spaceconcordia/Consat1Electrical/EPS/eps-v1-1-1-notes.txt

to test

if power is applied to the BCRs, with no battery attached, will they provide current to the regulators?
better BCRs
