spaceconcordia/Consat1Electrical/Wiring Harness/Consat1 Wiring Harness BOM.ods

ID | Part | Validate? | Manufacturer | Manufacturer Part # | Device | Package | Quantity | Description | Location | Value | Alt Value 1 | Alt Value 2 | Design Reference | Validation Note | URL
1 |  |  | Samtec | SMA-J-P-H-ST-PN2 | 50Ohm RF Con |  | 1 |  | ECU Mounted RF connector; ACS Area wiring harness
2 |  |  | Samtec | 415-0026-006 | 50Ohm RF Cable |  | 1 |  | RF cable; ACS Area wiring harness |  |  |  |  |  | http://www.digikey.ca/product-detail/en/415-0026-006/J3406-ND/457081
3
4 |  |  |  |  | DB25, male
5 |  |  |  |  | DB25, 2 sided?
6
7
8
9
10
11
12 |  |  | Harwin | M80-8120605 | DIL MALE SMALL BORE CRIMP CONN |  | 4 | 6 pin crimp connection | Solar Panel Mounted; GlenAir connector for power and thermistors; Payload Area |  |  |  |  |  | http://www.digikey.ca/product-search/en?keywords=M80-8120605
13 |  |  | Harwin | M80-8880605 | CONN RECEPT 2MM 6POS 24-28AWG |  | 4 | 6 pin crimp connection | Wiring harness, connect to solar panel connectors |  |  |  |  |  | http://www.digikey.ca/product-detail/en/M80-8880605/952-1197-ND/2264186
14 |  |  | Glenair | GLENAIR-171-006-6-S-6-7-18 |  |  | ? | 6 pin crimp | ???? possibly used to mount on solar panel
15
16
17
18
19
20
21
22
23
24
25
