spaceconcordia/Consat1Electrical/EPS/eps-v1-1-bom.ods

Sheet: EPS BOM
Part | Validate? | Manufacturer Part # | Device | Package | Description | Sub_Cct | Location | Value | Alt Value 1 | Alt Value 2 | Design Reference | Validation Note
C1 | No | ECH-U1H182GX5 | 1.8nF | C-USC0805 | IC4 (5v reg) compensation network cap | 5V_LTC3872 | EPS PCB
C2 | No | C0805C470J5GACTU | 47pF | C-USC0805 | IC4 (5v reg) compensation network cap | 5V_LTC3872 | EPS PCB
C3 | No | ECH-U1H101JX5 | 100pF | C-USC0805 | IC4 (5v reg) soft start timer cap | 5V_LTC3872 | EPS PCB
C4 | No | T530X157M016ATE015 | 150uF | CPOL-USD/7343-31R | IC4 (5v reg) output cap | 5V_LTC3872 | EPS PCB
C5 | No | C0805C222K5RACTU | 2.2nF | C-USC0805 | IC3 (9v reg) compensation network cap | 9V_LTC3872 | EPS PCB
C6 | No | ECH-U1H101JX5 | 100pF | C-USC0805 | IC3 (9v reg) compensation network cap | 9V_LTC3872 | EPS PCB
C7 | No | ECH-U1H101JX5 | 100pF | C-USC0805 | IC3 (9v reg) soft start timer cap | 9V_LTC3872 | EPS PCB
C8 | No | T530X157M016ATE015 | 150uF | CPOL-USD/7343-31R | IC3 (9v reg) output cap | 9V_LTC3872 | EPS PCB
C9 | No | C0805C104M3RACTU | 0.1uF | C-USC0805 | IC3 (9v reg) Vin decoupling capacitor | 9V_LTC3872 | EPS PCB
C10 | No | C0805C104M3RACTU | 0.1uF | C-USC0805 | IC4 (5v reg) Vin decoupling capacitor | 5V_LTC3872 | EPS PCB
C11 | Maybe | T530X157M016ATE015 | 150uF | CPOL-USD/7343-31R | IC4 (5v reg) input cap | 5V_LTC3872 | EPS PCB
C12 | No | T530X157M016ATE015 | 150uF | CPOL-USD/7343-31R | IC3 (9v reg) input cap | 9V_LTC3872 | EPS PCB
C13 | No | C0805C104M3RACTU | 0.1uF | C-USC0805 | IC5 (Bat. Telemtry) input filter cap | INA291_BATTLM | EPS PCB
C14 | No | C0805C104M3RACTU | 0.1uF | C-USC0805 | IC5 (Bat. Telemtry) decoupling cap | INA291_BATTLM | EPS PCB
C15 | No | C0805C104M3RACTU | 0.1uF | C-USC0805 | IC6 (Bat. Temp Ctrl) decoupling cap | HTRCTL_1 | EPS PCB
C16 | No | C0805C104M3RACTU | 0.1uF | C-USC0805 | IC7 (Bat. Temp Ctrl) decoupling cap | HTRCTL_2 | EPS PCB
C19 | No | C0805C105K8NACTU | 1uF | C-USC0805 | IC9 (General Telemtry) decoupling cap | AD7998_VTLM | EPS PCB
C20 | No | C0805C104M3RACTU | 0.1uF | C-USC0805 | IC9 (General Telemtry) decoupling cap | AD7998_VTLM | EPS PCB
D1 | No | PMEG3050EP,115 | PMEG3050EP | SOD128 | IC4 (5v reg) boost diode | 5V_LTC3872 | EPS PCB
D2 | No | PMEG3050EP,115 | PMEG3050EP | SOD128 | IC3 (9v reg) boost diode | 9V_LTC3872 | EPS PCB
D3 | No | PMEG3050EP,115 | PMEG3050EP | SOD128 | IC3 (9v reg) blocking diode | 9V_LTC3872 | EPS PCB
D4 | No | PMEG3050EP,115 | PMEG3050EP | SOD128 | IC4 (5v reg) blocking diode | 5V_LTC3872 | EPS PCB
H1 | No | ESQ-125-XX-X-D | ESQ-125-XX-X-D | 52 pin header | EPS to ECU interface | INTERFACE | EPS PCB
H2 | No | ESQ-125-XX-X-D | ESQ-125-XX-X-D | 52 pin header | EPS to ECU interface | INTERFACE | EPS PCB
IC1 | No | MIC79110-4.2YML TR | MIC79110 | MLF10-EP | MICREL 79110 Linear battery charger | MIC79110_BCR1 | EPS PCB
IC2 | No | MIC79110-4.2YML TR | MIC79110 | MLF10-EP | MICREL 79110 Linear battery charger | MIC79110_BCR2 | EPS PCB
IC3 | No | LTC3872ETS8#TRMPBF | LT3872 | TSOT23-8 | LTC3872 boost regulator, 5v | 5V_LTC3872 | EPS PCB
IC4 | No | LTC3872ETS8#TRMPBF | LT3872 | TSOT23-8 | LTC3872 boost regulator, 9v | 9V_LTC3872 | EPS PCB
IC5 | No | INA219AID | INA219-D | SO08 | Battery V-I-P telemetry, I2C bus | INA291_BATTLM | EPS PCB
IC6 | Maybe | NCS2200SN1T1G | NCS2200 | SOT23-5 | Battery Thermal Control Comparator | HTRCTL_1 | EPS PCB |  |  |  |  | Max Vin is 6v, need to verify that 5V line DOES NOT exceed this
IC7 | Maybe | NCS2200SN1T1G | NCS2200 | SOT23-5 | Battery Thermal Control Comparator | HTRCTL_2 | EPS PCB |  |  |  |  | Max Vin is 6v, need to verify that 5V line DOES NOT exceed this
IC8 | No | TLV70233DBVR | TLV70233DBVR | SOT23-5 | 3.3V linear regulator | 3_3V_REG | EPS PCB
IC9 | No | AD7998 | AD7998 | TSSOP-20 | Voltage A2D, General Telemetry, I2C bus | AD7998_VTLM | EPS PCB
IC10 | No | MAX4374-10UMAX | MAX4374-10UMAX | 10UMAX | Overcurrent Warning and Reset | OVI_RESET | EPS PCB
IC11 | No | TLV70228DBV | TLV70228DBV | SOT23-5 | 2.8V linear regulator | OVI_RESET | EPS PCB
L1 | No | DR125-2R2 | DR125-2R2 | 12.5x12.5 mm SMD | Inductor, Ferrite Core, IC4/5V boost regulator | 5V_LTC3872 | EPS PCB
L2 | No | DR125-8R2 | DR125-8R2 | 12.5x12.5 mm SMD | Inductor, Ferrite Core, IC4/9V boost regulator | 9V_LTC3872 | EPS PCB
Q1 | No | SI7448DP-T1-E3 | SI7448DP | PPAK-SO08-EP | nMOS, IC4 (5v boost reg) switching element | 5V_LTC3872 | EPS PCB
Q2 | No | SI7448DP-T1-E3 | SI7448DP | PPAK-SO08-EP | nMOS, IC3 (9v boost reg) switching element | 9V_LTC3872 | EPS PCB
Q3 | No | SI7448DP-T1-E3 | SI7448DP | PPAK-SO08-EP | nMOS, IC7, battery heater enable | HTRCTL_2 | EPS PCB
Q4 | No | SI7485DP-T1-GE3 | SI7485DP | PPAK-SO08-EP | pMOS, IC4/5V reg enable/reset switch, controlled by IC10 | OVI_RESET | EPS PCB
Q6 | No | SI7485DP-T1-GE3 | SI7485DP | PPAK-SO08-EP | pMOS, AHRM enable | AHRC | EPS PCB
Q8 | No | SI7485DP-T1-GE3 | SI7485DP | PPAK-SO08-EP | pMOS, IC3/9V reg enable | 9V_LTC3872 | EPS PCB
Q9 | No | SI7448DP-T1-E3 | SI7448DP | PPAK-SO08-EP | nMOS, IC6, battery heater enable | HTRCTL_1 | EPS PCB
R1 | No | ERJ-8ENF6342V | 63.4kOhm | R-US_M1206 | IC4 (5v reg) feedback voltage divider, top | 5V_LTC3872 | EPS PCB
R2 | No | ERJ-8ENF5493V | 549kOhm | R-US_M1206 | IC7 (Bat. Temp Ctrl) thermistor voltage divider, top | HTRCTL_2 | EPS PCB
R3 | No | ERJ-8ENF2003V | 200kOhm | R-US_M1206 | IC7 (Bat. Temp Ctrl) reference voltage divider, top | HTRCTL_2 | EPS PCB
R4 | No | ERJ-8ENF1742V | 17.4kOhm | R-US_M1206 | IC4 (5v reg) compensation network resistor | 5V_LTC3872 | EPS PCB
R5 | No | ERJ-8GEYJ203V | 20kOhm | R-US_M1206 | IC4 (5v reg) feedback voltage divider, bottom | 5V_LTC3872 | EPS PCB
R6 | No | ERJ-8GEYJ203V | 20kOhm | R-US_M1206 | Q8 Pullup resistor; 9V regulator control | 9V_LTC3872 | EPS PCB
R7 | No | ERJ-8ENF2322V | 23.2kOhm | R-US_M1206 | IC3 (9v reg) compensation network resistor | 9V_LTC3872 | EPS PCB
R8 | No | ERJ-8ENF1002V | 10kOhm | R-US_M1206 | IC3 (9v reg) feedback voltage divider, bottom | 9V_LTC3872 | EPS PCB
R9 | No | ERA-8AEB6492V | 64.9kOhm | R-US_M1206 | IC3 (9v reg) feedback voltage divider, top | 9V_LTC3872 | EPS PCB
R10 | No | ERJ-8ENF2213V | 221kOhm | R-US_M1206 | IC7 (Bat. Temp Ctrl) reference voltage divider, bottom | HTRCTL_2 | EPS PCB
R11 | No |  |  |  | IC7 (Bat. Temp Ctrl) output pullup resistor NOT NEEDED | HTRCTL_2 | EPS PCB
R12 | No | ERA-8AEB104V | 100kOhm | R-US_M1206 | IC9 (General Telemtry) pulldown resistor | AD7998_VTLM | EPS PCB
R13 | Maybe | ERJ-8BWJR010V | 0.01Ohm | R-US_M1206 | IC5 (Bat. Telemtry) sense resistor | INA291_BATTLM | EPS PCB
R14 | No | ERJ-8ENF10R0V | 10Ohm | R-US_M1206 | IC5 (Bat. Telemtry) input filter resistor | INA291_BATTLM | EPS PCB
R15 | No | ERJ-8ENF10R0V | 10Ohm | R-US_M1206 | IC5 (Bat. Telemtry) input filter resistor | INA291_BATTLM | EPS PCB
R16 | No | ERA-8AEB202V | 2kOhm | R-US_M1206 | IC2 (BCR) End-of-Charge set resistor | MIC79110_BCR2 | EPS PCB
R17 | No | ERJ-8ENF3400V | 340Ohm | R-US_M1206 | IC2 (BCR) Current-Charge set resistor | MIC79110_BCR2 | EPS PCB
R18 | No | RMCF1206FT3M40 | 3.4MOhm | R-US_M1206 | IC2 (BCR) voltage-divider, top, charge cycle reset comparison | MIC79110_BCR2 | EPS PCB
R19 | No | ERJ-8ENF1004V | 1MOhm | R-US_M1206 | IC2 (BCR) voltage-divider, bottom, charge cycle reset comparison | MIC79110_BCR2 | EPS PCB
R20 | No | ERA-8AEB202V | 2kOhm | R-US_M1206 | IC1 (BCR) End-of-Charge set resistor | MIC79110_BCR1 | EPS PCB
R21 | No | ERJ-8ENF3400V | 340Ohm | R-US_M1206 | IC1 (BCR) Current-Charge set resistor | MIC79110_BCR1 | EPS PCB
R22 | No | RMCF1206FT3M40 | 3.4MOhm | R-US_M1206 | IC1 (BCR) voltage-divider, top, charge cycle reset comparison | MIC79110_BCR1 | EPS PCB
R23 | No | ERJ-8ENF1004V | 1MOhm | R-US_M1206 | IC1 (BCR) voltage-divider, bottom, charge cycle reset comparison | MIC79110_BCR1 | EPS PCB
R24 | No | ERJ-8GEYJ203V | 20kOhm | R-US_M1206 | Q6 Pullup resistor; AHRM control | AHRC | EPS PCB
R25 | No | ERJ-8ENF5493V | 549kOhm | R-US_M1206 | IC6 (Bat. Temp Ctrl) thermistor voltage divider, top | HTRCTL_1 | EPS PCB
R26 | No | ERJ-8ENF2003V | 200kOhm | R-US_M1206 | IC6 (Bat. Temp Ctrl) reference voltage divider, top | HTRCTL_1 | EPS PCB
R27 | No | ERJ-8ENF2213V | 221kOhm | R-US_M1206 | IC6 (Bat. Temp Ctrl) reference voltage divider, bottom | HTRCTL_1 | EPS PCB
R28 | No |  |  |  | IC6 (Bat. Temp Ctrl) output pullup resistor NOT NEEDED | HTRCTL_1 | EPS PCB
R29 | No | ERJ-8ENF1473V | 147kOhm | R-US_M1206 | IC10 (Current OP) voltage-divider, top, current reset comparison | OVI_RESET | EPS PCB
R30 | No | ERJ-8ENF1333V | 133kOhm | R-US_M1206 | IC10 (Current OP) voltage-divider, top, current warning comparison | OVI_RESET | EPS PCB
R31 | No | ERJ-8ENF6342V | 63.4kOhm | R-US_M1206 | IC10 (Current OP) voltage-divider, bottom, current warning comparison | OVI_RESET | EPS PCB
R32 | No | ERJ-8ENF5362V | 53.6kOhm | R-US_M1206 | IC10 (Current OP) voltage-divider, bottom, current reset comparison | OVI_RESET | EPS PCB
R33 | No | ERJ-8ENF1004V | 1MOhm | R-US_M1206 | IC9 (General Telemtry) voltage-divider, bottom, SP1_3 measurement | AD7998_VTLM | EPS PCB
R34 | No | ERJ-8ENF2004V | 2MOhm | R-US_M1206 | IC9 (General Telemtry) voltage-divider, top, SP1_3 measurement | AD7998_VTLM | EPS PCB
R35 | No | ERJ-8ENF1004V | 1MOhm | R-US_M1206 | IC9 (General Telemtry) voltage-divider, bottom, SP2_4 measurement | AD7998_VTLM | EPS PCB
R36 | No | ERJ-8ENF2004V | 2MOhm | R-US_M1206 | IC9 (General Telemtry) voltage-divider, top, SP2_4 measurement | AD7998_VTLM | EPS PCB
R37 | No | WSL1206R0300FEA | 0.03Ohm | R-US_M1206 | IC10 (Current OP) sense resistor | OVI_RESET | EPS PCB
R38 | No | ERJ-8GEYJ203V | 20kOhm | R-US_M1206 | IC10 (Current OP) pullup resistor, current warning signal | OVI_RESET | EPS PCB
R39 | No | ERJ-8GEYJ203V | 20kOhm | R-US_M1206 | Q4 Pullup resistor; 5V regulator enable/reset | 5V_LTC3872 | EPS PCB
EXT1 | No | RL2007-1723-103-SA | 3kOhm | through-hole | thermistor, NTC | SLRPNL_1 | Solar Panel1
EXT2 | No | RL2007-1723-103-SA | 3kOhm | through-hole | thermistor, NTC | SLRPNL_1 | Solar Panel1
EXT3 | No | 3G30SCA | Photovoltaic Cell |  | AzurSpace 3G30A Solar cell, Coverglass and CIC Interconnects | SLRPNL_1 | Solar Panel1
EXT4 | No | 3G30SCA | Photovoltaic Cell |  | AzurSpace 3G30A Solar cell, Coverglass and CIC Interconnects | SLRPNL_1 | Solar Panel1
EXT5 | No | 3G30SCA | Photovoltaic Cell |  | AzurSpace 3G30A Solar cell, Coverglass and CIC Interconnects | SLRPNL_1 | Solar Panel1
EXT6 | No | 3G30SCA | Photovoltaic Cell |  | AzurSpace 3G30A Solar cell, Coverglass and CIC Interconnects | SLRPNL_1 | Solar Panel1
EXT7 | No | 3G30SCA | Photovoltaic Cell |  | AzurSpace 3G30A Solar cell, Coverglass and CIC Interconnects | SLRPNL_1 | Solar Panel1
EXT8 | No | 3G30SCA | Photovoltaic Cell |  | AzurSpace 3G30A Solar cell, Coverglass and CIC Interconnects | SLRPNL_1 | Solar Panel1
EXT9 | No | RL2007-1723-103-SA | 3kOhm | through-hole | thermistor, NTC | SLRPNL_2 | Solar Panel2
EXT10 | No | RL2007-1723-103-SA | 3kOhm | through-hole | thermistor, NTC | SLRPNL_2 | Solar Panel2
EXT11 | No | 3G30SCA | Photovoltaic Cell |  | AzurSpace 3G30A Solar cell, Coverglass and CIC Interconnects | SLRPNL_2 | Solar Panel2
EXT12 | No | 3G30SCA | Photovoltaic Cell |  | AzurSpace 3G30A Solar cell, Coverglass and CIC Interconnects | SLRPNL_2 | Solar Panel2
EXT13 | No | 3G30SCA | Photovoltaic Cell |  | AzurSpace 3G30A Solar cell, Coverglass and CIC Interconnects | SLRPNL_2 | Solar Panel2
EXT14 | No | 3G30SCA | Photovoltaic Cell |  | AzurSpace 3G30A Solar cell, Coverglass and CIC Interconnects | SLRPNL_2 | Solar Panel2
EXT15 | No | 3G30SCA | Photovoltaic Cell |  | AzurSpace 3G30A Solar cell, Coverglass and CIC Interconnects | SLRPNL_2 | Solar Panel2
EXT16 | No | 3G30SCA | Photovoltaic Cell |  | AzurSpace 3G30A Solar cell, Coverglass and CIC Interconnects | SLRPNL_2 | Solar Panel2
EXT17 | No | RL2007-1723-103-SA | 3kOhm | through-hole | thermistor, NTC | SLRPNL_3 | Solar Panel3
EXT18 | No | RL2007-1723-103-SA | 3kOhm | through-hole | thermistor, NTC | SLRPNL_3 | Solar Panel3
EXT19 | No | 3G30SCA | Photovoltaic Cell |  | AzurSpace 3G30A Solar cell, Coverglass and CIC Interconnects | SLRPNL_3 | Solar Panel3
EXT20 | No | 3G30SCA | Photovoltaic Cell |  | AzurSpace 3G30A Solar cell, Coverglass and CIC Interconnects | SLRPNL_3 | Solar Panel3
EXT21 | No | 3G30SCA | Photovoltaic Cell |  | AzurSpace 3G30A Solar cell, Coverglass and CIC Interconnects | SLRPNL_3 | Solar Panel3
EXT22 | No | 3G30SCA | Photovoltaic Cell |  | AzurSpace 3G30A Solar cell, Coverglass and CIC Interconnects | SLRPNL_3 | Solar Panel3
EXT23 | No | 3G30SCA | Photovoltaic Cell |  | AzurSpace 3G30A Solar cell, Coverglass and CIC Interconnects | SLRPNL_3 | Solar Panel3
EXT24 | No | 3G30SCA | Photovoltaic Cell |  | AzurSpace 3G30A Solar cell, Coverglass and CIC Interconnects | SLRPNL_3 | Solar Panel3
EXT25 | No | RL2007-1723-103-SA | 3kOhm | through-hole | thermistor, NTC | SLRPNL_4 | Solar Panel4
EXT26 | No | RL2007-1723-103-SA | 3kOhm | through-hole | thermistor, NTC | SLRPNL_4 | Solar Panel4
EXT27 | No | 3G30SCA | Photovoltaic Cell |  | AzurSpace 3G30A Solar cell, Coverglass and CIC Interconnects | SLRPNL_4 | Solar Panel4
EXT28 | No | 3G30SCA | Photovoltaic Cell |  | AzurSpace 3G30A Solar cell, Coverglass and CIC Interconnects | SLRPNL_4 | Solar Panel4
EXT29 | No | 3G30SCA | Photovoltaic Cell |  | AzurSpace 3G30A Solar cell, Coverglass and CIC Interconnects | SLRPNL_4 | Solar Panel4
EXT30 | No | 3G30SCA | Photovoltaic Cell |  | AzurSpace 3G30A Solar cell, Coverglass and CIC Interconnects | SLRPNL_4 | Solar Panel4
EXT31 | No | 3G30SCA | Photovoltaic Cell |  | AzurSpace 3G30A Solar cell, Coverglass and CIC Interconnects | SLRPNL_4 | Solar Panel4
EXT32 | No | 3G30SCA | Photovoltaic Cell |  | AzurSpace 3G30A Solar cell, Coverglass and CIC Interconnects | SLRPNL_4 | Solar Panel4
EXT33 | No | 1N5817-E3/54 |  |  | diode, schottky, 1A, blocking diode | SLRPNL_HRNS | Wiring Harness
EXT34 | No | 1N5817-E3/54 |  |  | diode, schottky, 1A, blocking diode | SLRPNL_HRNS | Wiring Harness
EXT35 | No | 1N5817-E3/54 |  |  | diode, schottky, 1A, blocking diode | SLRPNL_HRNS | Wiring Harness
EXT36 | No | 1N5817-E3/54 |  |  | diode, schottky, 1A, blocking diode | SLRPNL_HRNS | Wiring Harness
EXT37 | No | P0115-RA100 |  |  | Allflex 115ohm Polymide Heater | HTRCTL_1,HTRCTL_2 | Battery Pack
EXT38 | No | P0115-RA100 |  |  | Allflex 115ohm Polymide Heater | HTRCTL_1,HTRCTL_2 | Battery Pack
EXT39 | No | P0115-RA100 |  |  | Allflex 115ohm Polymide Heater | HTRCTL_1,HTRCTL_2 | Battery Pack
EXT40 | No | P0115-RA100 |  |  | Allflex 115ohm Polymide Heater | HTRCTL_1,HTRCTL_2 | Battery Pack
EXT41 | No | P0115-RA100 |  |  | Allflex 115ohm Polymide Heater | HTRCTL_1,HTRCTL_2 | Battery Pack
EXT42 | No | P0115-RA100 |  |  | Allflex 115ohm Polymide Heater | HTRCTL_1,HTRCTL_2 | Battery Pack
EXT43 | No | P0115-RA100 |  |  | Allflex 115ohm Polymide Heater | HTRCTL_1,HTRCTL_2 | Battery Pack
EXT44 | No | P0115-RA100 |  |  | Allflex 115ohm Polymide Heater | HTRCTL_1,HTRCTL_2 | Battery Pack
EXT45 | No | P0115-RA100 |  |  | Allflex 115ohm Polymide Heater | HTRCTL_1,HTRCTL_2 | Battery Pack
EXT46 | No | P0115-RA100 |  |  | Allflex 115ohm Polymide Heater | HTRCTL_1,HTRCTL_2 | Battery Pack
EXT47 | No | P0115-RA100 |  |  | Allflex 115ohm Polymide Heater | HTRCTL_1,HTRCTL_2 | Battery Pack
EXT48 | No | P0115-RA100 |  |  | Allflex 115ohm Polymide Heater | HTRCTL_1,HTRCTL_2 | Battery Pack
EXT49 | No | MF52A1224J4150 | 220kOhm | through-hole | THERMISTOR NTC 220K OHM 5% | HTRCTL_1 | Battery Pack
EXT50 | No | MF52A1224J4150 | 220kOhm | through-hole | THERMISTOR NTC 220K OHM 5% | HTRCTL_2 | Battery Pack
EXT51 | No | # 30006 | 2.6Ah, 3.7V | 18650-CRG | Battery, Lithium-Ion, Tenergy 18650CRG | BATT_PACK | Battery Pack
EXT52 | No | # 30006 | 2.6Ah, 3.7V | 18650-CRG | Battery, Lithium-Ion, Tenergy 18650CRG | BATT_PACK | Battery Pack
EXT53 | No | # 30006 | 2.6Ah, 3.7V | 18650-CRG | Battery, Lithium-Ion, Tenergy 18650CRG | BATT_PACK | Battery Pack
EXT54 | No | # 30006 | 2.6Ah, 3.7V | 18650-CRG | Battery, Lithium-Ion, Tenergy 18650CRG | BATT_PACK | Battery Pack
EXT55 | No | 952-2111-ND |  |  | DIL, male, crimp interconnect | SLRPNL_1 | Solar Panel1
EXT56 | No | 952-2111-ND |  |  | DIL, male, crimp interconnect | SLRPNL_2 | Solar Panel2
EXT57 | No | 952-2111-ND |  |  | DIL, male, crimp interconnect | SLRPNL_3 | Solar Panel3
EXT58 | No | 952-2111-ND |  |  | DIL, male, crimp interconnect | SLRPNL_4 | Solar Panel4

Sheet: EPS BOM_by_SubCct
Part | Manufacturer Part # | Description | Sub_Cct | Location | Value | Alt Value 1 | Alt Value 2 | Design Reference | Validation Note
IC8 | TLV70233DBVR | 3.3V linear regulator | 3_3V_REG | EPS PCB
C1 | ECH-U1H182GX5 | IC4 (5v reg) compensation network cap | 5V_LTC3872 | EPS PCB
C2 | C0805C470J5GACTU | IC4 (5v reg) compensation network cap | 5V_LTC3872 | EPS PCB
C3 | ECH-U1H101JX5 | IC4 (5v reg) soft start timer cap | 5V_LTC3872 | EPS PCB
C4 | T530X157M016ATE015 | IC4 (5v reg) output cap | 5V_LTC3872 | EPS PCB
C10 | C0805C104M3RACTU | IC4 (5v reg) Vin decoupling capacitor | 5V_LTC3872 | EPS PCB
C11 | T530X157M016ATE015 | IC4 (5v reg) input cap | 5V_LTC3872 | EPS PCB
D1 | PMEG3050EP,115 | IC4 (5v reg) boost diode | 5V_LTC3872 | EPS PCB
D4 | PMEG3050EP,115 | IC4 (5v reg) blocking diode | 5V_LTC3872 | EPS PCB
IC3 | LTC3872ETS8#TRMPBF | LTC3872 boost regulator, 5v | 5V_LTC3872 | EPS PCB
L1 | DR125-2R2 | Inductor, Ferrite Core, IC4/5V boost regulator | 5V_LTC3872 | EPS PCB
Q1 | SI7448DP-T1-E3 | nMOS, IC4 (5v boost reg) switching element | 5V_LTC3872 | EPS PCB
R1 | ERJ-8ENF6342V | IC4 (5v reg) feedback voltage divider, top | 5V_LTC3872 | EPS PCB
R4 | ERJ-8ENF1742V | IC4 (5v reg) compensation network resistor | 5V_LTC3872 | EPS PCB
R5 | ERJ-8GEYJ203V | IC4 (5v reg) feedback voltage divider, bottom | 5V_LTC3872 | EPS PCB
R39 | ERJ-8GEYJ203V | Q4 Pullup resistor; 5V regulator enable/reset | 5V_LTC3872 | EPS PCB
C5 | C0805C222K5RACTU | IC3 (9v reg) compensation network cap | 9V_LTC3872 | EPS PCB
C6 | ECH-U1H101JX5 | IC3 (9v reg) compensation network cap | 9V_LTC3872 | EPS PCB
C7 | ECH-U1H101JX5 | IC3 (9v reg) soft start timer cap | 9V_LTC3872 | EPS PCB
C8 | T530X157M016ATE015 | IC3 (9v reg) output cap | 9V_LTC3872 | EPS PCB
C9 | C0805C104M3RACTU | IC3 (9v reg) Vin decoupling capacitor | 9V_LTC3872 | EPS PCB
C12 | T530X157M016ATE015 | IC3 (9v reg) input cap | 9V_LTC3872 | EPS PCB
D2 | PMEG3050EP,115 | IC3 (9v reg) boost diode | 9V_LTC3872 | EPS PCB
D3 | PMEG3050EP,115 | IC3 (9v reg) blocking diode | 9V_LTC3872 | EPS PCB
IC4 | LTC3872ETS8#TRMPBF | LTC3872 boost regulator, 9v | 9V_LTC3872 | EPS PCB
L2 | DR125-8R2 | Inductor, Ferrite Core, IC4/9V boost regulator | 9V_LTC3872 | EPS PCB
Q2 | SI7448DP-T1-E3 | nMOS, IC3 (9v boost reg) switching element | 9V_LTC3872 | EPS PCB
Q8 | SI7485DP-T1-GE3 | pMOS, IC3/9V reg enable | 9V_LTC3872 | EPS PCB
R6 | ERJ-8GEYJ203V | Q8 Pullup resistor; 9V regulator control | 9V_LTC3872 | EPS PCB
R7 | ERJ-8ENF2322V | IC3 (9v reg) compensation network resistor | 9V_LTC3872 | EPS PCB
R8 | ERJ-8ENF1002V | IC3 (9v reg) feedback voltage divider, bottom | 9V_LTC3872 | EPS PCB
R9 | ERA-8AEB6492V | IC3 (9v reg) feedback voltage divider, top | 9V_LTC3872 | EPS PCB
C19 | C0805C105K8NACTU | IC9 (General Telemtry) decoupling cap | AD7998_VTLM | EPS PCB
C20 | C0805C104M3RACTU | IC9 (General Telemtry) decoupling cap | AD7998_VTLM | EPS PCB
IC9 | AD7998 | Voltage A2D, General Telemetry, I2C bus | AD7998_VTLM | EPS PCB
R12 | ERA-8AEB104V | IC9 (General Telemtry) pulldown resistor | AD7998_VTLM | EPS PCB
R33 | ERJ-8ENF1004V | IC9 (General Telemtry) voltage-divider, bottom, SP1_3 measurement | AD7998_VTLM | EPS PCB
R34 | ERJ-8ENF2004V | IC9 (General Telemtry) voltage-divider, top, SP1_3 measurement | AD7998_VTLM | EPS PCB
R35 | ERJ-8ENF1004V | IC9 (General Telemtry) voltage-divider, bottom, SP2_4 measurement | AD7998_VTLM | EPS PCB
R36 | ERJ-8ENF2004V | IC9 (General Telemtry) voltage-divider, top, SP2_4 measurement | AD7998_VTLM | EPS PCB
Q6 | SI7485DP-T1-GE3 | pMOS, AHRM enable | AHRC | EPS PCB
R24 | ERJ-8GEYJ203V | Q6 Pullup resistor; AHRM control | AHRC | EPS PCB
EXT51 | # 30006 | Battery, Lithium-Ion, Tenergy 18650CRG | BATT_PACK | Battery Pack
EXT52 | # 30006 | Battery, Lithium-Ion, Tenergy 18650CRG | BATT_PACK | Battery Pack
EXT53 | # 30006 | Battery, Lithium-Ion, Tenergy 18650CRG | BATT_PACK | Battery Pack
EXT54 | # 30006 | Battery, Lithium-Ion, Tenergy 18650CRG | BATT_PACK | Battery Pack
C15 | C0805C104M3RACTU | IC6 (Bat. Temp Ctrl) decoupling cap | HTRCTL_1 | EPS PCB
IC6 | NCS2200SN1T1G | Battery Thermal Control Comparator | HTRCTL_1 | EPS PCB |  |  |  |  | Max Vin is 6v, need to verify that 5V line DOES NOT exceed this
Q9 | SI7448DP-T1-E3 | nMOS, IC6, battery heater enable | HTRCTL_1 | EPS PCB
R25 | ERJ-8ENF5493V | IC6 (Bat. Temp Ctrl) thermistor voltage divider, top | HTRCTL_1 | EPS PCB
R26 | ERJ-8ENF2003V | IC6 (Bat. Temp Ctrl) reference voltage divider, top | HTRCTL_1 | EPS PCB
R27 | ERJ-8ENF2213V | IC6 (Bat. Temp Ctrl) reference voltage divider, bottom | HTRCTL_1 | EPS PCB
R28 |  | IC6 (Bat. Temp Ctrl) output pullup resistor NOT NEEDED | HTRCTL_1 | EPS PCB
EXT49 | MF52A1224J4150 | THERMISTOR NTC 220K OHM 5% | HTRCTL_1 | Battery Pack
EXT37 | P0115-RA100 | Allflex 115ohm Polymide Heater | HTRCTL_1,HTRCTL_2 | Battery Pack
EXT38 | P0115-RA100 | Allflex 115ohm Polymide Heater | HTRCTL_1,HTRCTL_2 | Battery Pack
EXT39 | P0115-RA100 | Allflex 115ohm Polymide Heater | HTRCTL_1,HTRCTL_2 | Battery Pack
EXT40 | P0115-RA100 | Allflex 115ohm Polymide Heater | HTRCTL_1,HTRCTL_2 | Battery Pack
EXT41 | P0115-RA100 | Allflex 115ohm Polymide Heater | HTRCTL_1,HTRCTL_2 | Battery Pack
EXT42 | P0115-RA100 | Allflex 115ohm Polymide Heater | HTRCTL_1,HTRCTL_2 | Battery Pack
EXT43 | P0115-RA100 | Allflex 115ohm Polymide Heater | HTRCTL_1,HTRCTL_2 | Battery Pack
EXT44 | P0115-RA100 | Allflex 115ohm Polymide Heater | HTRCTL_1,HTRCTL_2 | Battery Pack
EXT45 | P0115-RA100 | Allflex 115ohm Polymide Heater | HTRCTL_1,HTRCTL_2 | Battery Pack
EXT46 | P0115-RA100 | Allflex 115ohm Polymide Heater | HTRCTL_1,HTRCTL_2 | Battery Pack
EXT47 | P0115-RA100 | Allflex 115ohm Polymide Heater | HTRCTL_1,HTRCTL_2 | Battery Pack
EXT48 | P0115-RA100 | Allflex 115ohm Polymide Heater | HTRCTL_1,HTRCTL_2 | Battery Pack
C16 | C0805C104M3RACTU | IC7 (Bat. Temp Ctrl) decoupling cap | HTRCTL_2 | EPS PCB
IC7 | NCS2200SN1T1G | Battery Thermal Control Comparator | HTRCTL_2 | EPS PCB |  |  |  |  | Max Vin is 6v, need to verify that 5V line DOES NOT exceed this
Q3 | SI7448DP-T1-E3 | nMOS, IC7, battery heater enable | HTRCTL_2 | EPS PCB
R2 | ERJ-8ENF5493V | IC7 (Bat. Temp Ctrl) thermistor voltage divider, top | HTRCTL_2 | EPS PCB
R3 | ERJ-8ENF2003V | IC7 (Bat. Temp Ctrl) reference voltage divider, top | HTRCTL_2 | EPS PCB
R10 | ERJ-8ENF2213V | IC7 (Bat. Temp Ctrl) reference voltage divider, bottom | HTRCTL_2 | EPS PCB
R11 |  | IC7 (Bat. Temp Ctrl) output pullup resistor NOT NEEDED | HTRCTL_2 | EPS PCB
EXT50 | MF52A1224J4150 | THERMISTOR NTC 220K OHM 5% | HTRCTL_2 | Battery Pack
C13 | C0805C104M3RACTU | IC5 (Bat. Telemtry) input filter cap | INA291_BATTLM | EPS PCB
C14 | C0805C104M3RACTU | IC5 (Bat. Telemtry) decoupling cap | INA291_BATTLM | EPS PCB
IC5 | INA219AID | Battery V-I-P telemetry, I2C bus | INA291_BATTLM | EPS PCB
R13 | ERJ-8BWJR010V | IC5 (Bat. Telemtry) sense resistor | INA291_BATTLM | EPS PCB
R14 | ERJ-8ENF10R0V | IC5 (Bat. Telemtry) input filter resistor | INA291_BATTLM | EPS PCB
R15 | ERJ-8ENF10R0V | IC5 (Bat. Telemtry) input filter resistor | INA291_BATTLM | EPS PCB
H1 | ESQ-125-XX-X-D | EPS to ECU interface | INTERFACE | EPS PCB
H2 | ESQ-125-XX-X-D | EPS to ECU interface | INTERFACE | EPS PCB
IC1 | MIC79110-4.2YML TR | MICREL 79110 Linear battery charger | MIC79110_BCR1 | EPS PCB
R20 | ERA-8AEB202V | IC1 (BCR) End-of-Charge set resistor | MIC79110_BCR1 | EPS PCB
R21 | ERJ-8ENF3400V | IC1 (BCR) Current-Charge set resistor | MIC79110_BCR1 | EPS PCB
R22 | RMCF1206FT3M40 | IC1 (BCR) voltage-divider, top, charge cycle reset comparison | MIC79110_BCR1 | EPS PCB
R23 | ERJ-8ENF1004V | IC1 (BCR) voltage-divider, bottom, charge cycle reset comparison | MIC79110_BCR1 | EPS PCB
IC2 | MIC79110-4.2YML TR | MICREL 79110 Linear battery charger | MIC79110_BCR2 | EPS PCB
R16 | ERA-8AEB202V | IC2 (BCR) End-of-Charge set resistor | MIC79110_BCR2 | EPS PCB
R17 | ERJ-8ENF3400V | IC2 (BCR) Current-Charge set resistor | MIC79110_BCR2 | EPS PCB
R18 | RMCF1206FT3M40 | IC2 (BCR) voltage-divider, top, charge cycle reset comparison | MIC79110_BCR2 | EPS PCB
R19 | ERJ-8ENF1004V | IC2 (BCR) voltage-divider, bottom, charge cycle reset comparison | MIC79110_BCR2 | EPS PCB
IC10 | MAX4374-10UMAX | Overcurrent Warning and Reset | OVI_RESET | EPS PCB
IC11 | TLV70228DBV | 2.8V linear regulator | OVI_RESET | EPS PCB
Q4 | SI7485DP-T1-GE3 | pMOS, IC4/5V reg enable/reset switch, controlled by IC10 | OVI_RESET | EPS PCB
R29 | ERJ-8ENF1473V | IC10 (Current OP) voltage-divider, top, current reset comparison | OVI_RESET | EPS PCB
R30 | ERJ-8ENF1333V | IC10 (Current OP) voltage-divider, top, current warning comparison | OVI_RESET | EPS PCB
R31 | ERJ-8ENF6342V | IC10 (Current OP) voltage-divider, bottom, current warning comparison | OVI_RESET | EPS PCB
R32 | ERJ-8ENF5362V | IC10 (Current OP) voltage-divider, bottom, current reset comparison | OVI_RESET | EPS PCB
R37 | WSL1206R0300FEA | IC10 (Current OP) sense resistor | OVI_RESET | EPS PCB
R38 | ERJ-8GEYJ203V | IC10 (Current OP) pullup resistor, current warning signal | OVI_RESET | EPS PCB
EXT1 | RL2007-1723-103-SA | thermistor, NTC | SLRPNL_1 | Solar Panel1
EXT2 | RL2007-1723-103-SA | thermistor, NTC | SLRPNL_1 | Solar Panel1
EXT3 | 3G30SCA | AzurSpace 3G30A Solar cell, Coverglass and CIC Interconnects | SLRPNL_1 | Solar Panel1
EXT4 | 3G30SCA | AzurSpace 3G30A Solar cell, Coverglass and CIC Interconnects | SLRPNL_1 | Solar Panel1
EXT5 | 3G30SCA | AzurSpace 3G30A Solar cell, Coverglass and CIC Interconnects | SLRPNL_1 | Solar Panel1
EXT6 | 3G30SCA | AzurSpace 3G30A Solar cell, Coverglass and CIC Interconnects | SLRPNL_1 | Solar Panel1
EXT7 | 3G30SCA | AzurSpace 3G30A Solar cell, Coverglass and CIC Interconnects | SLRPNL_1 | Solar Panel1
EXT8 | 3G30SCA | AzurSpace 3G30A Solar cell, Coverglass and CIC Interconnects | SLRPNL_1 | Solar Panel1
EXT55 | 952-2111-ND | DIL, male, crimp interconnect | SLRPNL_1 | Solar Panel1
EXT9 | RL2007-1723-103-SA | thermistor, NTC | SLRPNL_2 | Solar Panel2
EXT10 | RL2007-1723-103-SA | thermistor, NTC | SLRPNL_2 | Solar Panel2
EXT11 | 3G30SCA | AzurSpace 3G30A Solar cell, Coverglass and CIC Interconnects | SLRPNL_2 | Solar Panel2
EXT12 | 3G30SCA | AzurSpace 3G30A Solar cell, Coverglass and CIC Interconnects | SLRPNL_2 | Solar Panel2
EXT13 | 3G30SCA | AzurSpace 3G30A Solar cell, Coverglass and CIC Interconnects | SLRPNL_2 | Solar Panel2
EXT14 | 3G30SCA | AzurSpace 3G30A Solar cell, Coverglass and CIC Interconnects | SLRPNL_2 | Solar Panel2
EXT15 | 3G30SCA | AzurSpace 3G30A Solar cell, Coverglass and CIC Interconnects | SLRPNL_2 | Solar Panel2
EXT16 | 3G30SCA | AzurSpace 3G30A Solar cell, Coverglass and CIC Interconnects | SLRPNL_2 | Solar Panel2
EXT56 | 952-2111-ND | DIL, male, crimp interconnect | SLRPNL_2 | Solar Panel2
EXT17 | RL2007-1723-103-SA | thermistor, NTC | SLRPNL_3 | Solar Panel3
EXT18 | RL2007-1723-103-SA | thermistor, NTC | SLRPNL_3 | Solar Panel3
EXT19 | 3G30SCA | AzurSpace 3G30A Solar cell, Coverglass and CIC Interconnects | SLRPNL_3 | Solar Panel3
EXT20 | 3G30SCA | AzurSpace 3G30A Solar cell, Coverglass and CIC Interconnects | SLRPNL_3 | Solar Panel3
EXT21 | 3G30SCA | AzurSpace 3G30A Solar cell, Coverglass and CIC Interconnects | SLRPNL_3 | Solar Panel3
EXT22 | 3G30SCA | AzurSpace 3G30A Solar cell, Coverglass and CIC Interconnects | SLRPNL_3 | Solar Panel3
EXT23 | 3G30SCA | AzurSpace 3G30A Solar cell, Coverglass and CIC Interconnects | SLRPNL_3 | Solar Panel3
EXT24 | 3G30SCA | AzurSpace 3G30A Solar cell, Coverglass and CIC Interconnects | SLRPNL_3 | Solar Panel3
EXT57 | 952-2111-ND | DIL, male, crimp interconnect | SLRPNL_3 | Solar Panel3
EXT25 | RL2007-1723-103-SA | thermistor, NTC | SLRPNL_4 | Solar Panel4
EXT26 | RL2007-1723-103-SA | thermistor, NTC | SLRPNL_4 | Solar Panel4
EXT27 | 3G30SCA | AzurSpace 3G30A Solar cell, Coverglass and CIC Interconnects | SLRPNL_4 | Solar Panel4
EXT28 | 3G30SCA | AzurSpace 3G30A Solar cell, Coverglass and CIC Interconnects | SLRPNL_4 | Solar Panel4
EXT29 | 3G30SCA | AzurSpace 3G30A Solar cell, Coverglass and CIC Interconnects | SLRPNL_4 | Solar Panel4
EXT30 | 3G30SCA | AzurSpace 3G30A Solar cell, Coverglass and CIC Interconnects | SLRPNL_4 | Solar Panel4
EXT31 | 3G30SCA | AzurSpace 3G30A Solar cell, Coverglass and CIC Interconnects | SLRPNL_4 | Solar Panel4
EXT32 | 3G30SCA | AzurSpace 3G30A Solar cell, Coverglass and CIC Interconnects | SLRPNL_4 | Solar Panel4
EXT58 | 952-2111-ND | DIL, male, crimp interconnect | SLRPNL_4 | Solar Panel4
EXT33 | 1N5817-E3/54 | diode, schottky, 1A, blocking diode | SLRPNL_HRNS | Wiring Harness
EXT34 | 1N5817-E3/54 | diode, schottky, 1A, blocking diode | SLRPNL_HRNS | Wiring Harness
EXT35 | 1N5817-E3/54 | diode, schottky, 1A, blocking diode | SLRPNL_HRNS | Wiring Harness
EXT36 | 1N5817-E3/54 | diode, schottky, 1A, blocking diode | SLRPNL_HRNS | Wiring Harness

Sheet: BOM by Quantity
Index # | Manufacturer Part # | Quantity/PCB | In stock | To order | Final Qty | Ok?
1 | 1N5817-E3/54 | 4 | 6 | 10 | 16 | Need More!
2 | #30006 | 4 | 5 |  | 5 | Need More!
3 | 3G30SCA | 24 | 30 |  | 30 | ok
4 | 952-2111-ND | 4 | 12 |  | 12 | Need More!
5 | AD7998 | 1 | 5 |  | 5 | ok
6 | C0805C104M3RACTU | 7 | 6 | 40 | 46 | ok
7 | C0805C105K8NACTU | 1 |  | 10 | 10 | ok
8 | C0805C222K5RACTU | 1 | 9 |  | 9 | ok
9 | C0805C470J5GACTU | 1 | 9 |  | 9 | ok
10 | DR125-2R2 | 1 |  | 6 | 6 | ok
11 | DR125-8R2 | 1 |  | 6 | 6 | ok
12 | ECH-U1H101JX5 | 3 | 17 |  | 17 | ok
13 | ECH-U1H182GX5 | 1 | 9 |  | 9 | ok
14 | ERA-8AEB104V | 1 |  | 10 | 10 | ok
15 | ERA-8AEB202V | 2 |  | 10 | 10 | ok
16 | ERA-8AEB6492V | 1 |  | 10 | 10 | ok
17 | ERJ-8BWJR010V | 1 | 10 |  | 10 | ok
18 | ERJ-8ENF1002V | 1 |  | 10 | 10 | ok
19 | ERJ-8ENF1004V | 4 | 8 | 20 | 28 | ok
20 | ERJ-8ENF10R0V | 2 | 18 |  | 18 | ok
21 | ERJ-8ENF1333V | 1 |  | 10 | 10 | ok
22 | ERJ-8ENF1473V | 1 |  | 10 | 10 | ok
23 | ERJ-8ENF1742V | 1 | 9 |  | 9 | ok
24 | ERJ-8ENF2003V | 2 |  | 20 | 20 | ok
25 | ERJ-8ENF2004V | 2 |  | 20 | 20 | ok
26 | ERJ-8ENF2213V | 2 |  | 20 | 20 | ok
27 | ERJ-8ENF2322V | 1 | 9 |  | 9 | ok
28 | ERJ-8ENF3400V | 2 |  | 20 | 20 | ok
29 | ERJ-8ENF5362V | 1 |  | 10 | 10 | ok
30 | ERJ-8ENF5493V | 2 |  | 20 | 20 | ok
31 | ERJ-8ENF6342V | 2 | 9 | 5 | 14 | ok
32 | ERJ-8GEYJ203V | 5 | 13 | 20 | 33 | ok
33 | ESQ-125-XX-X-D | 2 |  |  | 0 | Need More!
34 | INA219AID | 1 | 2 | 6 | 8 | ok
35 | LTC3872ETS8#TRMPBF | 2 | 3 | 8 | 11 | ok
36 | MAX4374-10UMAX | 1 | 6 |  | 6 | ok
37 | MF52A1224J4150 | 2 |  | 20 | 20 | ok
38 | MIC79110-4.2YMLTR | 2 | 1 | 12 | 13 | ok
39 | NCS2200SN1T1G | 2 | 5 | 5 | 10 | ok
40 | P0115-RA100 | 12 | 60 |  | 60 | ok
41 | PMEG3050EP,115 | 4 | 29 |  | 29 | ok
42 | RL2007-1723-103-SA | 8 | 20 |  | 20 | Need More!
43 | RMCF1206FT3M40 | 2 |  | 20 | 20 | ok
44 | SI7448DP-T1-E3 | 4 | 10 | 15 | 25 | ok
45 | SI7485DP-T1-GE3 | 3 | 24 |  | 24 | ok
46 | T530X157M016ATE015 | 4 |  | 20 | 20 | ok
47 | TLV70228DBV | 1 |  | 10 | 10 | ok
48 | TLV70233DBVR | 1 | 4 | 4 | 8 | ok
49 | WSL1206R0300FEA | 1 |  | 10 | 10 | ok
50
