spaceconcordia/Consat1Electrical/Wiring Harness/List of Connectors for CSDC-1 wiring harness.ods

w | Connection type | Number of pins | Wire gauge | Dimensional constraints | Additional constraints | Comments | Link to connector spec sheet | Price for one connector ($) | List of connectors (ivan) | Part Number | price (ivan) | Approved (ivan) | Newark Link | Approved (Greg) | Approved (Ty) | Approved (Shawn)
Payload | Wire to wire | 2 |  |  | RBFP & Dswitches | The male crimp outgasses at 1.01%. Not sure if approved. | http://www.harwin.com/M80-808/M80-8080205-product.html#M80-8080205, http://ca.mouser.com/ProductDetail/Harwin/M80-8980205/ |  |  | M80-8080205 |  | PARTIALLY APPROVED seems to meet all material specs, but missing male part |  |  |  | notes-http://portal.fciconnect.com/portal/page/portal/fciconnect/homepage
 | PCB to wire, vertical | 2 |  |  | goes on upper payload board, power for payload | Mouser lets us buy by the unit, Male PCB: http://ca.mouser.com/ProductDetail/Harwin/M80-8770222/ Female Crimp: http://ca.mouser.com/ProductDetail/Harwin/M80-8980205/ | http://www.harwin.com/M80-877-datamate-2mm-pitch-high-reliability-l-tek-sil-male-vertical-pc-tail-connector-family.html | Male: $3.12 Female: $2.05 | female: http://www.digikey.ca/product-detail/en/M80-8980205/952-1182-ND/2264171 male: http://www.digikey.ca/product-detail/en/M80-8820242/952-1069-5-ND/2264058 | Fmale - M80-8980205 Male - M80-8760222 |  | PARTIALLY APPROVED need to check if the glass filled polyamide they use outgasses or if it can be baked? if it cannot happen, the male part found by Eric on mouser uses a different platic |  | Rejected the connector's wire gauge is too small I recommend these connectors instead MO-889 series instead Fmale - M80-8980205
 | PCB to wire, vertical | 6 |  |  | goes on lower payload board, adc signals, shielded wires |  |  |  | female: http://www.digikey.ca/product-detail/en/M80-8880605/952-1197-ND/2264186 male: http://www.digikey.ca/product-detail/en/M80-8530642/952-1095-5-ND/2264084 male: http://www.digikey.ca/product-detail/en/M80-8280642/952-1161-5-ND/2264150 | Female - M80-8880605 Male Surfacemount - M80-8280642 Male ThroughHole - M80-8530642 |  | PARTIALLY APPROVED need to check if glass filled polyamide outgasses and if it does, look for alternative male connectors |  | Rejected the connector's wire gauge is too small I recommend these connectors instead MO-889 series instead http://www.digikey.ca/product-detail/en/M80-8890605/952-1208-ND/2264197 http://www.digikey.ca/product-detail/en/M80-8540645/952-1882-ND/3727849
 | PCB to wire, 90deg | 4 |  |  | connects between upper and lower payload board | Mouser lets us buy by the unit. Male PCB: http://ca.mouser.com/ProductDetail/Harwin/M80-8760422/ Female Crimp: http://ca.mouser.com/ProductDetail/Harwin/M80-8980405/?qs=sGAEpiMZZMtfXl%252bsADUrUPVIDPSx5SFt | http://www.digikey.ca/product-detail/en/M80-8760422/M80-8760422-ND/2272018 | male: $4.02 Female: $3.35 | female: http://www.digikey.ca/product-detail/en/M80-8890405/952-1207-ND/2264196 male: http://www.digikey.ca/product-detail/en/M80-6672042/952-2102-ND/3728066 male: http://www.digikey.ca/product-detail/en/M80-6660442/952-2095-ND/3728059 male: http://www.digikey.ca/product-detail/en/M80-8510442/952-1127-5-ND/2264116 alternative one row: female: http://www.digikey.ca/product-detail/en/M80-8990405/952-1191-ND/2264180 male: http://www.digikey.ca/product-detail/en/M80-8420442/952-1078-5-ND/2264067 | Female - M80-8890405 Male Surface Mount - M80-6672042 Male Surface Mount - M80-6660442 Male Through Hole - M80-8510442 Female Crimp - M80-8990405 Male - M80-8420442 |  | PARTIALLY APPROVED check of glass filled polyamide outgasses, use alternative connectors on mouser
Unbilical Cord | Wire to wire | 6 | 22–24 for rj45 |  |  |  | http://www.samtec.com/documents/webfiles/pdf/ipl1.pdf |  |  |  |  | PARTIALLY APPROVED couldn't find anything wrong with them, but it doesn't hurt to call Samtec
 | DB15 |  |  |  | Does not have to be DB15, it may have as little as 6 pins, but it must fit the dimensions of a DB15 connector |  |  |  | male: http://www.digikey.ca/product-detail/en/M24308%2F4-11/A34440-ND/1145377 female: http://www.digikey.ca/product-detail/en/M24308%2F2-11/A34439-ND/1145376 |  |  | PARTIALLY APPROVED connectors seem to have some zinc and chromate, ubt I don't know how much of a contamination risk they pose and if we can't just bake the connector. unfortunately, the connector doesn't meet outgassing test in the mil standard for space applications but it meets all other ones - that's not such a good sign
 | DB25 |  |  |  |  |  | http://www.digikey.ca/scripts/dksearch/dksus.dll?vendor=0&keywords=206801-2 |  | male: http://www.digikey.ca/product-detail/en/M24308%2F4-3/A34459-ND/1145391 female: http://www.digikey.ca/product-detail/en/M24308%2F2-283/A34121-ND/1123897 |  |  | PARTIALLY APPROVED connectors seem to have some zinc and chromate, ubt I don't know how much of a contamination risk they pose and if we can't just bake the connector. unfortunately, the connector doesn't meet outgassing test in the mil standard for space applications but it meets all other ones - that's not such a good sign
Elec bay | PCB to wire, vertical or 90deg | 8 | 16 - 20( Ty) |  | CD&H to Battery heaters | Mouser lets us buy by the unit. Male PCB: http://ca.mouser.com/ProductDetail/Harwin/M80-8670822/ Female Crimp 22G: http://www.digikey.ca/scripts/dksearch/dksus.dll?vendor=0&keywords=M80-8890805 | http://www.digikey.ca/scripts/dksearch/dksus.dll?vendor=0&keywords=M80-8670822-ND | Male: $4.43 Female: $6.30 | female: http://www.digikey.ca/product-detail/en/M80-8890805/952-1209-ND/2264198 male: http://www.digikey.ca/product-detail/en/M80-8670805/952-2116-ND/3728080 |  |  | APPROVED
 | PCB to ribbon cable | 50 | 30 |  | CD&H to Q6 | http://www.samtec.com/documents/webfiles/pdf/fftp.pdf |  |  | two row: female: http://www.digikey.ca/product-detail/en/M80-4615005/952-1039-ND/2264028 male: http://www.digikey.ca/product-detail/en/M80-5105042/952-1015-5-ND/2264004 three row: female: http://www.digikey.ca/product-detail/en/M83-LFC1F1N60-0000-000/952-1050-ND/2264039 male: http://www.digikey.ca/product-detail/en/M83-LML3M1N60-0000-000/952-1051-ND/2264040 |  |  | APPROVED
 | PCB to wire, vertical or 90deg | 12 | 20-24 |  | DB 25 to CD&H | Mouser lets us buy by the unit. Male PCB: http://ca.mouser.com/ProductDetail/Harwin/M80-8671222/ Female Crimp: http://www.digikey.ca/scripts/dksearch/dksus.dll?vendor=0&keywords=M80-8891205 | http://www.digikey.ca/scripts/dksearch/dksus.dll?vendor=0&keywords=M80-8671222-ND , http://www.digikey.ca/scripts/dksearch/dksus.dll?vendor=0&keywords=M80-8891205 | Male: $5.30 Female: $8.14 | female: http://www.digikey.ca/product-detail/en/M80-8881205/952-1200-ND/2264189 male: http://www.digikey.ca/product-detail/en/M80-8281242/952-1164-5-ND/2264153 male: http://www.digikey.ca/product-detail/en/M80-8531242/952-1098-5-ND/2264087 right angle: male: http://www.digikey.ca/product-detail/en/M80-8511242/952-1131-5-ND/2264120 |  |  | PARTIALlY APPROVED polyamide!
 | PCB to wire, vertical or 90deg | 2 | 16 - 20 (Ty) |  | batteries to CD&H |  |  |  | female: http://www.digikey.ca/product-detail/en/M80-8980205/952-1182-ND/2264171 male: http://www.digikey.ca/product-detail/en/M80-8820242/952-1069-5-ND/2264058 |  |  | PARTIALLY APPROVED need to check if the glass filled polyamide they use outgasses or if it can be baked? if it cannot happen, the male part found by Eric on mouser uses a different platic
 | PCB to wire, 90deg | 30 | 16 - 20 for cells ( Ty - best guest ), 20-24 for others |  | DB44 to payload board | FInd current and voltage |  |  | two row, 34pin: female: http://www.digikey.ca/product-detail/en/M80-4613405/952-1037-ND/2264026 male: http://www.digikey.ca/product-detail/en/M80-5403442/952-1029-5-ND/2264018 two row, 50pin female: http://www.digikey.ca/product-detail/en/M80-4605005/952-1047-ND/2264036 male: http://www.digikey.ca/product-detail/en/M80-5405042/952-1031-5-ND/2264020 |  |  | APPROVED
 | DB44 | 44 |  |  | Needs to match the dimensions of a DB25, so it will have three rows of pins | http://www.digikey.ca/product-search/en?FV=fff40016,fff8051c,ffec87ba |  |  | male: http://www.digikey.ca/product-detail/en/M24308%2F4-13/A34444-ND/1122047 female: http://www.digikey.ca/product-detail/en/M24308%2F2-13/A34443-ND/1145379 male: http://www.alliedelec.com/search/productdetail.aspx?SKU=70070153 female: http://www.alliedelec.com/images/products/datasheets/bm/HARTING_ELECTRONIK_INC/70070158.pdf crimps (24-26 AWG): http://www.alliedelec.com/search/productdetail.aspx?SKU=70070162 |  |  | PARTIALLY APPROVED connectors seem to have some zinc and chromate, ubt I don't know how much of a contamination risk they pose and if we can't just bake the connector. unfortunately, the connector doesn't meet outgassing test in the mil standard for space applications but it meets all other ones - that's not such a good sign
Below Elec Bay | 4 X PCB to wire, 90deg | 6 | 16 - 20 ( Ty ) |  | Solar Panels to DB44 | Mouser lets us buy by the unit. Male PCB http://ca.mouser.com/ProductDetail/Harwin/M80-8760622/ Female Crimp 22G : http://ca.mouser.com/ProductDetail/Harwin/M80-8990605/?qs=sGAEpiMZZMtsLRyDR9nM10M7wAK5dulT5n53sbpKDF8%3d | http://www.digikey.ca/scripts/dksearch/dksus.dll?vendor=0&keywords=M80-8770622 | Male: $4.25 Female: $4.87 | female: http://www.digikey.ca/product-detail/en/M80-8990605/952-1193-ND/2264182 male: http://www.digikey.ca/product-detail/en/M80-8420642/952-1080-5-ND/2264069 |  |  | PARTIALLY APPROVED connectors on mouser: everything is fine, but the connector needs to be at 90deg with the PCB - edited to accomodate 90deg connector. connectors on digikey: polyamide!
 | PCB to wire, vertical | 3 |  |  | goes to DB44, need to be shielded | Mouser lets us buy by the unit. Male PCB http://ca.mouser.com/ProductDetail/Harwin/M80-8770322/?qs=sGAEpiMZZMtsLRyDR9nM12b9fuej8UjTmexQPLryR4o%3d Female Crimp: http://ca.mouser.com/ProductDetail/Harwin/M80-8980305/?qs=sGAEpiMZZMveaWjGIsDKYtiKQzzClW6L | http://www.digikey.com/product-detail/en/M80-8770322/M80-8770322-ND/2272010 | Male: $3.25 Female: $3.07 | female: http://www.digikey.ca/product-detail/en/M80-8990305/952-1190-ND/2264179 male: http://www.digikey.ca/product-detail/en/M80-8040322/952-1950-ND/3727917 male: http://www.digikey.ca/product-detail/en/M80-8460342/952-1949-ND/3727916 note the male ones are 90deg but it may be fine |  |  | APPROVED
 | 3 X PCB to wire, vertical | 4 |  |  | two of the connections are to interconnect the ACS boards (short wires) | if we buy it from here, Male PCB http://ca.mouser.com/ProductDetail/Harwin/M80-8770422/ they have 4 left, and we can buy by the unit. Female Crimp: http://ca.mouser.com/ProductDetail/Harwin/M80-8980405/?qs=sGAEpiMZZMtfXl%252bsADUrUPVIDPSx5SFt | http://www.digikey.ca/scripts/dksearch/dksus.dll?vendor=0&keywords=M80-8770422-ND | Male: $3.37 Female: $3.35 | female: http://www.digikey.ca/product-detail/en/M80-8990405/952-1191-ND/2264180 male: http://www.digikey.ca/product-detail/en/M80-8820442/952-1071-5-ND/2264060 |  |  | PARTIALLY APPROVED mouser - fine digikey - polyamide!
 | PCB to wire, vertical | 2 |  |  |  | Male PCB: http://ca.mouser.com/ProductDetail/Harwin/M80-8770222/ Female Crimp: http://ca.mouser.com/ProductDetail/Harwin/M80-8980205/ |  | Male: $3.12 Female: $2.05 | female: http://www.digikey.ca/product-detail/en/M80-8980205/952-1182-ND/2264171 male: http://www.digikey.ca/product-detail/en/M80-8820242/952-1069-5-ND/2264058 |  |  | PARTIALLY APPROVED mouser - fine digikey: need to check if the glass filled polyamide they use outgasses or if it can be baked? if it cannot happen, the male part found by Eric on mouser uses a different platic
 |  |  |  |  |  | Additional information:
 |  |  |  |  |  | HARWIN OUTGASSING DATA SHEET: http://www.harwin.com/include/downloads/pdfs/OUTGASSING_DATA_FOR_HARWIN_PRODUCTS_2013-01-22.PDF , mainly looking for connectors made of PBT Valox 420SEO Black, with .33% TML. All the Harwin connectors included in this list fall under this material, except for 2 pin wire-to-wire M80-8080205, which has a 1.01% TML. We might need a tool to remove the latches, and the harwin branded one is ridiculously expensive. http://www.digikey.com.au/scripts/DkSearch/dksus.dll?WT.z_header=search_go&lang=en&x=0&y=0 Perhaps you guys have one, or we could fabricate a similar tool.
 |  |  |  |  |  | Harwin crimp pins: http://www.digikey.ca/product-search/en/connectors-interconnects/rectangular-connectors-contacts/1442670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
 |  |  |  |  |  | polyamide doesn't meet the outgassing requirements, infact it's a common contaminant: http://books.google.ca/books?id=FDr3iFDh7M8C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 but we may be able to bake the connectors to get rid of the contaminants: http://esmat.esa.int/Services/outgassing_data/outgassing_data.html
 |  |  |  |  |  | some of these may be space qualified: http://www.digikey.ca/product-search/en/connectors-interconnects/rectangular-connectors-headers-male-pins/1442547
 |  |  |  | Final list of connectors
 |  |  |  | Module | Connector description | male | female | Required number for one sat | Required number for purchasing
 |  |  |  |  | DB15 (umb. cord) | http://www.digikey.ca/product-detail/en/5-747908-2/A32503-ND/993060 | http://www.digikey.ca/product-detail/en/5-747909-2/A32504-ND/993061 | 1 | 2
 |  |  |  |  | DB25s | http://www.digikey.ca/scripts/dksearch/dksus.dll?vendor=0&keywords=5-747912-2 | http://www.digikey.ca/product-detail/en/5-747913-2/A32508-ND/1014900 | 3 | 6
 |  |  |  | Elec Bay | CDH - 4 pin power | http://www.digikey.ca/product-detail/en/M80-5000000M1-04-331-00-000/952-1255-ND/2264242 | http://www.digikey.ca/product-detail/en/M80-5000000M2-04-331-00-000/952-1652-ND/2616371 | 1 | 2
 |  |  |  |  | CDH - 10 pin power | http://www.digikey.ca/scripts/dksearch/dksus.dll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 | http://www.digikey.ca/product-detail/en/M80-4000000F1-10-325-00-000/952-1651-ND/2616370 | 1 | 2
 |  |  |  |  | CDH - Q6 50 pin |  |  | 1 | 2
 |  |  |  |  | CDH - 8 pin signal | http://www.digikey.ca/product-detail/en/M80-8670805/952-2116-ND/3728080 | http://www.digikey.ca/product-detail/en/M80-8890805/952-1209-ND/2264198 | 1 | 2
 |  |  |  |  | Bottom of Elec Bay to DB25s | http://www.digikey.ca/product-detail/en/M80-8661622/952-2390-5-ND/2272073 | http://www.digikey.ca/product-detail/en/M80-8891605/952-1213-ND/2264202 | 2 | 4
 |  |  |  | Payload boards | Power for Payload | http://www.digikey.ca/product-detail/en/M80-5000000M1-02-331-00-000/952-1243-ND/2264230 | http://www.digikey.ca/product-detail/en/M80-4000000F1-02-325-00-000/952-1242-ND/2264229 | 1 | 2
 |  |  |  |  | Payload signal | http://www.digikey.ca/product-detail/en/M80-8670622/952-2410-5-ND/2272035 | http://www.digikey.ca/scripts/DkSearch/dksus.dll?FullDetail&name=952-1208-ND#matingproducts | 1 | 2
 |  |  |  |  |  |  |  |  | 0
 |  |  |  | Under Elec Bay | Solar Cell connectors | http://www.digikey.ca/product-detail/en/M80-8660622/952-2416-5-ND/2272068 | http://www.digikey.ca/scripts/DkSearch/dksus.dll?FullDetail&name=952-1208-ND#matingproducts | 4 | 8
 |  |  |  |  | Deployment mechanism | http://www.digikey.ca/product-detail/en/M80-5000000M1-02-331-00-000/952-1243-ND/2264230 | http://www.digikey.ca/product-detail/en/M80-4000000F1-02-325-00-000/952-1242-ND/2264229 | 1 | 2
 |  |  |  |  | ACS boards | http://www.digikey.ca/product-detail/en/M80-8790422/952-1956-ND/3727923 | http://www.digikey.ca/product-detail/en/M80-8990405/952-1191-ND/2264180 | 3 | 6
