spaceconcordia/Consat1Electrical/Wiring Harness/Wire Data.ods

 |  |  | Connection details |  |  |  |  |  |  |  | Wiring details
Color Legend |  | Connection ID | Connection name | Location | LRU ID | Connector ID | Pin# | Wire_net | Role (consumer/provider) | Signal type | Gauge | segregation code (opt) | Harness group | Etc. etc. if applicable | Details | Comments
CDH |  | 0001 | DIPLEX_TO_ANT_SIG | TOP 1U | Ant | X17 |  |  |  | Signal
POW |  | 0002 | DIPLEX_TO_ANT_GND | TOP 1U | Ant | X17 |  |  |  | Signal
PAYLOAD |  | 0003 | DIPLEX_TO_ANT_SIG | TOP 1U | DISC | X9 |  |  |  | Signal
COMMS |  | 0004 | DIPLEX_TO_ANT_GND | TOP 1U | DISC | X9 |  |  |  | Signal
 |  | 0005 | Mech_Deploy_Switch_0 | ELEC BAY | DISC | X1 | 1 |  |  | Discrete
 |  | 0006 | Mech_Deploy_Switch_1 | ELEC BAY | DISC | X1 | 2 |  |  | Discrete
 |  | 0007 | FREE | ELEC BAY | DISC | X1 | 3
 |  | 0008 | External_Power_0 | ELEC BAY | DISC | X1 | 4 |  |  | POW
 |  | 0009 | External_Power_1 | ELEC BAY | DISC | X1 | 5 |  |  | POW
 |  | 0010 | FREE | ELEC BAY | DISC | X1 | 6
 |  | 0011 | FREE | ELEC BAY | DISC | X1 | 7
 |  | 0012 | Q6_PC_RS232 | ELEC BAY | DISC | X1 | 8 |  |  | Signal
 |  | 0013 | PC_Q6_RS232 | ELEC BAY | DISC | X1 | 9 |  |  | Signal
 |  | 0014 | FREE | ELEC BAY | DISC | X1 | 10
 |  | 0015 | FREE | ELEC BAY | DISC | X1 | 11
 |  | 0016 | FREE | ELEC BAY | DISC | X1 | 12
 |  | 0017 | FREE | ELEC BAY | DISC | X1 | 13
 |  | 0018 | PA3_JTAG_TDI | ELEC BAY | DISC | X1 | 14 |  |  | Signal
 |  | 0019 | PA3_JTAG_TMS | ELEC BAY | DISC | X1 | 15 |  |  | Signal
 |  | 0020 | PA3_JTAG_TCK | ELEC BAY | DISC | X1 | 16 |  |  | Signal
 |  | 0021 | PA3_JTAG_TDO | ELEC BAY | DISC | X1 | 17 |  |  | Signal
 |  | 0022 | PA3_JTAG_TRST_N | ELEC BAY | DISC | X1 | 18 |  |  | Signal
 |  | 0023 | FREE | ELEC BAY | DISC | X1 | 19
 |  | 0024 | S6_JTAG_TDI | ELEC BAY | DISC | X1 | 20 |  |  | Signal
 |  | 0025 | S6_JTAG_TMS | ELEC BAY | DISC | X1 | 21 |  |  | Signal
 |  | 0026 | S6_JTAG_TCK | ELEC BAY | DISC | X1 | 22 |  |  | Signal
 |  | 0027 | S6_JTAG_TDO | ELEC BAY | DISC | X1 | 23 |  |  | Signal
 |  | 0028 | JTAG_3V3 | ELEC BAY | DISC | X1 | 24 |  |  | POW
 |  | 0029 | JTAG_GND | ELEC BAY | DISC | X1 | 25 |  |  | POW
 |  | 0030 | DIPLEX_TO_ANT_SIG | ELEC BAY | DISC | X8 |  |  |  | Signal
 |  | 0031 | DIPLEX_TO_ANT_GND | ELEC BAY | DISC | X8 |  |  |  | Signal
 |  | 0032 | Mech_Deploy_Switch_0 | TOP 1U | DISC | X4 | 1 |  |  | Discrete
 |  | 0033 | Mech_Deploy_Switch_1 | TOP 1U | DISC | X4 | 2 |  |  | Discrete
 |  | 0034 | FREE | TOP 1U | DISC | X4 | 3
 |  | 0035 | External_Power_0 | TOP 1U | DISC | X4 | 4 |  |  | POW
 |  | 0036 | External_Power_1 | TOP 1U | DISC | X4 | 5 |  |  | POW
 |  | 0037 | FREE | TOP 1U | DISC | X4 | 6
 |  | 0038 | FREE | TOP 1U | DISC | X4 | 7
 |  | 0039 | Q6_PC_RS232 | TOP 1U | DISC | X4 | 8 |  |  | Signal
 |  | 0040 | PC_Q6_RS232 | TOP 1U | DISC | X4 | 9 |  |  | Signal
 |  | 0041 | FREE | TOP 1U | DISC | X4 | 10
 |  | 0042 | FREE | TOP 1U | DISC | X4 | 11
 |  | 0043 | FREE | TOP 1U | DISC | X4 | 12
 |  | 0044 | FREE | TOP 1U | DISC | X4 | 13
 |  | 0045 | PA3_JTAG_TDI | TOP 1U | DISC | X4 | 14 |  |  | Signal
 |  | 0046 | PA3_JTAG_TMS | TOP 1U | DISC | X4 | 15 |  |  | Signal
 |  | 0047 | PA3_JTAG_TCK | TOP 1U | DISC | X4 | 16 |  |  | Signal
 |  | 0048 | PA3_JTAG_TDO | TOP 1U | DISC | X4 | 17 |  |  | Signal
 |  | 0049 | PA3_JTAG_TRST_N | TOP 1U | DISC | X4 | 18 |  |  | Signal
 |  | 0050 | FREE | TOP 1U | DISC | X4 | 19
 |  | 0051 | S6_JTAG_TDI | TOP 1U | DISC | X4 | 20 |  |  | Signal
 |  | 0052 | S6_JTAG_TMS | TOP 1U | DISC | X4 | 21 |  |  | Signal
 |  | 0053 | S6_JTAG_TCK | TOP 1U | DISC | X4 | 22 |  |  | Signal
 |  | 0054 | S6_JTAG_TDO | TOP 1U | DISC | X4 | 23 |  |  | Signal
 |  | 0055 | JTAG_3V3 | TOP 1U | DISC | X4 | 24 |  |  | POW
 |  | 0056 | JTAG_GND | TOP 1U | DISC | X4 | 25 |  |  | POW
 |  | 0057 | DIPLEX_TO_ANT_SIG | ELEC BAY | DIPLX | X11 |  |  |  | Signal
 |  | 0058 | DIPLEX_TO_ANT_GND | ELEC BAY | DIPLX | X11 |  |  |  | Signal
 |  | 0059 | HE100_TX_TO_DIPLEX_SIG | ELEC BAY | HE100 | X12 |  |  |  | Signal
 |  | 0060 | HE100_TX_TO_DIPLEX_GND | ELEC BAY | HE100 | X12 |  |  |  | Signal
 |  | 0061 | HE100_TX_TO_DIPLEX_SIG | ELEC BAY | DIPLX | X14
 |  | 0062 | HE100_TX_TO_DIPLEX_GND | ELEC BAY | DIPLX | X14
 |  | 0063 | HE100_RX_TO_DIPLEX_SIG | ELEC BAY | HE100 | X13
 |  | 0064 | HE100_RX_TO_DIPLEX_GND | ELEC BAY | HE100 | X13
 |  | 0065 | HE100_RX_TO_DIPLEX_SIG | ELEC BAY | DIPLX | X15
 |  | 0066 | HE100_RX_TO_DIPLEX_GND | ELEC BAY | DIPLX | X15
 |  | 0067 | ANTENNA_DEPLOYMENT_+V | ELEC BAY | EPS | H1 | 1 |  |  | POW |  |  |  |  | ANTTENA DEPLOYMENT +V
 |  | 0068 | ANTENNA_DEPLOYMENT_GND | ELEC BAY | EPS | H1 | 3 |  |  | POW |  |  |  |  | ANTTENA DEPLOYMENT -V
 |  | 0069 | THERMALGND1 | ELEC BAY | EPS | H1 | 5 |  |  | Signal GND (Check for floating) |  |  |  |  | CDH PCB THERMISTORS GND
 |  | 0070 | Q6_GPIO_6 | ELEC BAY | EPS | H1 | 7 |  |  | Signal/Discrete? (check if free/unused) |  |  |  |  | Q6_GPIO_6 (unused?)
 |  | 0071 | Q6_GPIO_7 | ELEC BAY | EPS | H1 | 9 |  |  | Signal/Discrete? (check if free/unused) |  |  |  |  | Q6_GPIO_7
 |  | 0072 | Q6_GPIO_8 | ELEC BAY | EPS | H1 | 11 |  |  | Signal/Discrete? (check if free/unused) |  |  |  |  | Q6_GPIO_8
 |  | 0073 | Q6_GPIO_0 | ELEC BAY | EPS | H1 | 13 |  |  | Signal/Discrete? (check if free/unused) |  |  |  |  | Watch Dog Input
 |  | 0074 | GND | ELEC BAY | EPS | H1 | 15 |  |  | POW GND (Check for floating) |  |  |  |  | COMMON GND
 |  | 0075 | RADIO_UART_TX | ELEC BAY | EPS | H1 | 17 |  |  | Signal |  |  |  |  | TRANSCEIVER UART TRANSMIT
 |  | 0076 | GND | ELEC BAY | EPS | H1 | 19 |  |  | POW GND (Check for floating) |  |  |  |  | COMMON GND
 |  | 0077 | PC_Q6_RX_RS232 | ELEC BAY | EPS | H1 | 21 |  |  | Signal
 |  | 0078 | GND | ELEC BAY | EPS | H1 | 23 |  |  | POW GND (Check for floating) |  |  |  |  | COMMON GND
 |  | 0079 | Q6_PC_TX_RS232 | ELEC BAY | EPS | H1 | 25 |  |  | Signal
 |  | 0080 | GND | ELEC BAY | EPS | H1 | 27 |  |  | POW GND (Check for floating) |  |  |  |  | COMMON GND
 |  | 0081 | SOLAR_PANEL_1_3 | ELEC BAY | EPS | H1 | 29 |  |  | POW |  |  |  |  | SOLAR PANEL 1 AND 3
 |  | 0082 | SOLAR_PANEL_GND | ELEC BAY | EPS | H1 | 31 |  |  | POW |  |  |  |  | SOLAR PANEL GROUND
 |  | 0083 | POW_BATT_GND | ELEC BAY | EPS | H1 | 33 |  |  | POW |  |  |  |  | BATTERY -V
 |  | 0084 | POW_BATT_V_TO_LOAD | ELEC BAY | EPS | H1 | 35 |  |  | POW |  |  |  |  | BATTERY +V
 |  | 0085 | GND | ELEC BAY | EPS | H1 | 37 |  |  | POW GND (Check for floating) |  |  |  |  | COMMON GROUND
 |  | 0086 | Q6_AIN_0 | ELEC BAY | EPS | H1 | 39 |  |  | Signal |  |  |  |  | Q6 ADC 0
 |  | 0087 | GND | ELEC BAY | EPS | H1 | 41 |  |  | POW GND (Check for floating) |  |  |  |  | COMMON GND
 |  | 0088 | Q6_AIN_1 | ELEC BAY | EPS | H1 | 43 |  |  | Signal |  |  |  |  | Q6 ADC 1
 |  | 0089 | GND | ELEC BAY | EPS | H1 | 45 |  |  | POW GND (Check for floating) |  |  |  |  | COMMON GND
 |  | 0090 | Q6_AOUT_0 | ELEC BAY | EPS | H1 | 47 |  |  | Signal/Discrete? (check if free/unused) |  |  |  |  | Q6 DAC 0
 |  | 0091 | GND | ELEC BAY | EPS | H1 | 49 |  |  | POW GND (Check for floating) |  |  |  |  | COMMON GND
 |  | 0092 | Q6_AOUT_1 | ELEC BAY | EPS | H1 | 51 |  |  | Signal/Discrete? (check if free/unused) |  |  |  |  | Q6 DAC 1
 |  | 0093 | SOLAR_PANEL_2_4 | ELEC BAY | EPS | H1 | 2 |  |  | POW |  |  |  |  | SOLAR PANEL 2 AND 4
 |  | 0094 | BATTERY_HEATER_+V | ELEC BAY | EPS | H1 | 4 |  |  | POW |  |  |  |  | Battery Heater Power
 |  | 0095 | BATTERY_HEATER_-V | ELEC BAY | EPS | H1 | 6 |  |  | POW |  |  |  |  | Battery Heater Power
 |  | 0096 | BATTERY_THRMSTOR1_+V | ELEC BAY | EPS | H1 | 8 |  |  | Sensor |  |  |  |  | Battery Temp Sense 1
 |  | 0097 | BATTERY_THRMSTOR_-V | ELEC BAY | EPS | H1 | 10 |  |  | Sensor |  |  |  |  | Battery Temp Sense Ground
 |  | 0098 | BATTERY_THRMSTOR2_+V | ELEC BAY | EPS | H1 | 12 |  |  | Sensor |  |  |  |  | Battery Temp Sense 2
 |  | 0099 | GND | ELEC BAY | EPS | H1 | 14 |  |  | POW GND (Check for floating) |  |  |  |  | COMMON GND
 |  | 0100 | POW-3V3 | ELEC BAY | EPS | H1 | 16 |  |  | POW |  |  |  |  | POWER 3V3 - POW_RADIO _3V3 - through payload board
 |  | 0101 | RADIO_UART_RX | ELEC BAY | EPS | H1 | 18 |  |  | Signal |  |  |  |  | TRANSCEIVER UART RECEIVE | Made mistake on sheet
 |  | 0102 | POW-3V3 | ELEC BAY | EPS | H1 | 20 |  |  | POW |  |  |  |  | POWER 3V3
 |  | 0103 | POW-9V | ELEC BAY | EPS | H1 | 22 |  |  | POW |  |  |  |  | POWER 9V
 |  | 0104 | POW-9V | ELEC BAY | EPS | H1 | 24 |  |  | POW |  |  |  |  | POWER 9V
 |  | 0105 | POW-5V | ELEC BAY | EPS | H1 | 26 |  |  | POW |  |  |  |  | POWER 5V
 |  | 0106 | POW-5V | ELEC BAY | EPS | H1 | 28 |  |  | POW |  |  |  |  | POWER 5V
 |  | 0107 | SOLAR_PANEL_GND | ELEC BAY | EPS | H1 | 30 |  |  | POW |  |  |  |  | SOLAR PANEL GROUND
 |  | 0108 | Q6_GPIO_10 | ELEC BAY | EPS | H1 | 32 |  |  | Signal/Discrete? (FIX FIX FIX (GPIO10 used on CDH)) |  |  |  |  | Q6_GPIO_10 ( Use for EPS Board )
 |  | 0109 | GND | ELEC BAY | EPS | H1 | 34 |  |  | POW GND (Check for floating) |  |  |  |  | COMMON GND
 |  | 0110 | Q6_GPIO_13 | ELEC BAY | EPS | H1 | 36 |  |  | Signal |  |  |  |  | PAYLOAD VOLTAGE CONTROL
 |  | 0111 | Q6_GPIO_14 | ELEC BAY | EPS | H1 | 38 |  |  | Signal |  |  |  |  | ANTENNA CONTROL
 |  | 0112 | Q6_GPIO_15 | ELEC BAY | EPS | H1 | 40 |  |  | Signal |  |  |  |  | 3V3 CONTROL
 |  | 0113 | FREE | ELEC BAY | EPS | H1 | 42
 |  | 0114 | GND | ELEC BAY | EPS | H1 | 44 |  |  | POW GND (Check for floating) |  |  |  |  | COMMON GND
 |  | 0115 | FREE | ELEC BAY | EPS | H1 | 46
 |  | 0116 | GND | ELEC BAY | EPS | H1 | 48 |  |  | POW GND (Check for floating) |  |  |  |  | COMMON GND
 |  | 0117 | Q6_GPIO_10 | ELEC BAY | EPS | H1 | 50 |  |  | Signal/Discrete? (FIX FIX FIX (GPIO10 used on EPS)) |  |  |  |  | Q6_GPIO_10 ( Use for EPS Board, not connected on CDH yet )
 |  | 0118 | GND | ELEC BAY | EPS | H1 | 52 |  |  | POW GND (Check for floating) |  |  |  |  | COMMON GND
 |  | 0119 | TOP_TEMP_SOLAR_PANEL-1 | ELEC BAY | EPS | H2 | 1 |  |  | SIGNAL |  |  |  |  | TEMP SENSOR FOR TOP HALF OF SOLAR PANEL
 |  | 0120 | TOP_TEMP_SOLAR_PANEL-2 | ELEC BAY | EPS | H2 | 3 |  |  | SIGNAL |  |  |  |  | TEMP SENSOR FOR TOP HALF OF SOLAR PANEL
 |  | 0121 | TOP_TEMP_SOLAR_PANEL-3 | ELEC BAY | EPS | H2 | 5 |  |  | SIGNAL |  |  |  |  | TEMP SENSOR FOR TOP HALF OF SOLAR PANEL
 |  | 0122 | TOP_TEMP_SOLAR_PANEL-4 | ELEC BAY | EPS | H2 | 7 |  |  | SIGNAL |  |  |  |  | TEMP SENSOR FOR TOP HALF OF SOLAR PANEL
 |  | 0123 | BOTTOM_TEMP_SOLAR_PANEL-1 | ELEC BAY | EPS | H2 | 9 |  |  | SIGNAL |  |  |  |  | TEMP SENSOR FOR BOTTOM HALF OF SOLAR PANEL
 |  | 0124 | BOTTOM_TEMP_SOLAR_PANEL-2 | ELEC BAY | EPS | H2 | 11 |  |  | SIGNAL |  |  |  |  | TEMP SENSOR FOR BOTTOM HALF OF SOLAR PANEL
 |  | 0125 | BOTTOM_TEMP_SOLAR_PANEL-3 | ELEC BAY | EPS | H2 | 13 |  |  | SIGNAL |  |  |  |  | TEMP SENSOR FOR BOTTOM HALF OF SOLAR PANEL
 |  | 0126 | BOTTOM_TEMP_SOLAR_PANEL-4 | ELEC BAY | EPS | H2 | 15 |  |  | SIGNAL |  |  |  |  | TEMP SENSOR FOR BOTTOM HALF OF SOLAR PANEL
 |  | 0127 | GND | ELEC BAY | EPS | H2 | 17 |  |  | POW GND (Check for floating) |  |  |  |  | COMMON GROUND
 |  | 0128 | GND | ELEC BAY | EPS | H2 | 19 |  |  | POW GND (Check for floating) |  |  |  |  | COMMON GROUND
 |  | 0129 | FREE | ELEC BAY | EPS | H2 | 21
 |  | 0130 | FREE | ELEC BAY | EPS | H2 | 23
 |  | 0131 | FREE | ELEC BAY | EPS | H2 | 25
 |  | 0132 | POW_RADIO_3.3V | ELEC BAY | EPS | H2 | 27 |  |  | POW |  |  |  |  | 3V3 LINE FROM POWER FOR TRANSCEIVER(Connecting to H1 on payload board pow_3v3 line)
 |  | 0133 | POW_RADIO_GND | ELEC BAY | EPS | H2 | 29 |  |  | POW |  |  |  |  | GND LINE FROM POWER FOR TRANSCEIVER
 |  | 0134 | MECH_DEPLOYMENT_SWITCH_+V | ELEC BAY | EPS | H2 | 31 |  |  | Discrete |  |  |  |  | MECHANICAL DEPLOYMENT SWITCH +V
 |  | 0135 | MECH_DEPLOYMENT_SWITCH_-V | ELEC BAY | EPS | H2 | 33 |  |  | Discrete |  |  |  |  | MECHANICAL DEPLOYMENT SWITCH -V
 |  | 0136 | FREE | ELEC BAY | EPS | H2 | 35
 |  | 0137 | FREE | ELEC BAY | EPS | H2 | 37
 |  | 0138 | FREE | ELEC BAY | EPS | H2 | 39
 |  | 0139 | FREE | ELEC BAY | EPS | H2 | 41
 |  | 0140 | FREE | ELEC BAY | EPS | H2 | 43
 |  | 0141 | POW_RADIO_VBATT | ELEC BAY | EPS | H2 | 45 |  |  | POW |  |  |  |  | POWER FOR TRANSCEIVER BATTERY
 |  | 0142 | FREE | ELEC BAY | EPS | H2 | 47
 |  | 0143 | FREE | ELEC BAY | EPS | H2 | 49
 |  | 0144 | EXTERNAL_POWER_GND | ELEC BAY | EPS | H2 | 51 |  |  | POW |  |  |  |  | EXTERNAL POWER WHEN POWER CONTINUITY PLUG IS IN
 |  | 0145 | POW_BATT_V_FROM_BCR | ELEC BAY | EPS | H2 | 2 |  |  | POW |  |  |  |  | BATTERY V+
 |  | 0146 | GND | ELEC BAY | EPS | H2 | 4 |  |  | POW GND (Check for floating) |  |  |  |  | COMMON GND
 |  | 0147 | Q6_SPI_SCLK | ELEC BAY | EPS | H2 | 6 |  |  | Signal |  |  |  |  | Q6 SPI CLOCK
 |  | 0148 | Q6_SPI_SDO_MOSI | ELEC BAY | EPS | H2 | 8 |  |  | Signal |  |  |  |  | Q6 SPI DATA OUT ( MASTER OUT SLAVE IN )
 |  | 0149 | Q6_SPI_SDI_MISO | ELEC BAY | EPS | H2 | 10 |  |  | Signal |  |  |  |  | Q6 SPI DATA IN ( MASTER IN SLAVE OUT )
 |  | 0150 | Q6_SPI_CS1 | ELEC BAY | EPS | H2 | 12 |  |  | Signal |  |  |  |  | Q6 SPI CHIP SELECT 1
 |  | 0151 | Q6_SPI_CS0 | ELEC BAY | EPS | H2 | 14 |  |  | Signal |  |  |  |  | Q6 SPI CHIP SELECT 0
 |  | 0152 | GND | ELEC BAY | EPS | H2 | 16 |  |  | POW GND (Check for floating) |  |  |  |  | COMMON GND
 |  | 0153 | Q6_I2C_SDA_1 | ELEC BAY | EPS | H2 | 18 |  |  | Signal |  |  |  |  | Q6 I2C BUS 1 DATA
 |  | 0154 | Q6_I2C_SCL_1 | ELEC BAY | EPS | H2 | 20 |  |  | Signal |  |  |  |  | Q6 I2C BUS 1 CLOCK
 |  | 0155 | GND | ELEC BAY | EPS | H2 | 22 |  |  | POW GND (Check for floating) |  |  |  |  | COMMON GND
 |  | 0156 | Q6_GPIO_2 | ELEC BAY | EPS | H2 | 24 |  |  | Signal/Discrete? (check if free/unused) |  |  |  |  | Q6 GPIO 2
 |  | 0157 | GND | ELEC BAY | EPS | H2 | 26 |  |  | POW GND (Check for floating) |  |  |  |  | COMMON GND
 |  | 0158 | POW_RADIO_3.3VSYS | ELEC BAY | EPS | H2 | 28 |  |  | POW |  |  |  |  | 3V3 LINE FROM POWER FOR TRANSCEIVER(Connecting to H1 on payload board pow_3v3 line)
 |  | 0159 | POW_RADIO_GND | ELEC BAY | EPS | H2 | 30 |  |  | POW
 |  | 0160 | POW_RADIO_GND | ELEC BAY | EPS | H2 | 32 |  |  | POW
 |  | 0161 | FREE | ELEC BAY | EPS | H2 | 34
 |  | 0162 | Q6_3V3 | ELEC BAY | EPS | H2 | 36 |  |  | POW |  |  |  |  | Q6 3.3V LINE
 |  | 0163 | Q6_3V3 | ELEC BAY | EPS | H2 | 38 |  |  | POW |  |  |  |  | Q6 3.3V LINE
 |  | 0164 | FREE | ELEC BAY | EPS | H2 | 40
 |  | 0165 | FREE | ELEC BAY | EPS | H2 | 42
 |  | 0166 | FREE | ELEC BAY | EPS | H2 | 44
 |  | 0167 | POW_RADIO_VBATT | ELEC BAY | EPS | H2 | 46 |  |  | POW |  |  |  |  | 5V POWER TO TRANSCEIVER
 |  | 0168 | FREE | ELEC BAY | EPS | H2 | 48
 |  | 0169 | ELEC_BAY_TEMP_1 | ELEC BAY | EPS | H2 | 50 |  |  | Sensor |  |  |  |  | ELECTRONICS BAY TEMPERATURE SENSOR 1
 |  | 0170 | EXTERNAL_POWER_+V | ELEC BAY | EPS | H2 | 52 |  |  | POW |  |  |  |  | EXTERNAL POWER WHEN POWER CONTINUITY PLUG IS IN
 |  | 0171 | GND | ELEC BAY | Q6 |  | C1
 |  | 0172 | GND | ELEC BAY | Q6 |  | C2
 |  | 0173 | Q6_AIN_0 | ELEC BAY | Q6 |  | C3
 |  | 0174 | Q6_AOUT_0 | ELEC BAY | Q6 |  | C4
 |  | 0175 | Q6_AIN_1 | ELEC BAY | Q6 |  | C5
 |  | 0176 | Q6_AOUT_1 | ELEC BAY | Q6 |  | C6
 |  | 0177 | GND | ELEC BAY | Q6 |  | C7
 |  | 0178 | GND | ELEC BAY | Q6 |  | C8
 |  | 0179 | GND | ELEC BAY | Q6 |  | C9
 |  | 0180 | GND | ELEC BAY | Q6 |  | C10
 |  | 0181 | Q6_GPIO_0 | ELEC BAY | Q6 |  | C11
 |  | 0182 | Q6_GPIO_8 | ELEC BAY | Q6 |  | C12
 |  | 0183 | Q6_I2C_SCL_1 | ELEC BAY | Q6 |  | C13
 |  | 0184 | Q6_I2C_SDA_1 | ELEC BAY | Q6 |  | C14
 |  | 0185 | Q6_GPIO_2 | ELEC BAY | Q6 |  | C15
 |  | 0186 | Q6_GPIO_10 | ELEC BAY | Q6 |  | C16
 |  | 0187 | Q6_SPI_SCLK | ELEC BAY | Q6 |  | C17
 |  | 0188 | Q6_SPI_SDO_MOSI | ELEC BAY | Q6 |  | C18
 |  | 0189 | Q6_SPI_SDI_MISO | ELEC BAY | Q6 |  | C19
 |  | 0190 | Q6_SPI_CS0 | ELEC BAY | Q6 |  | C20
 |  | 0191 | Q6_SPI_CS1 | ELEC BAY | Q6 |  | C21
 |  | 0192 | Q6_GPIO_13 | ELEC BAY | Q6 |  | C22
 |  | 0193 | Q6_GPIO_6 | ELEC BAY | Q6 |  | C23
 |  | 0194 | Q6_GPIO_14 | ELEC BAY | Q6 |  | C24
 |  | 0195 | Q6_GPIO_7 | ELEC BAY | Q6 |  | C25
 |  | 0196 | Q6_GPIO_15 | ELEC BAY | Q6 |  | C26
 |  | 0197 | GND | ELEC BAY | Q6 |  | C27
 |  | 0198 | GND | ELEC BAY | Q6 |  | C28
 |  | 0199 | PA3_JTAG_TCK | ELEC BAY | Q6 |  | C29
 |  | 0200 | PA3_JTAG_TDO | ELEC BAY | Q6 |  | C30
 |  | 0201 | PA3_JTAG_TMS | ELEC BAY | Q6 |  | C31
 |  | 0202 | +3V3 | ELEC BAY | Q6 |  | C32
 |  | 0203 | PA3_JTAG_TDI | ELEC BAY | Q6 |  | C33
 |  | 0204 | ~PA3_JTAG_TDO | ELEC BAY | Q6 |  | C34
 |  | 0205 | PA3_GPIO_6 | ELEC BAY | Q6 |  | C35
 |  | 0206 | PA3_GPIO_8 | ELEC BAY | Q6 |  | C36
 |  | 0207 | PA3_GPIO_7 | ELEC BAY | Q6 |  | C37
 |  | 0208 | PA3_GPIO_9 | ELEC BAY | Q6 |  | C38
 |  | 0209 | GND | ELEC BAY | Q6 |  | C39
 |  | 0210 | GND | ELEC BAY | Q6 |  | C40
 |  | 0211 | PA3_PC_RS232 | ELEC BAY | Q6 |  | C41
 |  | 0212 | Q6_PC_RS232 | ELEC BAY | Q6 |  | C42
 |  | 0213 | PC_PA3_RS232 | ELEC BAY | Q6 |  | C43
 |  | 0214 | PC_Q6_RS232 | ELEC BAY | Q6 |  | C44
 |  | 0215 | PWR_CTRL | ELEC BAY | Q6 |  | C45
 |  | 0216 | ~WAKE_UP | ELEC BAY | Q6 |  | C46
 |  | 0217 | GND | ELEC BAY | Q6 |  | C47
 |  | 0218 | GND | ELEC BAY | Q6 |  | C48
 |  | 0219 | POW_5V | ELEC BAY | Q6 |  | C49 |  |  | POW
 |  | 0220 | POW_5V | ELEC BAY | Q6 |  | C50 |  |  | POW
 |  | 0221 | SOLAR_PANEL_1_3 | ELEC BAY | INT_PYLD | POS X | 1
 |  | 0222 | SOLAR_PANEL_GND | ELEC BAY | INT_PYLD | POS X | 2
 |  | 0223 | SOLAR_PANEL_2_4 | ELEC BAY | INT_PYLD | POS X | 3
 |  | 0224 | SOLAR_PANEL_GND | ELEC BAY | INT_PYLD | POS X | 4
 |  | 0225 | G-M-OUTPUT-AMPLITUDE | ELEC BAY | INT_PYLD | POS X | 5 |  |  |  |  |  |  |  | PAYLOAD SIGNAL NEEDS REVIEW
 |  | 0226 | HV_OUTPUT1 | ELEC BAY | INT_PYLD | POS X | 6 |  |  |  |  |  |  |  | PAYLOAD SIGNAL NEEDS REVIEW
 |  | 0227 | HV_OUTPUT2 | ELEC BAY | INT_PYLD | POS X | 7 |  |  |  |  |  |  |  | PAYLOAD SIGNAL NEEDS REVIEW
 |  | 0228 | VOLTAGE_SWEEP1 | ELEC BAY | INT_PYLD | POS X | 8 |  |  |  |  |  |  |  | PAYLOAD SIGNAL NEEDS REVIEW
 |  | 0229 | PAYGND | ELEC BAY | INT_PYLD | POS X | 9
 |  | 0230 | Q6_AOUT_0 | ELEC BAY | INT_PYLD | POS X | 10 |  |  |  |  |  |  |  | ERROR: renamed nets between payload and CDH
 |  | 0231 | Q6_AIN_0 | ELEC BAY | INT_PYLD | POS X | 11 |  |  |  |  |  |  |  | ERROR: renamed nets between payload and CDH
 |  | 0232 | POW_9V | ELEC BAY | INT_PYLD | POS X | 12
 |  | 0233 | PULSE1 | ELEC BAY | INT_PYLD | POS X | 13 |  |  |  |  |  |  |  | PAYLOAD SIGNAL NEEDS REVIEW
 |  | 0234 | VOLTAGE_SWEEP2 | ELEC BAY | INT_PYLD | POS X | 14 |  |  |  |  |  |  |  | PAYLOAD SIGNAL NEEDS REVIEW
 |  | 0235 | ANTENNA_DEPLOYMENT_GND | ELEC BAY | INT_PYLD | POS X | 15
 |  | 0236 | ANTENNA_DEPLOYMENT_+V | ELEC BAY | INT_PYLD | POS X | 16
 |  | 0237 | TOP_TEMP_SOLAR_PANEL_1 | ELEC BAY | INT_PYLD | NEG X | 1 |  |  | Sensor
 |  | 0238 | TOP_TEMP_SOLAR_PANEL_2 | ELEC BAY | INT_PYLD | NEG X | 2 |  |  | Sensor
 |  | 0239 | TOP_TEMP_SOLAR_PANEL_3 | ELEC BAY | INT_PYLD | NEG X | 3 |  |  | Sensor
 |  | 0240 | TOP_TEMP_SOLAR_PANEL_4 | ELEC BAY | INT_PYLD | NEG X | 4 |  |  | Sensor
 |  | 0241 | BOTTOM_TEMP_SOLAR_PANEL_1 | ELEC BAY | INT_PYLD | NEG X | 5 |  |  | Sensor
 |  | 0242 | BOTTOM_TEMP_SOLAR_PANEL_2 | ELEC BAY | INT_PYLD | NEG X | 6 |  |  | Sensor
 |  | 0243 | BOTTOM_TEMP_SOLAR_PANEL_3 | ELEC BAY | INT_PYLD | NEG X | 7 |  |  | Sensor
 |  | 0244 | BOTTOM_TEMP_SOLAR_PANEL_4 | ELEC BAY | INT_PYLD | NEG X | 8 |  |  | Sensor
 |  | 0245 | THERMALGND1 | ELEC BAY | INT_PYLD | NEG X | 9 |  |  | Ground for uA thermistor sensing
 |  | 0246 |  | ELEC BAY | INT_PYLD | NEG X | 10
 |  | 0247 |  | ELEC BAY | INT_PYLD | NEG X | 11
 |  | 0248 | POW_5V | ELEC BAY | INT_PYLD | NEG X | 12 |  |  | POW |  |  |  |  | Review – what is it needed for?
 |  | 0249 | +3V3 | ELEC BAY | INT_PYLD | NEG X | 13 |  |  | POW |  |  |  |  | Q6 regulated 3V3 line
 |  | 0250 | GND | ELEC BAY | INT_PYLD | NEG X | 14 |  |  | POW GND (Check for floating)
 |  | 0251 | Q6_I2C_SDA_1 | ELEC BAY | INT_PYLD | NEG X | 15 |  |  | Signal
 |  | 0252 | Q6_I2C_SCL_1 | ELEC BAY | INT_PYLD | NEG X | 16 |  |  | Signal
 |  | 0253 | SOLAR_PANEL_2_4 | ELEC BAY | DISC | X2 (POS X) | 1 |  |  | POW |  |  |  |  | Solar panel 2 and 4 are in parallel
 |  | 0254 | SOLAR_PANEL_2_4 | ELEC BAY | DISC | X2 (POS X) | 2 |  |  | POW
 |  | 0255 | SOLAR_PANEL_1_3 | ELEC BAY | DISC | X2 (POS X) | 3 |  |  | POW |  |  |  |  | Solar panel 1 and 3 are in parallel
 |  | 0256 | SOLAR_PANEL_1_3 | ELEC BAY | DISC | X2 (POS X) | 4 |  |  | POW
 |  | 0257 | SOLAR_PANEL_GND | ELEC BAY | DISC | X2 (POS X) | 5 |  |  | POW |  |  |  |  | Solar panel grounds split in the bottom 1u, but are connected at the connector inside the Elec bay
 |  | 0258 | SOLAR_PANEL_GND | ELEC BAY | DISC | X2 (POS X) | 6 |  |  | POW
 |  | 0259 | SOLAR_PANEL_GND | ELEC BAY | DISC | X2 (POS X) | 7 |  |  | POW
 |  | 0260 | SOLAR_PANEL_GND | ELEC BAY | DISC | X2 (POS X) | 8 |  |  | POW
 |  | 0261 | FREE | ELEC BAY | DISC | X2 (POS X) | 9
 |  | 0262 | FREE | ELEC BAY | DISC | X2 (POS X) | 10
 |  | 0263 | POW_9V | ELEC BAY | DISC | X2 (POS X) | 11 |  |  | POW
 |  | 0264 | FREE | ELEC BAY | DISC | X2 (POS X) | 12
 |  | 0265 | Q6_AIN_0 | ELEC BAY | DISC | X2 (POS X) | 13 |  |  | Signal
 |  | 0266 | FREE | ELEC BAY | DISC | X2 (POS X) | 14
 |  | 0267 | FREE | ELEC BAY | DISC | X2 (POS X) | 15
 |  | 0268 | ANTENNA_DEPLOYMENT_+V | ELEC BAY | DISC | X2 (POS X) | 16 |  |  | POW
 |  | 0269 | ANTENNA_DEPLOYMENT_GND | ELEC BAY | DISC | X2 (POS X) | 17 |  |  | POW
 |  | 0270 | FREE | ELEC BAY | DISC | X2 (POS X) | 18
 |  | 0271 | FREE | ELEC BAY | DISC | X2 (POS X) | 19
 |  | 0272 | FREE | ELEC BAY | DISC | X2 (POS X) | 20
 |  | 0273 | FREE | ELEC BAY | DISC | X2 (POS X) | 21
 |  | 0274 | FREE | ELEC BAY | DISC | X2 (POS X) | 22
 |  | 0275 | FREE | ELEC BAY | DISC | X2 (POS X) | 23
 |  | 0276 | FREE | ELEC BAY | DISC | X2 (POS X) | 24
 |  | 0277 | FREE | ELEC BAY | DISC | X2 (POS X) | 25
 |  | 0278 | TOP_TEMP_SOLAR_PANEL_1 | ELEC BAY | DISC | X3 (POS X) | 1 |  |  | Sensor
 |  | 0279 | TOP_TEMP_SOLAR_PANEL_2 | ELEC BAY | DISC | X3 (POS X) | 2 |  |  | Sensor
 |  | 0280 | TOP_TEMP_SOLAR_PANEL_3 | ELEC BAY | DISC | X3 (POS X) | 3 |  |  | Sensor
 |  | 0281 | TOP_TEMP_SOLAR_PANEL_4 | ELEC BAY | DISC | X3 (POS X) | 4 |  |  | Sensor
 |  | 0282 | BOTTOM_TEMP_SOLAR_PANEL_1 | ELEC BAY | DISC | X3 (POS X) | 5 |  |  | Sensor
 |  | 0283 | BOTTOM_TEMP_SOLAR_PANEL_2 | ELEC BAY | DISC | X3 (POS X) | 6 |  |  | Sensor
 |  | 0284 | BOTTOM_TEMP_SOLAR_PANEL_3 | ELEC BAY | DISC | X3 (POS X) | 7 |  |  | Sensor
 |  | 0285 | BOTTOM_TEMP_SOLAR_PANEL_4 | ELEC BAY | DISC | X3 (POS X) | 8 |  |  | Sensor
 |  | 0286 | FREE | ELEC BAY | DISC | X3 (POS X) | 9
 |  | 0287 | GND | ELEC BAY | DISC | X3 (POS X) | 10 |  |  | Signal/POW GND?
 |  | 0288 | SDA | ELEC BAY | DISC | X3 (POS X) | 11 |  |  | Signal
 |  | 0289 | SCL | ELEC BAY | DISC | X3 (POS X) | 12 |  |  | Signal
 |  | 0290 | 3V3 | ELEC BAY | DISC | X3 (POS X) | 13 |  |  | POW
 |  | 0291 | TOP_TEMP_SOLAR_PANEL_1_GND | ELEC BAY | DISC | X3 (POS X) | 14 |  |  | Sensor
 |  | 0292 | TOP_TEMP_SOLAR_PANEL_2_GND | ELEC BAY | DISC | X3 (POS X) | 15 |  |  | Sensor
 |  | 0293 | TOP_TEMP_SOLAR_PANEL_3_GND | ELEC BAY | DISC | X3 (POS X) | 16 |  |  | Sensor
 |  | 0294 | TOP_TEMP_SOLAR_PANEL_4_GND | ELEC BAY | DISC | X3 (POS X) | 17 |  |  | Sensor
 |  | 0295 | BOTTOM_TEMP_SOLAR_PANEL_1_GND | ELEC BAY | DISC | X3 (POS X) | 18 |  |  | Sensor
 |  | 0296 | BOTTOM_TEMP_SOLAR_PANEL_2_GND | ELEC BAY | DISC | X3 (POS X) | 19 |  |  | Sensor
 |  | 0297 | BOTTOM_TEMP_SOLAR_PANEL_3_GND | ELEC BAY | DISC | X3 (POS X) | 20 |  |  | Sensor
 |  | 0298 | BOTTOM_TEMP_SOLAR_PANEL_4_GND | ELEC BAY | DISC | X3 (POS X) | 21 |  |  | Sensor
 |  | 0299 | FREE | ELEC BAY | DISC | X3 (POS X) | 22
 |  | 0300 | FREE | ELEC BAY | DISC | X3 (POS X) | 23
 |  | 0301 | FREE | ELEC BAY | DISC | X3 (POS X) | 24
 |  | 0302 | FREE | ELEC BAY | DISC | X3 (POS X) | 25
 |  | 0303 | SOLAR_PANEL_1 | BOT 1U | DISC | X5 (NEG X) | 1 |  |  | POW
 |  | 0304 | SOLAR_PANEL_2 | BOT 1U | DISC | X5 (NEG X) | 2 |  |  | POW
 |  | 0305 | SOLAR_PANEL_3 | BOT 1U | DISC | X5 (NEG X) | 3 |  |  | POW
 |  | 0306 | SOLAR_PANEL_4 | BOT 1U | DISC | X5 (NEG X) | 4 |  |  | POW
 |  | 0307 | SOLAR_PANEL_1_GND | BOT 1U | DISC | X5 (NEG X) | 5 |  |  | POW
 |  | 0308 | SOLAR_PANEL_2_GND | BOT 1U | DISC | X5 (NEG X) | 6 |  |  | POW
 |  | 0309 | SOLAR_PANEL_3_GND | BOT 1U | DISC | X5 (NEG X) | 7 |  |  | POW
 |  | 0310 | SOLAR_PANEL_4_GND | BOT 1U | DISC | X5 (NEG X) | 8 |  |  | POW
 |  | 0311 | FREE | BOT 1U | DISC | X5 (NEG X) | 9
 |  | 0312 | FREE | BOT 1U | DISC | X5 (NEG X) | 10
 |  | 0313 | POW_9V | BOT 1U | DISC | X5 (NEG X) | 11 |  |  | POW
 |  | 0314 | FREE | BOT 1U | DISC | X5 (NEG X) | 12
 |  | 0315 | Q6_AIN_0 | BOT 1U | DISC | X5 (NEG X) | 13 |  |  | Signal
 |  | 0316 | FREE | BOT 1U | DISC | X5 (NEG X) | 14
 |  | 0317 | FREE | BOT 1U | DISC | X5 (NEG X) | 15
 |  | 0318 | ANTENNA_DEPLOYMENT_+V | BOT 1U | DISC | X5 (NEG X) | 16 |  |  | POW
 |  | 0319 | ANTENNA_DEPLOYMENT_GND | BOT 1U | DISC | X5 (NEG X) | 17 |  |  | POW
 |  | 0320 | FREE | BOT 1U | DISC | X5 (NEG X) | 18
 |  | 0321 | FREE | BOT 1U | DISC | X5 (NEG X) | 19
 |  | 0322 | FREE | BOT 1U | DISC | X5 (NEG X) | 20
 |  | 0323 | FREE | BOT 1U | DISC | X5 (NEG X) | 21
 |  | 0324 | FREE | BOT 1U | DISC | X5 (NEG X) | 22
 |  | 0325 | FREE | BOT 1U | DISC | X5 (NEG X) | 23
 |  | 0326 | FREE | BOT 1U | DISC | X5 (NEG X) | 24
 |  | 0327 | FREE | BOT 1U | DISC | X5 (NEG X) | 25
 |  | 0328 | TOP_TEMP_SOLAR_PANEL_1 | BOT 1U | DISC | X6 (NEG X) | 1 |  |  | Sensor
 |  | 0329 | TOP_TEMP_SOLAR_PANEL_2 | BOT 1U | DISC | X6 (NEG X) | 2 |  |  | Sensor
 |  | 0330 | TOP_TEMP_SOLAR_PANEL_3 | BOT 1U | DISC | X6 (NEG X) | 3 |  |  | Sensor
 |  | 0331 | TOP_TEMP_SOLAR_PANEL_4 | BOT 1U | DISC | X6 (NEG X) | 4 |  |  | Sensor
 |  | 0332 | BOTTOM_TEMP_SOLAR_PANEL_1 | BOT 1U | DISC | X6 (NEG X) | 5 |  |  | Sensor
 |  | 0333 | BOTTOM_TEMP_SOLAR_PANEL_2 | BOT 1U | DISC | X6 (NEG X) | 6 |  |  | Sensor
 |  | 0334 | BOTTOM_TEMP_SOLAR_PANEL_3 | BOT 1U | DISC | X6 (NEG X) | 7 |  |  | Sensor
 |  | 0335 | BOTTOM_TEMP_SOLAR_PANEL_4 | BOT 1U | DISC | X6 (NEG X) | 8 |  |  | Sensor
 |  | 0336 | FREE | BOT 1U | DISC | X6 (NEG X) | 9
 |  | 0337 | GND | BOT 1U | DISC | X6 (NEG X) | 10
 |  | 0338 | SDA | BOT 1U | DISC | X6 (NEG X) | 11 |  |  | Signal
 |  | 0339 | SCL | BOT 1U | DISC | X6 (NEG X) | 12 |  |  | Signal
 |  | 0340 | 3V3 | BOT 1U | DISC | X6 (NEG X) | 13 |  |  | POW
 |  | 0341 | TOP_TEMP_SOLAR_PANEL_1_GND | BOT 1U | DISC | X6 (NEG X) | 14 |  |  | Sensor
 |  | 0342 | TOP_TEMP_SOLAR_PANEL_2_GND | BOT 1U | DISC | X6 (NEG X) | 15 |  |  | Sensor
 |  | 0343 | TOP_TEMP_SOLAR_PANEL_3_GND | BOT 1U | DISC | X6 (NEG X) | 16 |  |  | Sensor
 |  | 0344 | TOP_TEMP_SOLAR_PANEL_4_GND | BOT 1U | DISC | X6 (NEG X) | 17 |  |  | Sensor
 |  | 0345 | BOTTOM_TEMP_SOLAR_PANEL_1_GND | BOT 1U | DISC | X6 (NEG X) | 18 |  |  | Sensor
 |  | 0346 | BOTTOM_TEMP_SOLAR_PANEL_2_GND | BOT 1U | DISC | X6 (NEG X) | 19 |  |  | Sensor
 |  | 0347 | BOTTOM_TEMP_SOLAR_PANEL_3_GND | BOT 1U | DISC | X6 (NEG X) | 20 |  |  | Sensor
 |  | 0348 | BOTTOM_TEMP_SOLAR_PANEL_4_GND | BOT 1U | DISC | X6 (NEG X) | 21 |  |  | Sensor
 |  | 0349 | FREE | BOT 1U | DISC | X6 (NEG X) | 22
 |  | 0350 | FREE | BOT 1U | DISC | X6 (NEG X) | 23
 |  | 0351 | FREE | BOT 1U | DISC | X6 (NEG X) | 24
 |  | 0352 | FREE | BOT 1U | DISC | X6 (NEG X) | 25
 |  | 0353 | External_Power_0 | TOP 1U | UMB | X7 | 1 |  |  | POW |  |  |  |  | Pinout taken from
 |  | 0354 | External_Power_1 | TOP 1U | UMB | X7 | 2 |  |  | POW
 |  | 0355 | PA3_JTAG_TDI | TOP 1U | UMB | X7 | 3 |  |  | Signal
 |  | 0356 | PA3_JTAG_TMS | TOP 1U | UMB | X7 | 4 |  |  | Signal
 |  | 0357 | PA3_JTAG_TCK | TOP 1U | UMB | X7 | 5 |  |  | Signal
 |  | 0358 | PA3_JTAG_TDO | TOP 1U | UMB | X7 | 6 |  |  | Signal
 |  | 0359 | PA3_JTAG_TRST_N | TOP 1U | UMB | X7 | 7 |  |  | Signal
 |  | 0360 | S6_JTAG_TDI | TOP 1U | UMB | X7 | 8 |  |  | Signal
 |  | 0361 | S6_JTAG_TMS | TOP 1U | UMB | X7 | 9 |  |  | Signal
 |  | 0362 | S6_JTAG_TCK | TOP 1U | UMB | X7 | 10 |  |  | Signal
 |  | 0363 | S6_JTAG_TDO | TOP 1U | UMB | X7 | 11 |  |  | Signal
 |  | 0364 | Q6_PC_RS232 | TOP 1U | UMB | X7 | 12 |  |  | Signal
 |  | 0365 | PC_Q6_RS232 | TOP 1U | UMB | X7 | 13 |  |  | Signal
 |  | 0366 |  | ROP 1U | UMB | X7 | 14
 |  | 0367 |  | ROP 1U | UMB | X7 | 15
 | Conflict between eagle file and sprdsht | 0368 | 1-GND | ELEC BAY | ACS |  | 1 |  |  | POW
 | Conflict between eagle file and sprdsht | 0369 | 2-VCC | ELEC BAY | ACS |  | 2 |  |  | POW
 | Conflict between eagle file and sprdsht | 0370 | 3-SDA | ELEC BAY | ACS |  | 3 |  |  | Signal
 | Conflict between eagle file and sprdsht | 0371 | 4-SCL | ELEC BAY | ACS |  | 4 |  |  | Signal
 |  | 0372 | ANTENNA_DEPLOYMENT_+V | BOT 1U | AntDeploy | J1 | 1 |  |  | POW
 |  | 0373 | ANTENNA_DEPLOYMENT_GND | BOT 1U | AntDeploy | J1 | 2 |  |  | POW
 | Conflict between eagle file and sprdsht | 0374 | POW_9V |  | PPB |  | 1 |  |  | POW
 | Conflict between eagle file and sprdsht | 0375 | GND |  | PPB |  | 2 |  |  | Signal/POW GND?
 | Conflict between eagle file and sprdsht | 0376 | Q6_AIN_0 |  | PPB |  | 3 |  |  | Signal
 |  | 0377 | TOP_TEMP_SOLAR_PANEL_1 | BOT 1U | SP1 | U6 | 1 |  |  | Sensor
 |  | 0378 | TOP_TEMP_SOLAR_PANEL_1_GND | BOT 1U | SP1 | U6 | 2 |  |  | Sensor
 |  | 0379 | SOLAR_PANEL_1_GND | BOT 1U | SP1 | U6 | 3 |  |  | POW
 |  | 0380 | BOTTOM_TEMP_SOLAR_PANEL_1 | BOT 1U | SP1 | U6 | 4 |  |  | Sensor
 |  | 0381 | SOLAR_PANEL_1 | BOT 1U | SP1 | U6 | 5 |  |  | POW
 |  | 0382 | BOTTOM_TEMP_SOLAR_PANEL_1_GND | BOT 1U | SP1 | U6 | 6 |  |  | Sensor
 |  | 0383 | TOP_TEMP_SOLAR_PANEL_2 | BOT 1U | SP2 | U7 | 1 |  |  | Sensor
 |  | 0384 | TOP_TEMP_SOLAR_PANEL_2_GND | BOT 1U | SP2 | U7 | 2 |  |  | Sensor
 |  | 0385 | SOLAR_PANEL_2_GND | BOT 1U | SP2 | U7 | 3 |  |  | POW
 |  | 0386 | BOTTOM_TEMP_SOLAR_PANEL_2 | BOT 1U | SP2 | U7 | 4 |  |  | Sensor
 |  | 0387 | SOLAR_PANEL_2 | BOT 1U | SP2 | U7 | 5 |  |  | POW
 |  | 0388 | BOTTOM_TEMP_SOLAR_PANEL_2_GND | BOT 1U | SP2 | U7 | 6 |  |  | Sensor
 |  | 0389 | TOP_TEMP_SOLAR_PANEL_3 | BOT 1U | SP3 | U8 | 1 |  |  | Sensor
 |  | 0390 | TOP_TEMP_SOLAR_PANEL_3_GND | BOT 1U | SP3 | U8 | 2 |  |  | Sensor
 |  | 0391 | SOLAR_PANEL_3_GND | BOT 1U | SP3 | U8 | 3 |  |  | POW
 |  | 0392 | BOTTOM_TEMP_SOLAR_PANEL_3 | BOT 1U | SP3 | U8 | 4 |  |  | Sensor
 |  | 0393 | SOLAR_PANEL_3 | BOT 1U | SP3 | U8 | 5 |  |  | POW
 |  | 0394 | BOTTOM_TEMP_SOLAR_PANEL_3_GND | BOT 1U | SP3 | U8 | 6 |  |  | Sensor
 |  | 0395 | TOP_TEMP_SOLAR_PANEL_4 | BOT 1U | SP4 | U9 | 1 |  |  | Sensor
 |  | 0396 | TOP_TEMP_SOLAR_PANEL_4_GND | BOT 1U | SP4 | U9 | 2 |  |  | Sensor
 |  | 0397 | SOLAR_PANEL_4_GND | BOT 1U | SP4 | U9 | 3 |  |  | POW
 |  | 0398 | BOTTOM_TEMP_SOLAR_PANEL_4 | BOT 1U | SP4 | U9 | 4 |  |  | Sensor
 |  | 0399 | SOLAR_PANEL_4 | BOT 1U | SP4 | U9 | 5 |  |  | POW
 |  | 0400 | BOTTOM_TEMP_SOLAR_PANEL_4_GND | BOT 1U | SP4 | U9 | 6 |  |  | Sensor
 |  | 0401
 |  | 0402
 |  | 0403
 |  | 0404
 |  | 0405
 |  | 0406
 |  | 0407
 |  | 0408
 |  | 0409
 |  | 0410
 |  | 0411
 |  | 0412
 |  | 0413
 |  | 0414
 |  | 0415
 |  | 0416
 |  | 0417
 |  | 0418
 |  | 0419
 |  | 0420
 |  | 0421
 |  | 0422
 |  | 0423
 |  | 0424
 |  | 0425
 |  | 0426
 |  | 0427
 |  | 0428
 |  | 0429
 |  | 0430
 |  | 0431
 |  | 0432
 |  | 0433
 |  | 0434
 |  | 0435
 |  | 0436
 |  | 0437
 |  | 0438
 |  | 0439
 |  | 0440
 |  | 0441
 |  | 0442
 |  | 0443
 |  | 0444
 |  | 0445
 |  | 0446
 |  | 0447
 |  | 0448
 |  | 0449
 |  | 0450
 |  | 0451
 |  | 0452
 |  | 0453
 |  | 0454
 |  | 0455
 |  | 0456
 |  | 0457
 |  | 0458
 |  | 0459
 |  | 0460
 |  | 0461
 |  | 0462
 |  | 0463
 |  | 0464
 |  | 0465
 |  | 0466
 |  | 0467
 |  | 0468
 |  | 0469
 |  | 0470
 |  | 0471
 |  | 0472
 |  | 0473
 |  | 0474
 |  | 0475
 |  | 0476
 |  | 0477
 |  | 0478
 |  | 0479
 |  | 0480
 |  | 0481
 |  | 0482
 |  | 0483
 |  | 0484
 |  | 0485
 |  | 0486
 |  | 0487
 |  | 0488
 |  | 0489
 |  | 0490
 |  | 0491
 |  | 0492
 |  | 0493
 |  | 0494
 |  | 0495
 |  | 0496
 |  | 0497
 |  | 0498
 |  | 0499
 |  | 0500
 |  | 0501
 |  | 0502
 |  | 0503
 |  | 0504
 |  | 0505
 |  | 0506
 |  | 0507
 |  | 0508
 |  | 0509
 |  | 0510
 |  | 0511
 |  | 0512
 |  | 0513
 |  | 0514
 |  | 0515
 |  | 0516
 |  | 0517
 |  | 0518
 |  | 0519
 |  | 0520
 |  | 0521
 |  | 0522
 |  | 0523
 |  | 0524
 |  | 0525
 |  | 0526
 |  | 0527
 |  | 0528
 |  | 0529
 |  | 0530
 |  | 0531
 |  | 0532
 |  | 0533
 |  | 0534
 |  | 0535
 |  | 0536
 |  | 0537
 |  | 0538
 |  | 0539
 |  | 0540
 |  | 0541
 |  | 0542
 |  | 0543
 |  | 0544
 |  | 0545
 |  | 0546
 |  | 0547
 |  | 0548
 |  | 0549
 |  | 0550
 |  | 0551
 |  | 0552
 |  | 0553
 |  | 0554
 |  | 0555
 |  | 0556
 |  | 0557
 |  | 0558
 |  | 0559
 |  | 0560
 |  | 0561
 |  | 0562
 |  | 0563
