spaceconcordia/Consat1Electrical/Wiring Harness/104 PIN HEADER.ods

Function | Name | Pin | Header | Pin | Name | Function
ANTTENA DEPLOYMENT +V | ANTENNA_DEPLOYMENT_+V | 1 | H1 | 2 | SOLAR_PANEL_2_4 | SOLAR PANEL 2 AND 4 | CDH
ANTTENA DEPLOYMENT -V | ANTENNA_DEPLOYMENT_GND | 3 | H1 | 4 | BATTERY_HEATER_+V | Battery Heater Power | POW
CDH PCB THERMISTORS GND | THERMALGND | 5 | H1 | 6 | BATTERY_HEATER_-V | Battery Heater Power | PAYLOAD
Q6_GPIO_6 (unused?) | Q6_GPIO_6 | 7 | H1 | 8 | BATTERY_THRMSTOR1_+V | Battery Temp Sense 1 | COMMS
Q6_GPIO_7 | Q6_GPIO_7 | 9 | H1 | 10 | BATTERY_THRMSTOR_-V | Battery Temp Sense Ground
Q6_GPIO_8 | Q6_GPIO_8 | 11 | H1 | 12 | BATTERY_THRMSTOR2_+V | Battery Temp Sense 2
Watch Dog Input | Q6_GPIO_0 | 13 | H1 | 14 | GND | COMMON GND
COMMON GND | GND | 15 | H1 | 16 | POW-3V3 | POWER 3V3 - POW_RADIO _3V3 - through payload board
TRANSCEIVER UART TRANSMIT | RADIO_UART_TX | 17 | H1 | 18 | RADIO_UART_RX | TRANSCEIVER UART RECEIVE | Made mistake on sheet
COMMON GND | GND | 19 | H1 | 20 | POW-3V3 | POWER 3V3
 | PC_Q6_RX_RS232 | 21 | H1 | 22 | POW-9V | POWER 9V
COMMON GND | GND | 23 | H1 | 24 | POW-9V | POWER 9V
 | Q6_PC_TX_RS232 | 25 | H1 | 26 | POW-5V | POWER 5V
COMMON GND | GND | 27 | H1 | 28 | POW-5V | POWER 5V
SOLAR PANEL 1 AND 3 | SOLAR_PANEL_1_3 | 29 | H1 | 30 | SOLAR_PANEL_GND | SOLAR PANEL GROUND
SOLAR PANEL GROUND | SOLAR_PANEL_GND | 31 | H1 | 32 | Q6_GPIO_10 | Q6_GPIO_10 ( Use for EPS Board )
BATTERY -V | POW_BATT_GND | 33 | H1 | 34 | GND | COMMON GND
BATTERY +V | POW_BATT_V_TO_LOAD | 35 | H1 | 36 | Q6_GPIO_13 | PAYLOAD VOLTAGE CONTROL
COMMON GROUND | GND | 37 | H1 | 38 | Q6_GPIO_14 | ANTENNA CONTROL
Q6 ADC 0 | Q6_AIN_0 | 39 | H1 | 40 | Q6_GPIO_15 | 3V3 CONTROL
COMMON GND | GND | 41 | H1 | 42 | FREE
Q6 ADC 1 | Q6_AIN_1 | 43 | H1 | 44 | GND | COMMON GND
COMMON GND | GND | 45 | H1 | 46 | FREE
Q6 DAC 0 | Q6_AOUT_0 | 47 | H1 | 48 | GND | COMMON GND
COMMON GND | GND | 49 | H1 | 50 | Q6_GPIO_10 | Q6_GPIO_10 ( Use for EPS Board, not connected on CDH yet )
Q6 DAC 1 | Q6_AOUT_1 | 51 | H1 | 52 | GND | COMMON GND
TEMP SENSOR FOR TOP HALF OF SOLAR PANEL | TOP_TEMP_SOLAR_PANEL-1 | 1 | H2 | 2 | POW_BATT_V_FROM_BCR | BATTERY V+
TEMP SENSOR FOR TOP HALF OF SOLAR PANEL | TOP_TEMP_SOLAR_PANEL-2 | 3 | H2 | 4 | GND | COMMON GND
TEMP SENSOR FOR TOP HALF OF SOLAR PANEL | TOP_TEMP_SOLAR_PANEL-3 | 5 | H2 | 6 | Q6_SPI_SCLK | Q6 SPI CLOCK
TEMP SENSOR FOR TOP HALF OF SOLAR PANEL | TOP_TEMP_SOLAR_PANEL-4 | 7 | H2 | 8 | Q6_SPI_SDO_MOSI | Q6 SPI DATA OUT ( MASTER OUT SLAVE IN )
TEMP SENSOR FOR BOTTOM HALF OF SOLAR PANEL | BOTTOM_TEMP_SOLAR_PANEL-1 | 9 | H2 | 10 | Q6_SPI_SDI_MISO | Q6 SPI DATA IN ( MASTER IN SLAVE OUT )
TEMP SENSOR FOR BOTTOM HALF OF SOLAR PANEL | BOTTOM_TEMP_SOLAR_PANEL-2 | 11 | H2 | 12 | Q6_SPI_CS1 | Q6 SPI CHIP SELECT 1
TEMP SENSOR FOR BOTTOM HALF OF SOLAR PANEL | BOTTOM_TEMP_SOLAR_PANEL-3 | 13 | H2 | 14 | Q6_SPI_CS0 | Q6 SPI CHIP SELECT 0
TEMP SENSOR FOR BOTTOM HALF OF SOLAR PANEL | BOTTOM_TEMP_SOLAR_PANEL-4 | 15 | H2 | 16 | GND | COMMON GND
COMMON GROUND | GND | 17 | H2 | 18 | Q6_I2C_SDA_1 | Q6 I2C BUS 1 DATA
COMMON GROUND | GND | 19 | H2 | 20 | Q6_I2C_SCL_1 | Q6 I2C BUS 1 CLOCK
 | FREE | 21 | H2 | 22 | GND | COMMON GND
 | FREE | 23 | H2 | 24 | Q6_GPIO_2 | Q6 GPIO 2
 | FREE | 25 | H2 | 26 | GND | COMMON GND
3V3 LINE FROM POWER FOR TRANSCEIVER(Connecting to H1 on payload board pow_3v3 line) | POW_RADIO_3.3V | 27 | H2 | 28 | POW_RADIO_3.3VSYS | 3V3 LINE FROM POWER FOR TRANSCEIVER(Connecting to H1 on payload board pow_3v3 line)
GND LINE FROM POWER FOR TRANSCEIVER | POW_RADIO_GND | 29 | H2 | 30 | POW_RADIO_GND
MECHANICAL DEPLOYMENT SWITCH +V | MECH_DEPLOYMENT_SWITCH_+V | 31 | H2 | 32 | POW_RADIO_GND
MECHANICAL DEPLOYMENT SWITCH -V | MECH_DEPLOYMENT_SWITCH_-V | 33 | H2 | 34 | FREE
 | FREE | 35 | H2 | 36 | Q6_3V3 | Q6 3.3V LINE
 | FREE | 37 | H2 | 38 | Q6_3V3 | Q6 3.3V LINE
 | FREE | 39 | H2 | 40 | FREE
 | FREE | 41 | H2 | 42 | FREE
 | FREE | 43 | H2 | 44 | FREE
POWER FOR TRANSCEIVER BATTERY | POW_RADIO_VBATT | 45 | H2 | 46 | POW_RADIO_VBATT | 5V POWER TO TRANSCEIVER
 | FREE | 47 | H2 | 48 | FREE
 | FREE | 49 | H2 | 50 | ELEC_BAY_TEMP_1 | ELECTRONICS BAY TEMPERATURE SENSOR 1
EXTERNAL POWER WHEN POWER CONTINUITY PLUG IS IN | EXTERNAL_POWER_GND | 51 | H2 | 52 | EXTERNAL_POWER_+V | EXTERNAL POWER WHEN POWER CONTINUITY PLUG IS IN
