spaceconcordia/Consat1Electrical/Wiring Harness/20131201 - Continuity Check.ods

DB15 Umbillical Cord Connector (External) |  |  |  |  |  | DB25 -Z ECU Connector (to ECU Zone) |  |  |  |  |  | DB25 +Z,-X ECU Connector (to ECU Zone) |  |  |  |  |  | DB25 +Z,+X ECU Connector (to ECU Zone)
Pin # | Signal Name | Connecting Component | Connector | Connecting Pin # | Verified | Pin # | Signal Name | Connecting Component | Connector | Connecting Pin # | Verified | Pin # | Signal Name | Connecting Component | Connector | Connecting Pin # | Verified | Pin # | Signal Name | Connecting Component | Connector | Connecting Pin # | Verified
1 |  |  |  |  |  | 1 | DEPLOY_SWITCH_1 |  |  |  |  | 1 | SOLAR_PANEL_4_TOP_TEMP | Auxiliary PCB | 16-Pin Receptacle -X | 4 | Y | 1 | SOLAR_PANEL_4 | SOLAR_PANEL_2 wire | DB25 +Z,+X ECU Connector (to ECU Zone) | 2 | Y
2 |  |  |  |  |  | 2 | DEPLOY_SWITCH_2 |  |  |  |  | 2 | SOLAR_PANEL_4_BOT_TEMP | Auxiliary PCB | 16-Pin Receptacle -X | 8 | Y | 2 | SOLAR_PANEL_2 | Auxiliary PCB | 16-Pin Receptacle +X | 3 | Y
3 |  |  |  |  |  | 3 | N/C |  |  |  |  | 3 | SOLAR_PANEL_2_TOP_TEMP | Auxiliary PCB | 16-Pin Receptacle -X | 2 | Y | 3 | SOLAR_PANEL_3 | SOLAR_PANEL_1 wire | DB25 +Z,+X ECU Connector (to ECU Zone) | 4 | Y
4 |  |  |  |  |  | 4 | EXTERNAL_POWER_0 |  |  |  |  | 4 | SOLAR_PANEL_2_BOT_TEMP | Auxiliary PCB | 16-Pin Receptacle -X | 6 | Y | 4 | SOLAR_PANEL_1 | Auxiliary PCB | 16-Pin Receptacle +X | 1 | Y
5 |  |  |  |  |  | 5 | EXTERNAL_POWER_1 |  |  |  |  | 5 | SOLAR_PANEL_3_TOP_TEMP | Auxiliary PCB | 16-Pin Receptacle -X | 3 | Y | 5 | ADS_3V3 | Auxiliary PCB | 16-Pin Receptacle -X | 13 | Y
6 |  |  |  |  |  | 6 | N/C |  |  |  |  | 6 | SOLAR_PANEL_3_BOT_TEMP | Auxiliary PCB | 16-Pin Receptacle -X | 7 | Y | 6 | PAY_9V | Auxiliary PCB | 16-Pin Receptacle +X | 12 | Y
7 |  |  |  |  |  | 7 | N/C |  |  |  |  | 7 | SOLAR_PANEL_1_TOP_TEMP | Auxiliary PCB | 16-Pin Receptacle -X | 1 | Y | 7 | - | - | - | - | -
8 |  |  |  |  |  | 8 | TX- |  |  |  |  | 8 | SOLAR_PANEL_1_BOT_TEMP | Auxiliary PCB | 16-Pin Receptacle -X | 5 | Y | 8 | - | - | - | - | -
9 |  |  |  |  |  | 9 | TX+ |  |  |  |  | 9 | PAY_TEMP | Auxiliary PCB | 16-Pin Receptacle +X | 7 | Y | 9 | - | - | - | - | -
10 |  |  |  |  |  | 10 | RX- |  |  |  |  | 10 | ADS_SCL | Auxiliary PCB | 16-Pin Receptacle -X | 15 | Y | 10 | - | - | - | - | -
11 |  |  |  |  |  | 11 | RX+ |  |  |  |  | 11 | PAY_AIN | Auxiliary PCB | 16-Pin Receptacle +X | 11 | Y | 11 | - | - | - | - | -
12 |  |  |  |  |  | 12 | CONTINUITY_1 |  |  |  |  | 12 | - | - | - | - | - | 12 | - | - | - | - | -
13 |  |  |  |  |  | 13 | CONTINUITY_2 |  |  |  |  | 13 | - | - | - | - | - | 13 | AHRM_VBATT | Auxiliary PCB | 16-Pin Receptacle +X | 16 | Y
14 |  |  |  |  |  | 14 | PA3_JTAG_TDI |  |  |  |  | 14 | SOLAR_PANEL_4_TOP_TEMP_GND | PAY_TEMP_GND wire | DB25 +Z,-X ECU Connector (to ECU Zone) | 22 | Y | 14 | SOLAR_PANEL_4_GND | SOLAR_PANEL_2_GND wire | DB25 +Z,+X ECU Connector (to ECU Zone) | 15 | Y
15 |  |  |  |  |  | 15 | PA3_JTAG_TMS |  |  |  |  | 15 | SOLAR_PANEL_4_BOT_TEMP_GND | PAY_TEMP_GND wire | DB25 +Z,-X ECU Connector (to ECU Zone) | 22 | Y | 15 | SOLAR_PANEL_2_GND | Auxiliary PCB | 16-Pin Receptacle +X | 4 | Y
 |  |  |  |  |  | 16 | PA3_JTAG_TCK |  |  |  |  | 16 | SOLAR_PANEL_2_TOP_TEMP_GND | PAY_TEMP_GND wire | DB25 +Z,-X ECU Connector (to ECU Zone) | 22 | Y | 16 | SOLAR_PANEL_3_GND | SOLAR_PANEL_1_GND wire | DB25 +Z,+X ECU Connector (to ECU Zone) | 17 | Y
 |  |  |  |  |  | 17 | PA3_JTAG_TDO |  |  |  |  | 17 | SOLAR_PANEL_2_BOT_TEMP_GND | PAY_TEMP_GND wire | DB25 +Z,-X ECU Connector (to ECU Zone) | 22 | Y | 17 | SOLAR_PANEL_1_GND | Auxiliary PCB | 16-Pin Receptacle +X | 2 | Y
 |  |  |  |  |  | 18 | PA3_JTAG_TRST_N |  |  |  |  | 18 | SOLAR_PANEL_3_TOP_TEMP_GND | PAY_TEMP_GND wire | DB25 +Z,-X ECU Connector (to ECU Zone) | 22 | Y | 18 | ADS_GND | PAY_GND wire | DB25 +Z,+X ECU Connector (to ECU Zone) | 19 | Y
 |  |  |  |  |  | 19 | N/C |  |  |  |  | 19 | SOLAR_PANEL_3_BOT_TEMP_GND | PAY_TEMP_GND wire | DB25 +Z,-X ECU Connector (to ECU Zone) | 22 | Y | 19 | PAY_GND | Auxiliary PCB | 16-Pin Receptacle -X | 14 | Y
 |  |  |  |  |  | 20 | S6_JTAG_TDI |  |  |  |  | 20 | SOLAR_PANEL_1_TOP_TEMP_GND | PAY_TEMP_GND wire | DB25 +Z,-X ECU Connector (to ECU Zone) | 22 | Y | 20 | - | - | - | - | -
 |  |  |  |  |  | 21 | S6_JTAG_TMS |  |  |  |  | 21 | SOLAR_PANEL_1_BOT_TEMP_GND | PAY_TEMP_GND wire | DB25 +Z,-X ECU Connector (to ECU Zone) | 22 | Y | 21 | - | - | - | - | -
 |  |  |  |  |  | 22 | S6_JTAG_TCK |  |  |  |  | 22 | PAY_TEMP_GND | Auxiliary PCB | 16-Pin Receptacle -X | 9 | Y | 22 | - | - | - | - | -
 |  |  |  |  |  | 23 | S6_JTAG_TDO |  |  |  |  | 23 | ADS_SDA | Auxiliary PCB | 16-Pin Receptacle -X | 16 | Y | 23 | - | - | - | - | -
 |  |  |  |  |  | 24 | JTAG_3V3 |  |  |  |  | 24 | PAY_AGND | PAY_GND wire | DB25 +Z,+X ECU Connector (to ECU Zone) | 19 | Y | 24 | - | - | - | - | -
 |  |  |  |  |  | 25 | JTAG_GND |  |  |  |  | 25 | - | - | - | - | - | 25 | AHRM_GND | Auxiliary PCB | 16-Pin Receptacle +X | 15 | Y
DB15 Umbillical Cord Connector (Internal) |  |  |  |  |  | DB25 -Z ECU Connector (to ACS Zone) |  |  |  |  |  | DB25 -Z,-X ECU Connector (To Payload Zone) |  |  |  |  |  | DB25 -Z,+X ECU Connector (To Payload Zone)
Pin # | Signal Name | Connecting Component | Connector | Connecting Pin # | Verified | Pin # | Signal Name | Connecting Component | Connector | Connecting Pin # | Verified | Pin # | Signal Name | Connecting Component | Connector | Connecting Pin # | Verified | Pin # | Signal Name | Connecting Component | Connector | Connecting Pin # | Verified
1 | RX+ |  |  |  |  | 1 | DEPLOY_SWITCH_1 | Deployment Switch | Spliced Wire | - | Y | 1 | SOLAR_PANEL_4_TOP_TEMP | Solar Panel 4 -Y | 6-Pin Receptacle | 1 | Y | 1 | SOLAR_PANEL_4 | Solar Panel 4 -Y | 6-Pin Receptacle | 3 | Y
2 | TX+ |  |  |  |  | 2 | DEPLOY_SWITCH_2 | Deployment Switch | Spliced Wire | - | Y | 2 | SOLAR_PANEL_4_BOT_TEMP | Solar Panel 4 -Y | 6-Pin Receptacle | 5 | Y | 2 | SOLAR_PANEL_2 | Solar Panel 2 +Y | 6-Pin Receptacle | 3 | Y
3 | EXTERNAL_POWER_1 |  |  |  |  | 3 | N/C | - | - | - | - | 3 | SOLAR_PANEL_2_TOP_TEMP | Solar Panel 2 +Y | 6-Pin Receptacle | 1 | Y | 3 | SOLAR_PANEL_3 | Solar Panel 3 -X | 6-Pin Receptacle | 3 | Y
4 | S6_JTAG_TDI |  |  |  |  | 4 | EXTERNAL_POWER_0 | Umbillical Cord | DB15 | 11 | Y | 4 | SOLAR_PANEL_2_BOT_TEMP | Solar Panel 2 +Y | 6-Pin Receptacle | 6 | Y | 4 | SOLAR_PANEL_1 | Solar Panel 1 +X | 6-Pin Receptacle | 3 | Y
5 | S6_JTAG_TCK |  |  |  |  | 5 | EXTERNAL_POWER_1 | Umbillical Cord | DB15 | 3 | Y | 5 | SOLAR_PANEL_3_TOP_TEMP | Solar Panel 3 -X | 6-Pin Receptacle | 1 | Y | 5 | ADS_3V3 | ADS Magnetometer | 4-Pin Receptacle | NO CONNECTOR
6 | PA3_JTAG_TRST_N |  |  |  |  | 6 | N/C | - | - | - | - | 6 | SOLAR_PANEL_3_BOT_TEMP | Solar Panel 3 -X | 6-Pin Receptacle | 6 | Y | 6 | PAY_9V | Payload PCB | 4-Pin Receptacle | 2 | Y
7 | JTAG_3V3 |  |  |  |  | 7 | N/C | - | - | - | - | 7 | SOLAR_PANEL_1_TOP_TEMP | Solar Panel 1 +X | 6-Pin Receptacle | 4 | Y | 7 | - | N/C |  | - | -
8 | PA3_JTAG_TCK |  |  |  |  | 8 | TX- | Umbillical Cord | DB15 | 10 | Y | 8 | SOLAR_PANEL_1_BOT_TEMP | Solar Panel 1 +X | 6-Pin Receptacle | 6 | Y | 8 | - | N/C |  | - | -
9 | RX- |  |  |  |  | 9 | TX+ | Umbillical Cord | DB15 | 2 | Y | 9 | PAY_TEMP | Payload Thermistor | 4-Pin Receptacle | NO CONNECTOR |  | 9 | - | N/C |  | - | -
10 | TX- |  |  |  |  | 10 | RX- | Umbillical Cord | DB15 | 9 | Y | 10 | ADS_SCL | ADS Magnetometer | 4-Pin Receptacle | NO CONNECTOR |  | 10 | - | N/C |  | - | -
11 | EXTERNAL_POWER_0 |  |  |  |  | 11 | RX+ | Umbillical Cord | DB15 | 1 | Y | 11 | PAY_AIN | Payload PCB | 4-Pin Receptacle | 2 | Y | 11 | - | N/C |  | - | -
12 | S6_JTAG_TMS |  |  |  |  | 12 | CONTINUITY_1 | Deployment Switch | Spliced Wire | - | Y | 12 | - | N/C |  | - | - | 12 | - | N/C |  | - | -
13 | S6_JTAG_TDO |  |  |  |  | 13 | CONTINUITY_2 | Deployment Switch | Spliced Wire | - | Y | 13 | - | N/C |  | - | - | 13 | AHRM_VBATT | AHRM PCB | 6-Pin Receptacle | 1 | Y
14 | PA3_JTAG_TMS |  |  |  |  | 14 | PA3_JTAG_TDI | Umbillical Cord | NO CONNECTOR | - | Y | 14 | SOLAR_PANEL_4_TOP_TEMP_GND | Solar Panel 4 -Y | 6-Pin Receptacle | 4 | Y | 14 | SOLAR_PANEL_4_GND | Solar Panel 4 -Y | 6-Pin Receptacle | 2 | Y
15 | JTAG_GND |  |  |  |  | 15 | PA3_JTAG_TMS | Umbillical Cord | DB15 | 14 | Y | 15 | SOLAR_PANEL_4_BOT_TEMP_GND | Solar Panel 4 -Y | 6-Pin Receptacle | 6 | Y | 15 | SOLAR_PANEL_3_GND | Solar Panel 3 -X | 6-Pin Receptacle | 2 | Y
 |  |  |  |  |  | 16 | PA3_JTAG_TCK | Umbillical Cord | DB15 | 8 | Y | 16 | SOLAR_PANEL_3_TOP_TEMP_GND | Solar Panel 3 -X | 6-Pin Receptacle | 4 | Y | 16 | SOLAR_PANEL_2_GND | Solar Panel 2 +Y | 6-Pin Receptacle | 2 | Y
 |  |  |  |  |  | 17 | PA3_JTAG_TDO | Umbillical Cord | NO CONNECTOR | - | Y | 17 | SOLAR_PANEL_3_BOT_TEMP_GND | Solar Panel 3 -X | 6-Pin Receptacle | 5 | Y | 17 | SOLAR_PANEL_1_GND | Solar Panel 1 +X | 6-Pin Receptacle | 2 | Y
 |  |  |  |  |  | 18 | PA3_JTAG_TRST_N | Umbillical Cord | DB15 | 6 | Y | 18 | SOLAR_PANEL_2_TOP_TEMP_GND | Solar Panel 2 +Y | 6-Pin Receptacle | 4 | Y | 18 | ADS_GND | ADS Magnetometer | 4-Pin Receptacle | NO CONNECTOR
 |  |  |  |  |  | 19 | N/C | - | - | - | - | 19 | SOLAR_PANEL_2_BOT_TEMP_GND | Solar Panel 2 +Y | 6-Pin Receptacle | 5 | Y | 19 | PAY_GND | Payload PCB | 4-Pin Receptacle | 3 | Y
 |  |  |  |  |  | 20 | S6_JTAG_TDI | Umbillical Cord | DB15 | 4 | Y | 20 | SOLAR_PANEL_1_TOP_TEMP_GND | Solar Panel 1 +X | 6-Pin Receptacle | 1 | Y | 20 | - | N/C |  | - | -
 |  |  |  |  |  | 21 | S6_JTAG_TMS | Umbillical Cord | DB15 | 12 | Y | 21 | SOLAR_PANEL_1_BOT_TEMP_GND | Solar Panel 1 +X | 6-Pin Receptacle | 5 | Y | 21 | - | N/C |  | - | -
 |  |  |  |  |  | 22 | S6_JTAG_TCK | Umbillical Cord | DB15 | 5 | Y | 22 | PAY_TEMP_GND | Payload Thermistor | 4-Pin Receptacle | NO CONNECTOR |  | 22 | - | N/C |  | - | -
 |  |  |  |  |  | 23 | S6_JTAG_TDO | Umbillical Cord | DB15 | 13 | Y | 23 | ADS_SDA | ADS Magnetometer | 4-Pin Receptacle | NO CONNECTOR |  | 23 | - | N/C |  | - | -
 |  |  |  |  |  | 24 | S6_JTAG_3V3 | Umbillical Cord | DB15 | 7 | Y | 24 | PAY_AGND | Payload PCB | 4-Pin Receptacle | 3 | Y | 24 | - | N/C |  | - | -
 |  |  |  |  |  | 25 | GND | Umbillical Cord | DB15 | 15 | Y | 25 | - | N/C |  | - | - | 25 | AHRM_GND | AHRM PCB | 6-Pin Receptacle | 3 | Y
