spaceconcordia/Consat1Electrical/Wiring Harness/DB25 wiring.ods

PIN | Top | Bottom 1 | Bottom 2 |  | 15pin umbilical cord | ACS | Antenna Deploayment | Payload Power Board | Solarpanelpins | Solar Panel 1 | Solar Panel 2 | Solar Panel 3 | Solar Panel 4
1 | Mech_Deploy_Switch_0 | SOLAR_PANEL_1 | TOP_TEMP_SOLAR_PANEL_1 | 1 | External_Power_0 | 1-GND | ANTENNA_DEPLOYMENT_+V | POW_9V | 1 | TOP_TEMP_SOLAR_PANEL_1 | TOP_TEMP_SOLAR_PANEL_2 | TOP_TEMP_SOLAR_PANEL_3 | TOP_TEMP_SOLAR_PANEL_4
2 | Mech_Deploy_Switch_1 | SOLAR_PANEL_2 | TOP_TEMP_SOLAR_PANEL_2 | 2 | External_Power_1 | 2-VCC | ANTENNA_DEPLOYMENT_GND | GND | 2 | TOP_TEMP_SOLAR_PANEL_1_GND | TOP_TEMP_SOLAR_PANEL_2_GND | TOP_TEMP_SOLAR_PANEL_3_GND | TOP_TEMP_SOLAR_PANEL_4_GND
3 |  | SOLAR_PANEL_3 | TOP_TEMP_SOLAR_PANEL_3 | 3 | PA3_JTAG_TDI | 3-SDA |  | Q6_AIN_0 | 3 | SOLAR_PANEL_1_GND | SOLAR_PANEL_2_GND | SOLAR_PANEL_3_GND | SOLAR_PANEL_4_GND
4 | External_Power_0 | SOLAR_PANEL_4 | TOP_TEMP_SOLAR_PANEL_4 | 4 | PA3_JTAG_TMS | 4-SCL |  |  | 4 | BOTTOM_TEMP_SOLAR_PANEL_1 | BOTTOM_TEMP_SOLAR_PANEL_2 | BOTTOM_TEMP_SOLAR_PANEL_3 | BOTTOM_TEMP_SOLAR_PANEL_4
5 | External_Power_1 | SOLAR_PANEL_1_GND | BOTTOM_TEMP_SOLAR_PANEL_1 | 5 | PA3_JTAG_TCK |  |  |  | 5 | SOLAR_PANEL_1 | SOLAR_PANEL_2 | SOLAR_PANEL_3 | SOLAR_PANEL_4
6 |  | SOLAR_PANEL_2_GND | BOTTOM_TEMP_SOLAR_PANEL_2 | 6 | PA3_JTAG_TDO |  |  |  | 6 | BOTTOM_TEMP_SOLAR_PANEL_1_GND | BOTTOM_TEMP_SOLAR_PANEL_2_GND | BOTTOM_TEMP_SOLAR_PANEL_3_GND | BOTTOM_TEMP_SOLAR_PANEL_4_GND
7 |  | SOLAR_PANEL_3_GND | BOTTOM_TEMP_SOLAR_PANEL_3 | 7 | PA3_JTAG_TRST_N
8 | Q6_PC_RS232 | SOLAR_PANEL_4_GND | BOTTOM_TEMP_SOLAR_PANEL_4 | 8 | S6_JTAG_TDI
9 | PC_Q6_RS232 |  |  | 9 | S6_JTAG_TMS
10 |  |  | GND | 10 | S6_JTAG_TCK
11 |  | POW_9V | SDA | 11 | S6_JTAG_TDO
12 |  | GND | SCL | 12 | Q6_PC_RS232
13 |  | Q6_AIN_0 | 3V3 | 13 | PC_Q6_RS232
14 | PA3_JTAG_TDI |  | TOP_TEMP_SOLAR_PANEL_1_GND | 14
15 | PA3_JTAG_TMS |  | TOP_TEMP_SOLAR_PANEL_2_GND | 15
16 | PA3_JTAG_TCK | ANTENNA_DEPLOYMENT_+V | TOP_TEMP_SOLAR_PANEL_3_GND
17 | PA3_JTAG_TDO | ANTENNA_DEPLOYMENT_GND | TOP_TEMP_SOLAR_PANEL_4_GND
18 | PA3_JTAG_TRST_N |  | BOTTOM_TEMP_SOLAR_PANEL_1_GND
19 |  |  | BOTTOM_TEMP_SOLAR_PANEL_2_GND
20 | S6_JTAG_TDI |  | BOTTOM_TEMP_SOLAR_PANEL_3_GND
21 | S6_JTAG_TMS |  | BOTTOM_TEMP_SOLAR_PANEL_4_GND
22 | S6_JTAG_TCK
23 | S6_JTAG_TDO
24 | JTAG_3V3
25 | JTAG_GND
