spaceconcordia/Consat1Electrical/(threads)

Thread 1 (2016-07-09):

Validate trace thickness/current capacity for antenna deployment circuit

shayden--, 2016-07-09:
On the payload-int-aux board of cs1benchsat, the traces for this circuit are 0.406mm wide, which is risky/inefficient for a heavy current load circuit.

Increase the trace width to a demonstrably appropriate size and validate the trace length/current capacity through all PCBs and wiring harness.

Thread 2 (2016-07-10):

Validate trace thickness/current capacity for solar panel +v and GND circuit

shayden--, 2016-07-10:
On the payload-int-aux board of cs1benchsat, the traces for this circuit VARY from 1.016mm (+v ccts) to 0.406mm wide (gnd) , which is risky/inefficient for a heavy current load circuit.

Increase the trace width to a demonstrably appropriate size, ensure that size is uniform and validate the trace length/current capacity through all PCBs and wiring harness.

shayden--, 2018-05-17:
This hardware is obsolete.

Closed 2018-05-17.
