spaceconcordia/Consat1Electrical/ACS/ACS_PCB.pdf

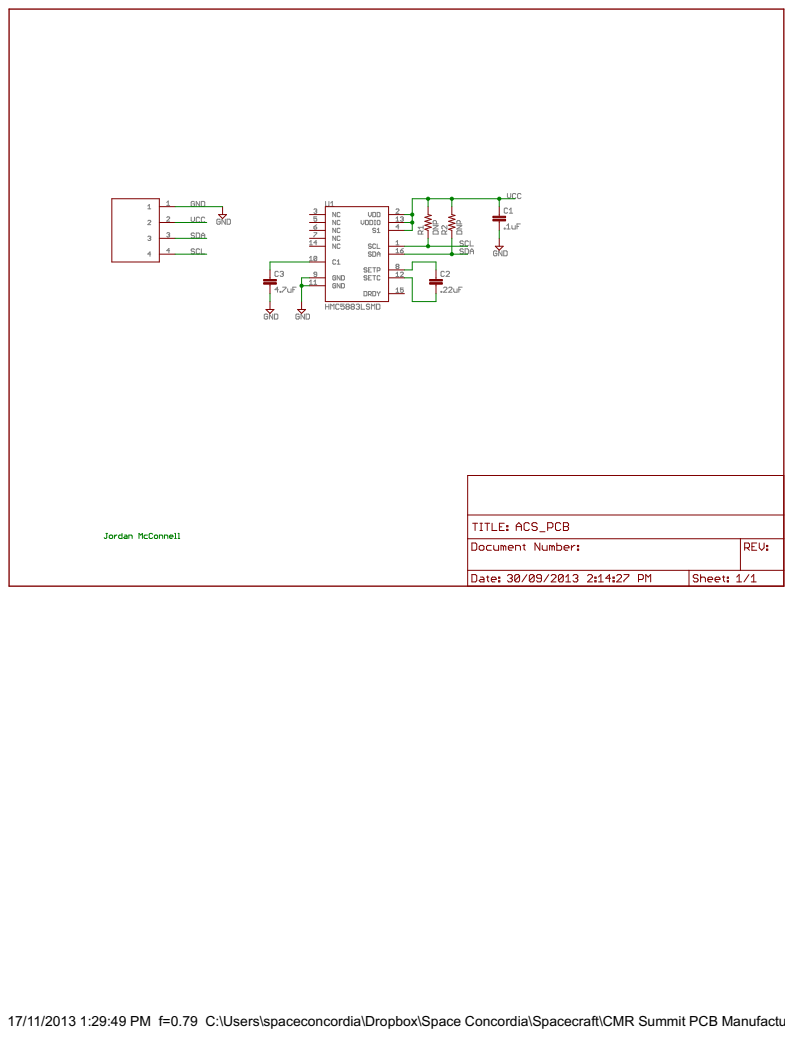
[picture p1: page 1]

17/11/2013 1:29:49 PM f=0.79 C:\Users\spaceconcordia\Dropbox\Space Concordia\Spacecraft\CMR Summit PCB Manufacturing\ACS PCB\ACS_PCB.sch (Sheet: 1/1)
