spaceconcordia/Consat1Electrical/ACS/ACS_PCB1to1.pdf

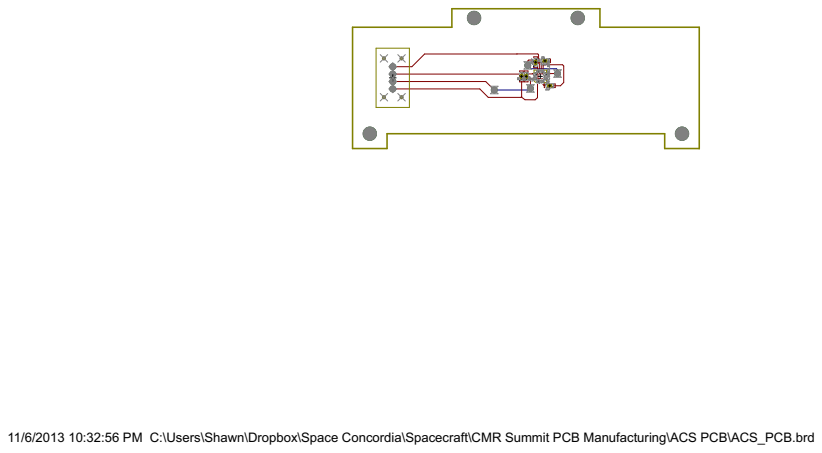
[picture p2: page 1]

11/6/2013 10:32:56 PM C:\Users\Shawn\Dropbox\Space Concordia\Spacecraft\CMR Summit PCB Manufacturing\ACS PCB\ACS_PCB.brd
