spaceconcordia/Consat1Electrical/Deployment AHRM/Deployment_PCB.pdf

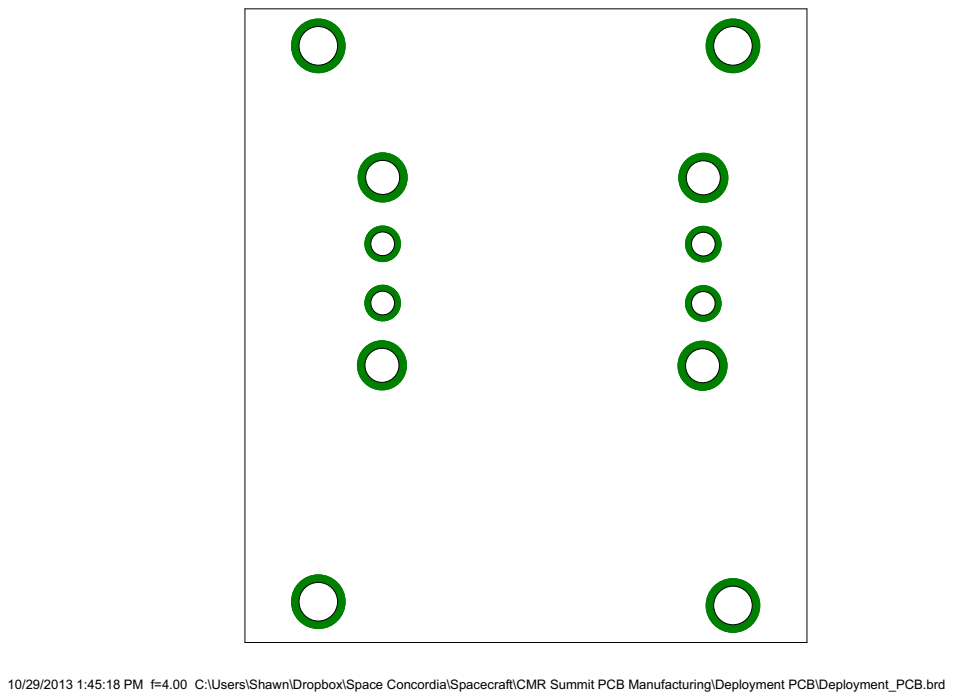
[picture p3: page 1]

10/29/2013 1:45:18 PM f=4.00 C:\Users\Shawn\Dropbox\Space Concordia\Spacecraft\CMR Summit PCB Manufacturing\Deployment PCB\Deployment_PCB.brd
