spaceconcordia/Consat1Electrical/EPS/eps-v1-1-schematic.pdf

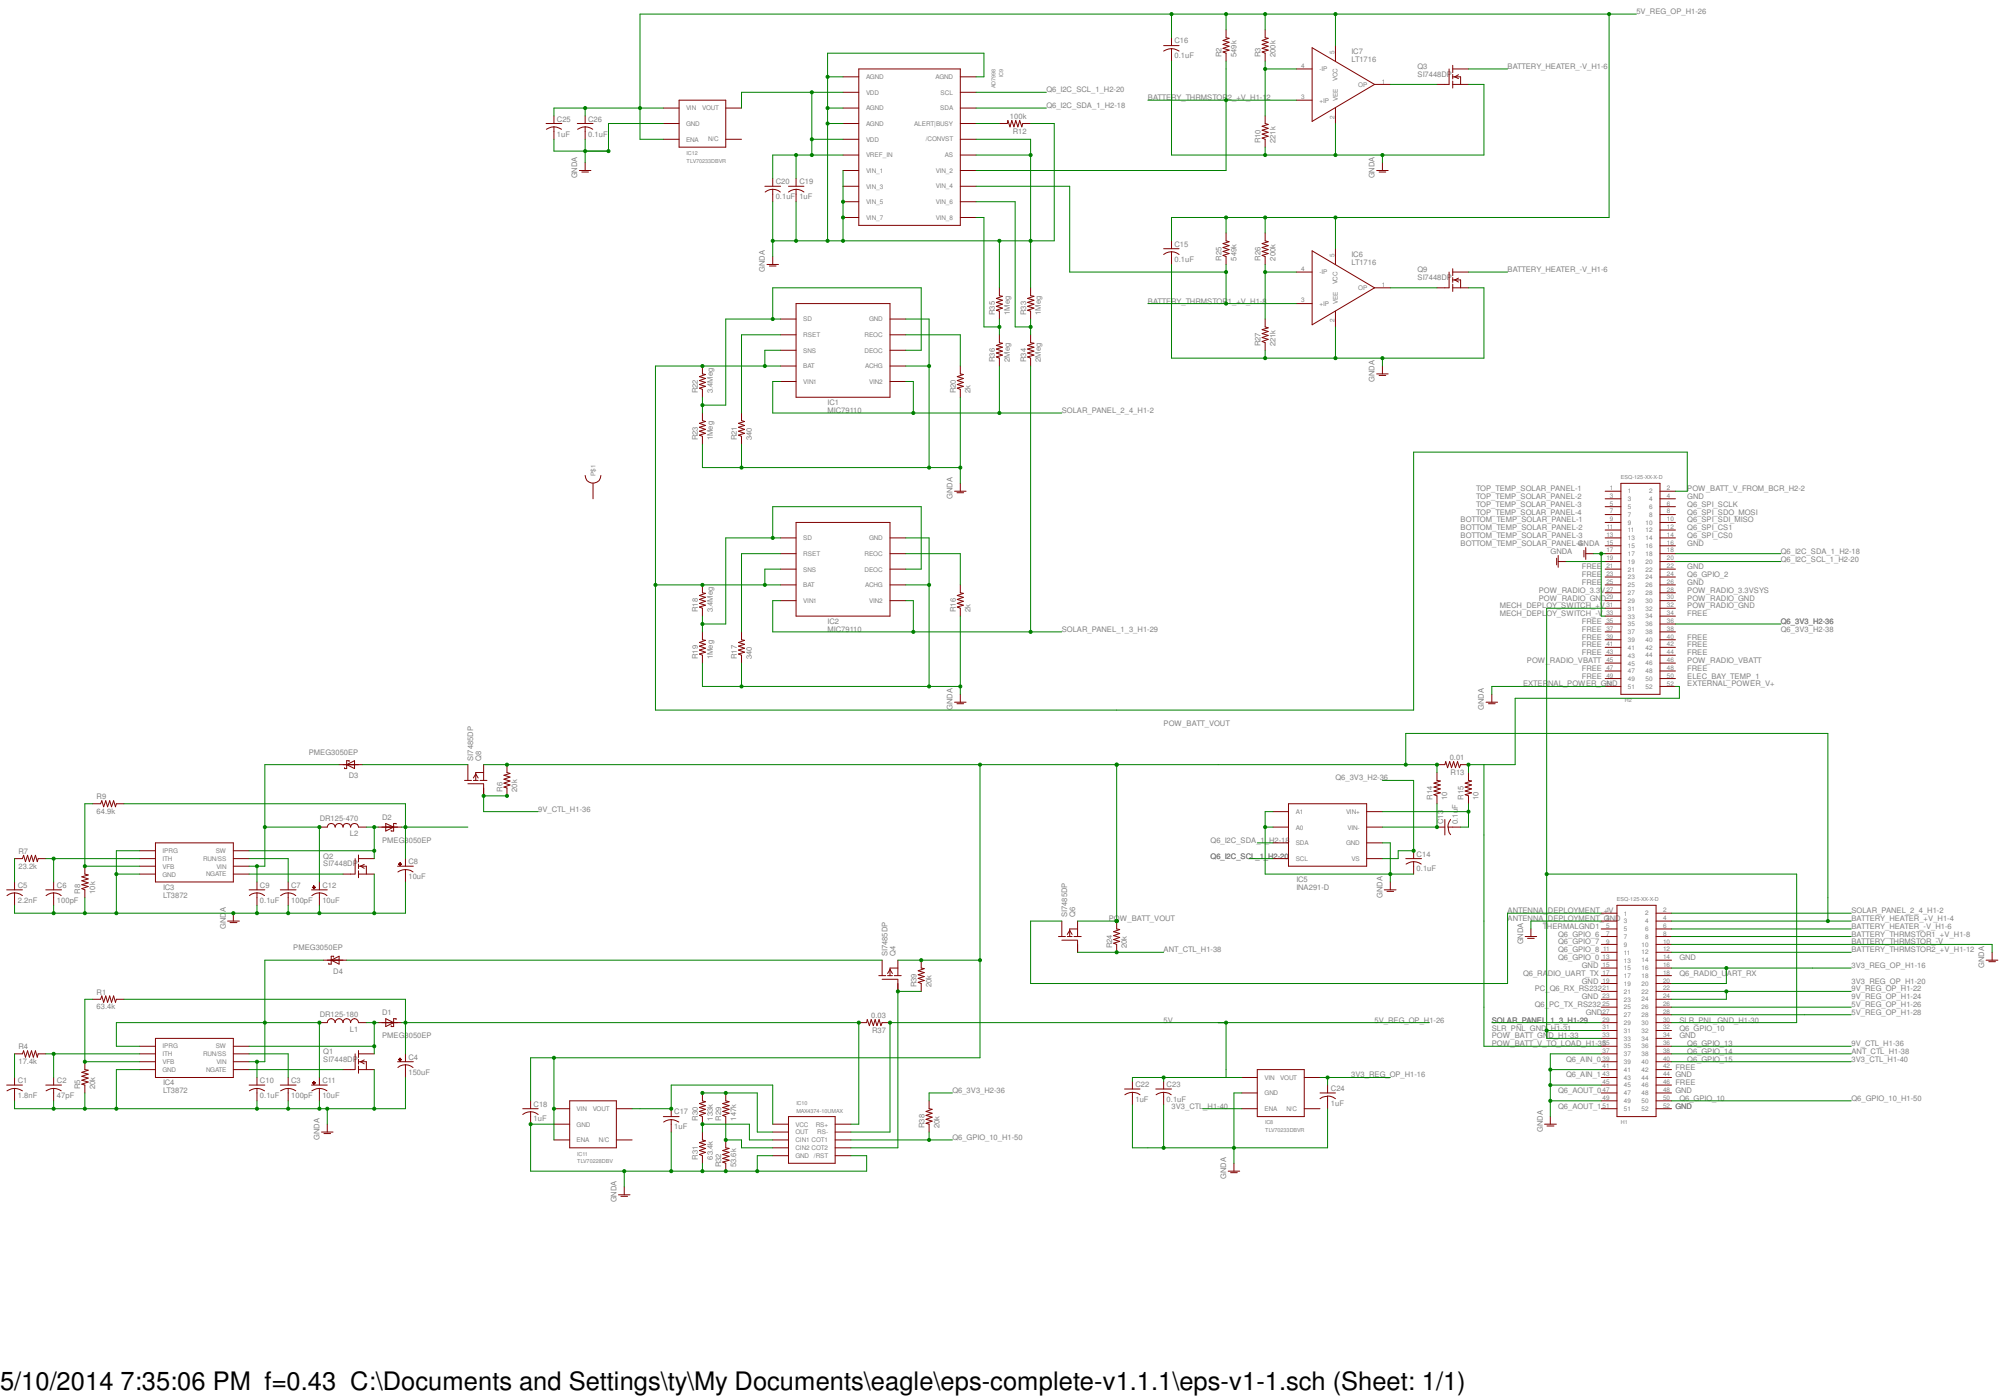
[picture p4: page 1]

5/10/2014 7:35:06 PM f=0.43 C:\Documents and Settings\ty\My Documents\eagle\eps-complete-v1.1.1\eps-v1-1.sch (Sheet: 1/1)
