spaceconcordia/Consat1Electrical/EPS/eps-v1-1-pcb.pdf

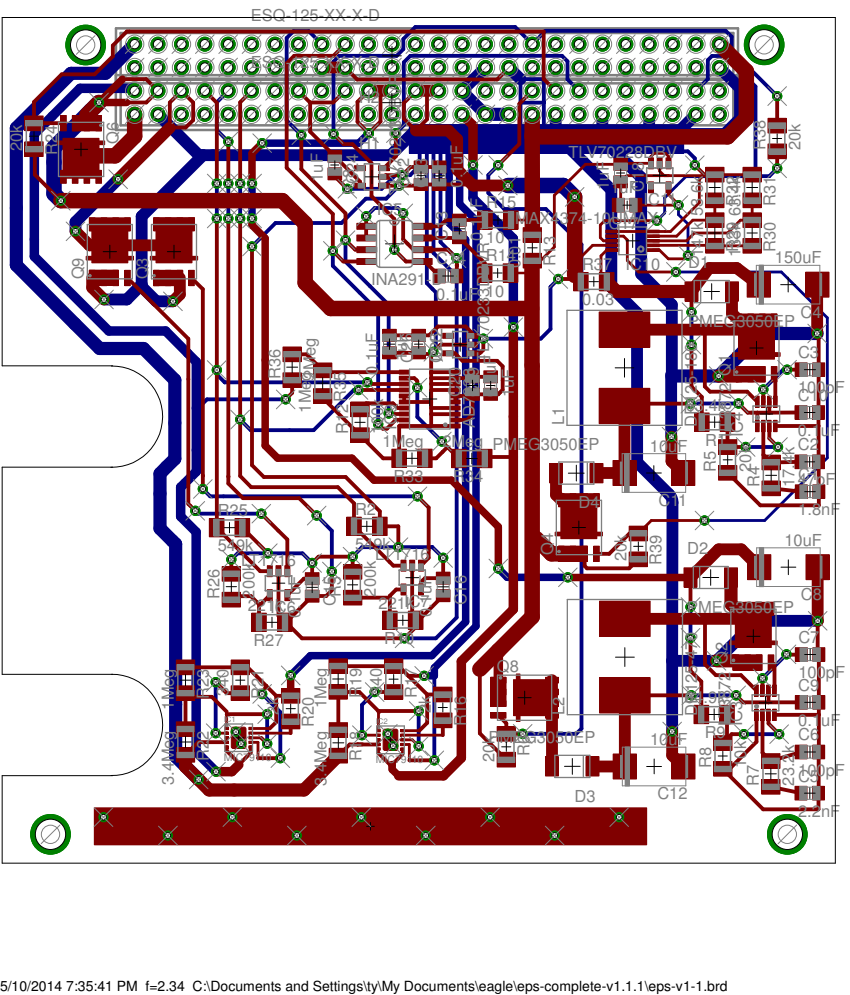
[picture p5: page 1]

5/10/2014 7:35:41 PM f=2.34 C:\Documents and Settings\ty\My Documents\eagle\eps-complete-v1.1.1\eps-v1-1.brd
