spaceconcordia/Consat1Electrical/CDH/CDH-v4.11-A-DS1338-tcc-test-redesign.brd

## EAGLE design CDH/CDH-v4.11-A-DS1338-tcc-test-redesign.brd (2015-09-28)

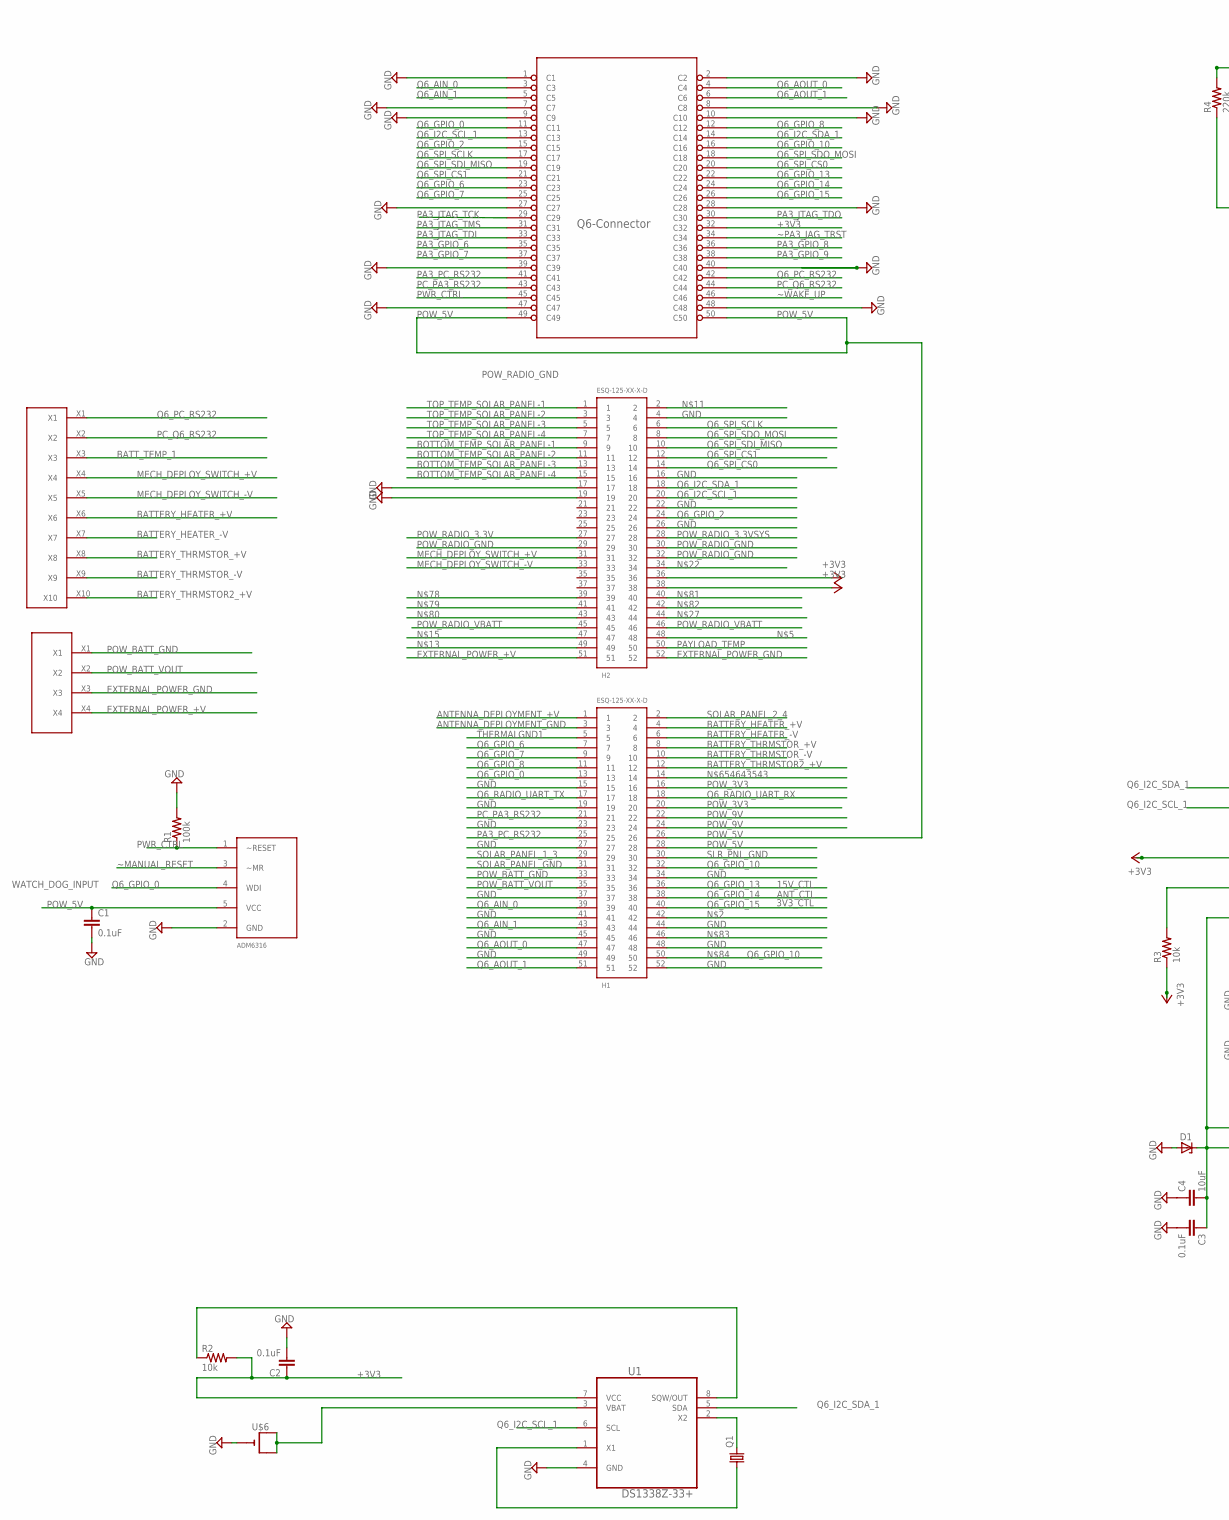
[picture p6: schematic CDH-v4.11-A-DS1338-tcc-test-redesign.sch, part in row 1, column 1]

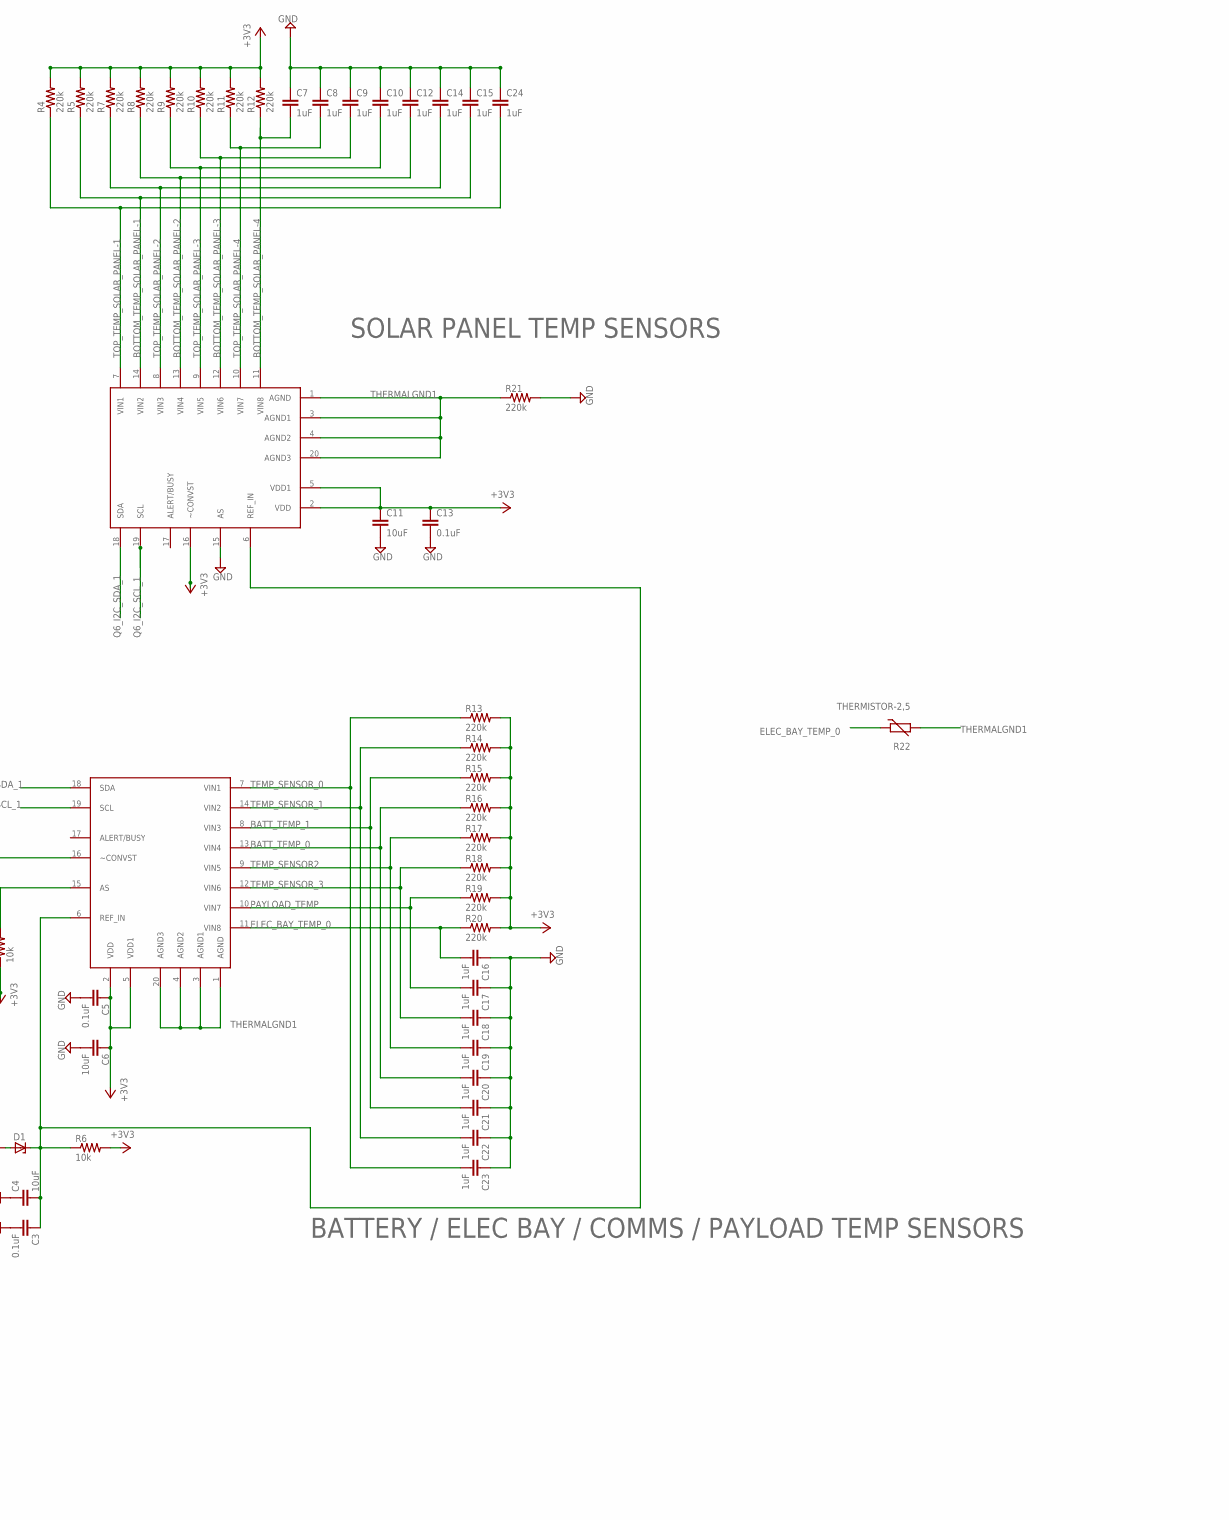
[picture p7: schematic CDH-v4.11-A-DS1338-tcc-test-redesign.sch, part in row 1, column 2]

Parts:
ADC_TEMP_1, ADC_TEMP_2: AD7998-1; TSSOP20
C1, C2, C3, C5, C13: 0.1uF; C2012
C4, C6, C11: 10uF; C2012
C7, C8, C9, C10, C12, C14, C15, C16, C17, C18, C19, C20, C21, C22, C23, C24: 1uF; C2012
D1: ZENER-DIODESOD80C; SOD80C
H1, H2: ESQ-125-XX-X-D
Q1: CRYSTALTC38H; TC38H
R1: 100k; R2012
R2, R3, R6: 10k; R2012
R4, R5, R7, R8, R9, R10, R11, R12, R13, R14, R15, R16, R17, R18, R19, R20, R21: 220k; R2012
R22: THERMISTOR-2,5; RS-2,5
U1: DS1338Z-33+; SOIC127P600X175-8N
U$1: M80-5000000M1-10-331-00-000; M80-5000000M1-04-331-00-000
U$2: M80-5000000M1-10-331-000; M80-5000000M1
U$3: ADM6316/ADM6320; SOT23-5
U$4: SMFC; SFMC-107-01-XX-D
U$6: CR1220SMT; CR1220-SMD

Connections:
+3V3: ADC_TEMP_1.2 (VDD), ADC_TEMP_1.5 (VDD1), ADC_TEMP_1.16 (~CONVST), ADC_TEMP_2.2 (VDD), ADC_TEMP_2.5 (VDD1), ADC_TEMP_2.16 (~CONVST), C2.1, C5.1, C6.1, C11.1, C13.1, H2.36, H2.38, R2.2, R3.1, R4.2, R5.2, R6.2, R7.2, R8.2, R9.2, R10.2, R11.2, R12.2, R13.2, R14.2, R15.2, R16.2, R17.2, R18.2, R19.2, R20.2, U1.7 (VCC), U$4.32 (C32)
ANTENNA_DEPLOYMENT_+V: H1.1
ANTENNA_DEPLOYMENT_GND: H1.3
BATTERY_HEATER_+V: H1.4, U$2.X6
BATTERY_HEATER_-V: H1.6, U$2.X7
BATTERY_THRMSTOR2_+V: H1.12, U$2.X10
BATTERY_THRMSTOR_+V: H1.8, U$2.X8
BATTERY_THRMSTOR_-V: H1.10, U$2.X9
BATT_TEMP_0: ADC_TEMP_1.13 (VIN4), C20.2, R16.1
BATT_TEMP_1: ADC_TEMP_1.8 (VIN3), C21.2, R15.1, U$2.X3
BOTTOM_TEMP_SOLAR_PANEL-1: ADC_TEMP_2.14 (VIN2), C15.2, H2.9, R5.1
BOTTOM_TEMP_SOLAR_PANEL-2: ADC_TEMP_2.13 (VIN4), C12.2, H2.11, R8.1
BOTTOM_TEMP_SOLAR_PANEL-3: ADC_TEMP_2.12 (VIN6), C9.2, H2.13, R10.1
BOTTOM_TEMP_SOLAR_PANEL-4: ADC_TEMP_2.11 (VIN8), C7.2, H2.15, R12.1
ELEC_BAY_TEMP_0: ADC_TEMP_1.11 (VIN8), C16.2, R20.1, R22.1
EXTERNAL_POWER_+V: H2.51, U$1.X4
EXTERNAL_POWER_GND: H2.52, U$1.X3
GND: ADC_TEMP_2.15 (AS), C1.2, C2.2, C3.2, C4.1, C5.2, C6.2, C7.1, C8.1, C9.1, C10.1, C11.2, C12.1, C13.2, C14.1, C15.1, C16.1, C17.1, C18.1, C19.1, C20.1, C21.1, C22.1, C23.1, C24.1, D1.A, H1.15, H1.19, H1.23, H1.27, H1.34, H1.37, H1.41, H1.44, H1.45, H1.48, H1.49, H1.52, H2.4, H2.16, H2.17, H2.19, H2.22, H2.26, R1.2, R21.2, U1.4 (GND), U$3.2 (GND), U$4.1 (C1), U$4.2 (C2), U$4.7 (C7), U$4.8 (C8), U$4.9 (C9), U$4.10 (C10), U$4.27 (C27), U$4.28 (C28), U$4.39 (C39), U$4.40 (C40), U$4.47 (C47), U$4.48 (C48), U$6.-
MECH_DEPLOY_SWITCH_+V: H2.31, U$2.X4
MECH_DEPLOY_SWITCH_-V: H2.33, U$2.X5
unnamed: ADC_TEMP_1.15 (AS), R3.2
unnamed: R2.1, U1.8 (SQW/OUT)
unnamed: U1.3 (VBAT), U$6.+$1 (+), U$6.+$2 (+1)
unnamed: Q1.1, U1.1 (X1)
unnamed: Q1.2, U1.2 (X2)
PA3_GPIO_6: U$4.35 (C35)
PA3_GPIO_7: U$4.37 (C37)
PA3_GPIO_8: U$4.36 (C36)
PA3_GPIO_9: U$4.38 (C38)
PA3_JTAG_TCK: U$4.29 (C29)
PA3_JTAG_TDI: U$4.33 (C33)
PA3_JTAG_TDO: U$4.30 (C30)
PA3_JTAG_TMS: U$4.31 (C31)
PA3_PC_RS232: H1.25, U$4.41 (C41)
PAYLOAD_TEMP: ADC_TEMP_1.10 (VIN7), C17.2, H2.50, R19.1
PC_PA3_RS232: H1.21, U$4.43 (C43)
PC_Q6_RS232: U$2.X2, U$4.44 (C44)
POW_3V3: H1.16, H1.20
POW_5V: C1.1, H1.26, H1.28, U$3.5 (VCC), U$4.49 (C49), U$4.50 (C50)
POW_9V: H1.22, H1.24
POW_BATT_GND: H1.33, U$1.X1
POW_BATT_VOUT: H1.35, U$1.X2
POW_RADIO_3.3V: H2.27
POW_RADIO_3.3VSYS: H2.28
POW_RADIO_GND: H2.29, H2.30, H2.32
POW_RADIO_VBATT: H2.45, H2.46
PWR_CTRL: R1.1, U$3.1 (~RESET), U$4.45 (C45)
Q6_AIN_0: H1.39, U$4.3 (C3)
Q6_AIN_1: H1.43, U$4.5 (C5)
Q6_AOUT_0: H1.47, U$4.4 (C4)
Q6_AOUT_1: H1.51, U$4.6 (C6)
Q6_GPIO_0: H1.13, U$3.4 (WDI), U$4.11 (C11)
Q6_GPIO_2: H2.24, U$4.15 (C15)
Q6_GPIO_6: H1.7, U$4.23 (C23)
Q6_GPIO_7: H1.9, U$4.25 (C25)
Q6_GPIO_8: H1.11, U$4.12 (C12)
Q6_GPIO_10: H1.32, U$4.16 (C16)
Q6_GPIO_13: H1.36, U$4.22 (C22)
Q6_GPIO_14: H1.38, U$4.24 (C24)
Q6_GPIO_15: H1.40, U$4.26 (C26)
Q6_I2C_SCL_1: ADC_TEMP_1.19 (SCL), ADC_TEMP_2.19 (SCL), H2.20, U1.6 (SCL), U$4.13 (C13)
Q6_I2C_SDA_1: ADC_TEMP_1.18 (SDA), ADC_TEMP_2.18 (SDA), H2.18, U1.5 (SDA), U$4.14 (C14)
Q6_PC_RS232: U$2.X1, U$4.42 (C42)
Q6_RADIO_UART_RX: H1.18
Q6_RADIO_UART_TX: H1.17
Q6_SPI_CS0: H2.14, U$4.20 (C20)
Q6_SPI_CS1: H2.12, U$4.21 (C21)
Q6_SPI_SCLK: H2.6, U$4.17 (C17)
Q6_SPI_SDI_MISO: H2.10, U$4.19 (C19)
Q6_SPI_SDO_MOSI: H2.8, U$4.18 (C18)
REF_IN: ADC_TEMP_1.6 (REF_IN), ADC_TEMP_2.6 (REF_IN), C3.1, C4.2, D1.C, R6.1
SLR_PNL_GND: H1.30
SOLAR_PANEL_1_3: H1.29
SOLAR_PANEL_2_4: H1.2
SOLAR_PANEL_GND: H1.31
TEMP_SENSOR2: ADC_TEMP_1.9 (VIN5), C19.2, R17.1
TEMP_SENSOR_0: ADC_TEMP_1.7 (VIN1), C23.2, R13.1
TEMP_SENSOR_1: ADC_TEMP_1.14 (VIN2), C22.2, R14.1
TEMP_SENSOR_3: ADC_TEMP_1.12 (VIN6), C18.2, R18.1
THERMALGND1: ADC_TEMP_1.1 (AGND), ADC_TEMP_1.3 (AGND1), ADC_TEMP_1.4 (AGND2), ADC_TEMP_1.20 (AGND3), ADC_TEMP_2.1 (AGND), ADC_TEMP_2.3 (AGND1), ADC_TEMP_2.4 (AGND2), ADC_TEMP_2.20 (AGND3), H1.5, R21.1, R22.2
TOP_TEMP_SOLAR_PANEL-1: ADC_TEMP_2.7 (VIN1), C24.2, H2.1, R4.1
TOP_TEMP_SOLAR_PANEL-2: ADC_TEMP_2.8 (VIN3), C14.2, H2.3, R7.1
TOP_TEMP_SOLAR_PANEL-3: ADC_TEMP_2.9 (VIN5), C10.2, H2.5, R9.1
TOP_TEMP_SOLAR_PANEL-4: ADC_TEMP_2.10 (VIN7), C8.2, H2.7, R11.1
~MANUAL_RESET: U$3.3 (~MR)
~PA3_JAG_TRST: U$4.34 (C34)
~WAKE_UP: U$4.46 (C46)

Notes on the sheet:
POW_RADIO_GND
Q6_AOUT_0
Q6_AOUT_1
SOLAR PANEL TEMP SENSORS
BATTERY / ELEC BAY / COMMS / PAYLOAD TEMP SENSORS
Q6-Connector
15V_CTL
ANT_CTL
SOLAR_PANEL_2_4
3V3_CTL
Q6_GPIO_10
WATCH_DOG_INPUT

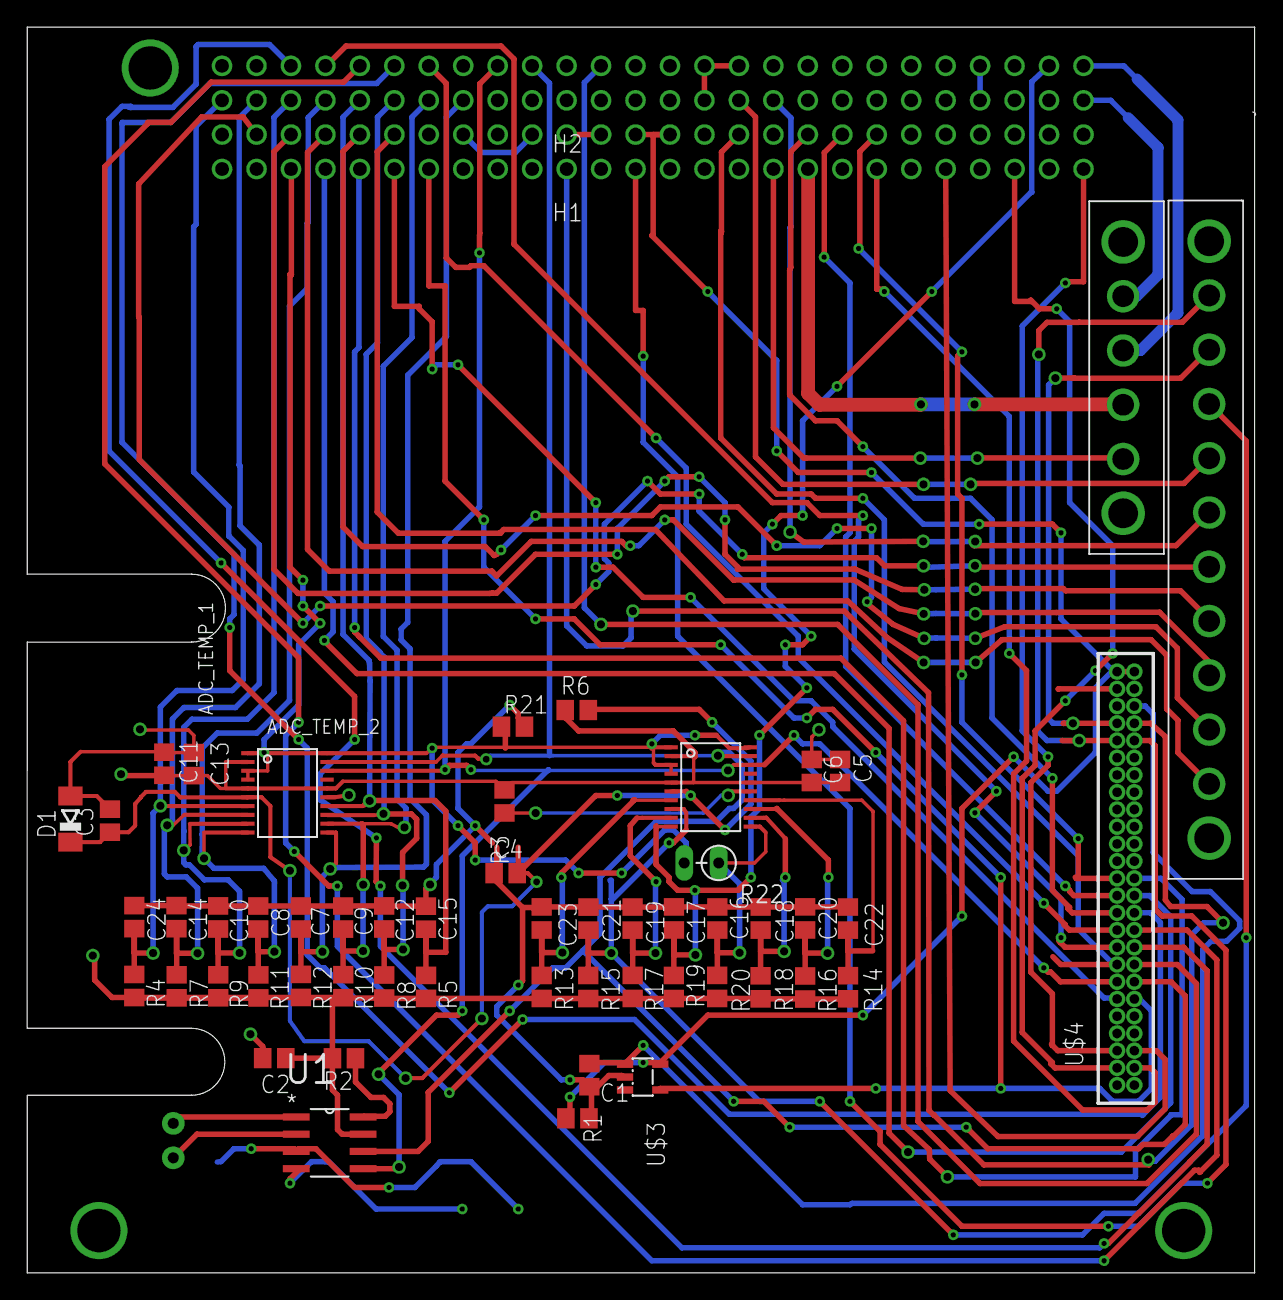
[picture p8: board CDH-v4.11-A-DS1338-tcc-test-redesign.brd from above]

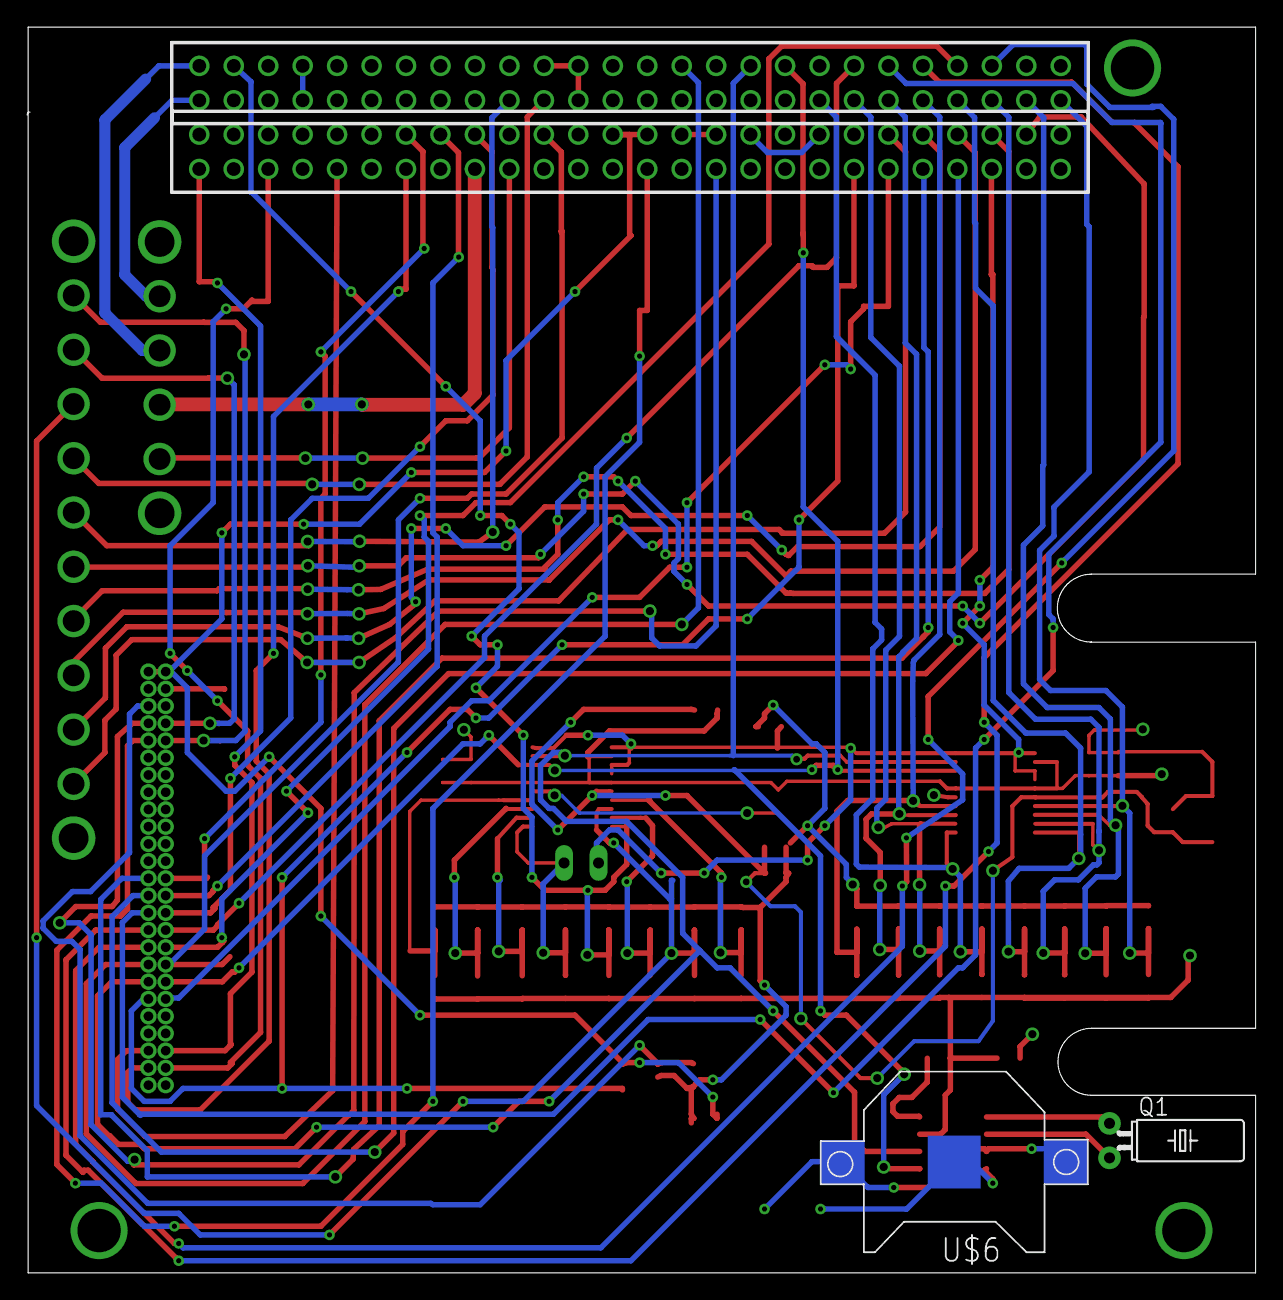
[picture p9: board CDH-v4.11-A-DS1338-tcc-test-redesign.brd from below]

Board: 4 copper layers, 90.5 x 91.8 mm, 58 parts (2 on the bottom side), 66 nets.
