spaceconcordia/Consat1Electrical/EPS/eps-v1-1.brd

## EAGLE design EPS/eps-v1-1.brd (2015-09-04)

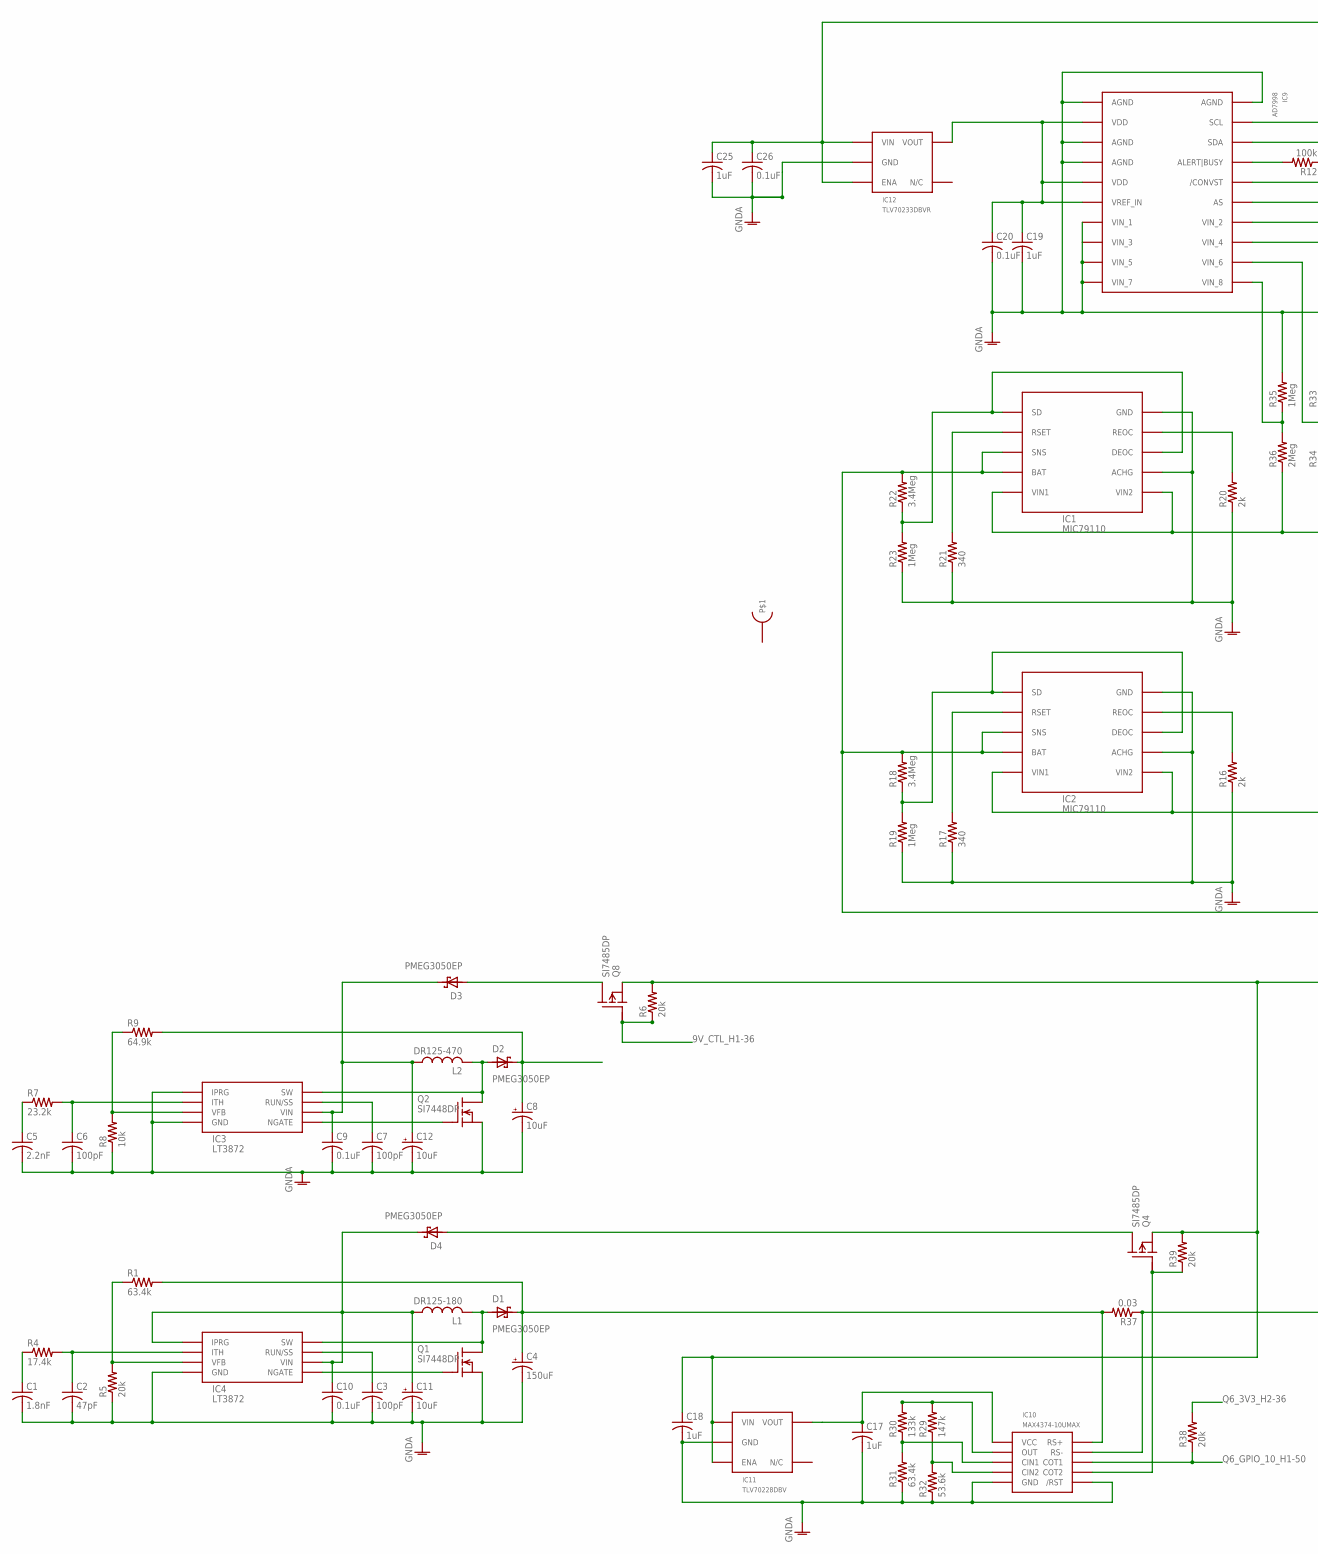
[picture p13: schematic eps-v1-1.sch, part in row 1, column 1]

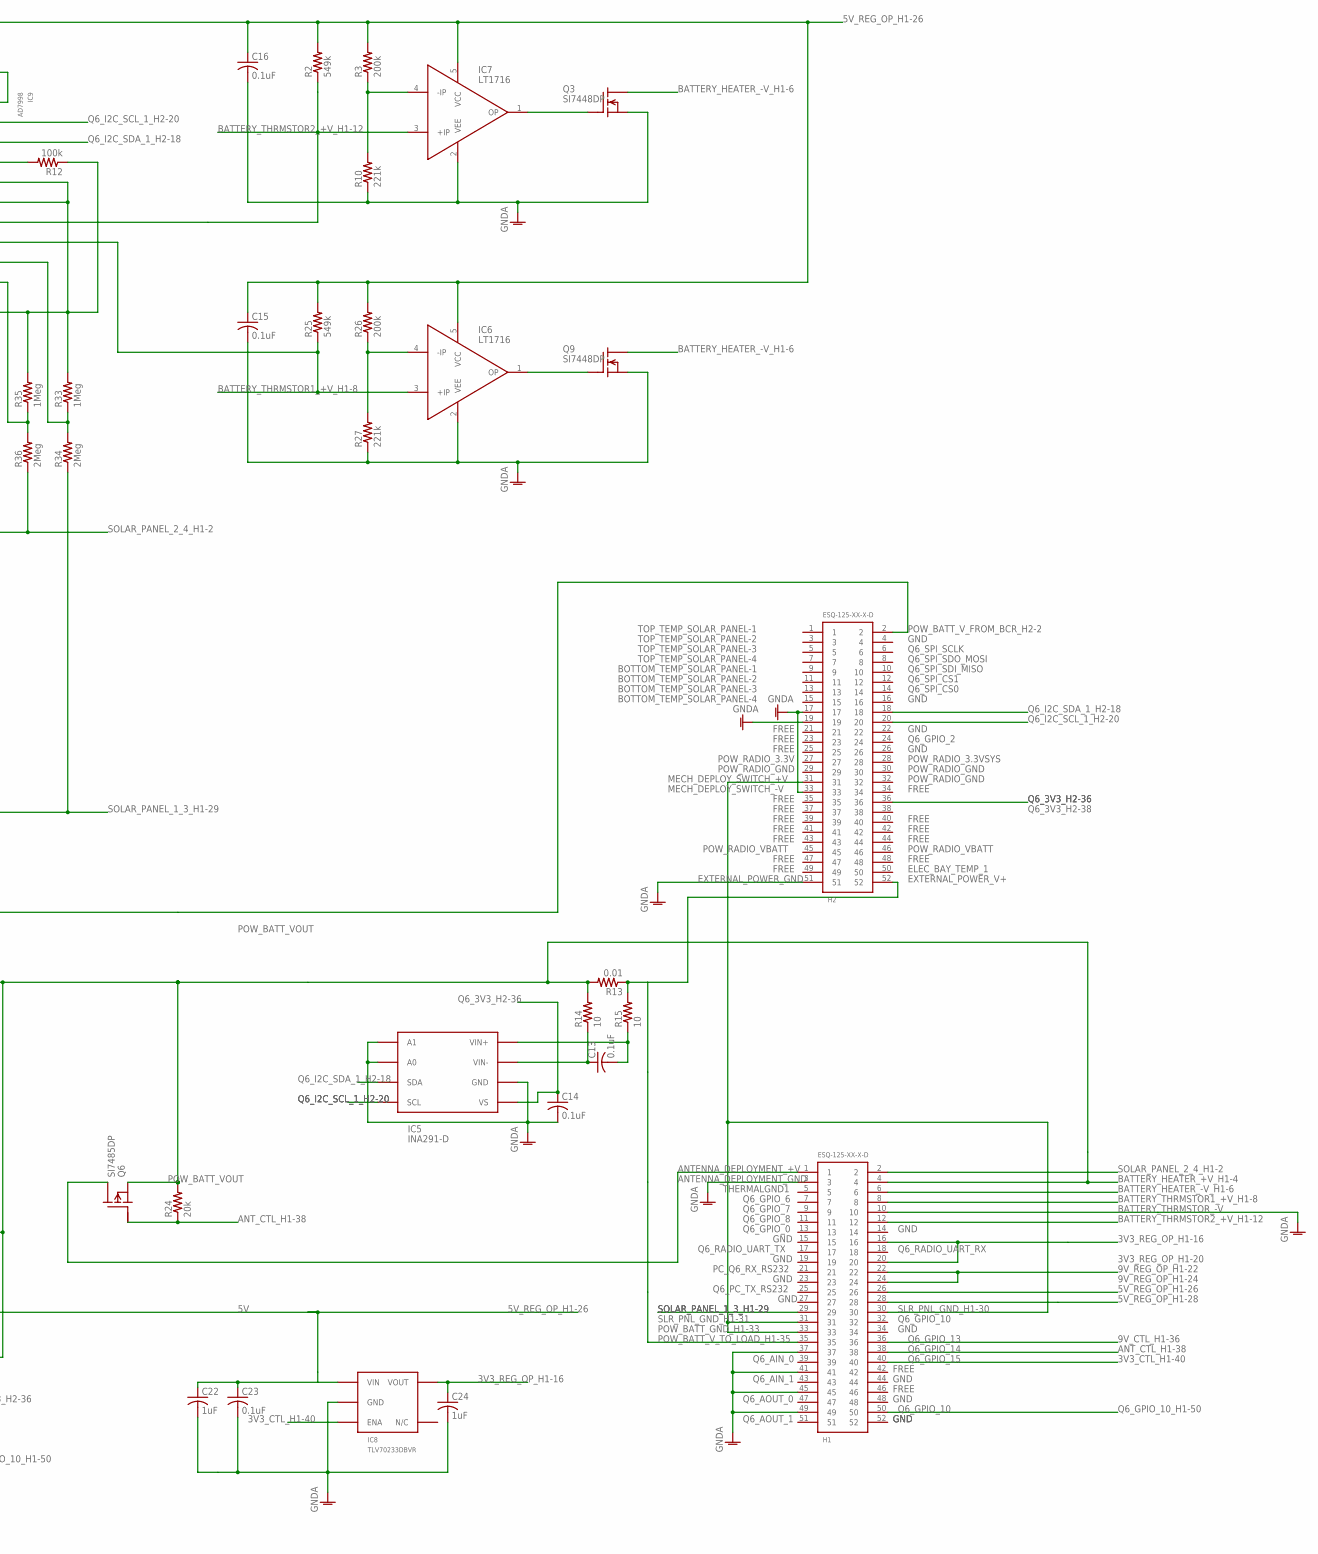
[picture p14: schematic eps-v1-1.sch, part in row 1, column 2]

Parts:
C1: 1.8nF; C0805
C2: 47pF; C0805
C3, C6, C7: 100pF; C0805
C4: 150uF; D/7343-31R
C5: 2.2nF; C0805
C8, C11, C12: 10uF; D/7343-31R
C9, C10, C13, C14, C15, C16, C20, C23, C26: 0.1uF; C0805
C17, C18, C19, C22, C24, C25: 1uF; C0805
D1, D2, D3, D4: PMEG3050EP; SOD128
H1, H2: ESQ-125-XX-X-D
IC1, IC2: MIC79110; MLF10-EP
IC3, IC4: LT3872; TSOT23-8
IC5: INA291-D; SO08
IC6, IC7: LT1716; SOT23-5
IC8, IC12: TLV70233DBVR; SOT23-5
IC9: AD7998; TSSOP-20
IC10: MAX4374-10UMAX; 10UMAX
IC11: TLV70228DBV; SOT23-5
L1: DR125-180; DR125
L2: DR125-470; DR125
Q1, Q2, Q3, Q9: SI7448DP; PPAK-SO08-EP
Q4, Q6, Q8: SI7485DP; PPAK-SO08-EP
R1, R31: 63.4k; M1206
R2, R25: 549k; M1206
R3, R26: 200k; M1206
R4: 17.4k; M1206
R5, R6, R24, R38, R39: 20k; M1206
R7: 23.2k; M1206
R8: 10k; M1206
R9: 64.9k; M1206
R10, R27: 221k; M1206
R12: 100k; M1206
R13: 0.01; M1206
R14, R15: 10; M1206
R16, R20: 2k; M1206
R17, R21: 340; M1206
R18, R22: 3.4Meg; M1206
R19, R23, R33, R35: 1Meg; M1206
R29: 147k; M1206
R30: 133k; M1206
R32: 53.6k; M1206
R34, R36: 2Meg; M1206
R37: 0.03; M1206
U$1: EPS_PCB_THRM_PAD

Connections:
3V3_CTL_H1-40: H1.40, IC8.3 (ENA)
3V3_REG_OP_H1-16: C24.1, H1.16, H1.20, IC8.5 (VOUT)
5V_REG_OP_H1-26: C15.1, C16.1, C22.1, C23.1, C25.1, C26.1, H1.26, H1.28, IC6.5 (VCC), IC7.5 (VCC), IC8.1 (VIN), IC10.P$9 (RS-), IC12.1 (VIN), IC12.3 (ENA), R2.2, R3.2, R25.2, R26.2, R37.1
9V_CTL_H1-36: H1.36, Q8.P$4-G (G), R6.1
9V_REG_OP_H1-22: C8.+, D2.P$1-CATHODE, H1.22, H1.24, R9.2
ANT_CTL_H1-38: H1.38, Q6.P$4-G (G), R24.1
BATTERY_HEATER_-V_H1-6: H1.6, Q3.P$5-D (D), Q3.P$6-D (D), Q3.P$7-D (D), Q3.P$8-D (D), Q3.P$9-D (D), Q3.P$10-D (D), Q3.P$11-D (D), Q9.P$5-D (D), Q9.P$6-D (D), Q9.P$7-D (D), Q9.P$8-D (D), Q9.P$9-D (D), Q9.P$10-D (D), Q9.P$11-D (D)
BATTERY_THRMSTOR1_+V_H1-8: H1.8, IC6.3 (+IP), IC9.P$13 (VIN_4), R25.1
BATTERY_THRMSTOR2_+V_H1-12: H1.12, IC7.3 (+IP), IC9.P$14 (VIN_2), R2.1
GNDA: C1.2, C2.2, C3.2, C4.-, C5.2, C6.2, C7.2, C8.-, C9.2, C10.2, C11.-, C12.-, C14.2, C15.2, C16.2, C17.2, C18.2, C19.2, C20.2, C22.2, C23.2, C24.2, C25.2, C26.2, H1.3, H1.10, H1.37, H1.41, H1.45, H1.49, H2.17, H2.19, H2.33, H2.51, IC1.P$7 (ACHG), IC1.P$10 (GND), IC2.P$7 (ACHG), IC2.P$10 (GND), IC3.P$1 (IPRG), IC3.P$4 (GND), IC4.P$4 (GND), IC5.1 (A1), IC5.2 (A0), IC5.6 (GND), IC6.2 (VEE), IC7.2 (VEE), IC8.2 (GND), IC9.P$1 (AGND), IC9.P$3 (AGND), IC9.P$4 (AGND), IC9.P$7 (VIN_1), IC9.P$8 (VIN_3), IC9.P$9 (VIN_5), IC9.P$10 (VIN_7), IC9.P$15 (AS), IC9.P$16 (/CONVST), IC9.P$20 (AGND), IC10.P$5 (GND), IC10.P$6 (/RST), IC11.2 (GND), IC12.2 (GND), Q1.P$1-S (S), Q1.P$2-S (S), Q1.P$3-S (S), Q2.P$1-S (S), Q2.P$2-S (S), Q2.P$3-S (S), Q3.P$1-S (S), Q3.P$2-S (S), Q3.P$3-S (S), Q9.P$1-S (S), Q9.P$2-S (S), Q9.P$3-S (S), R5.1, R8.1, R10.1, R12.1, R16.1, R17.1, R19.1, R20.1, R21.1, R23.1, R27.1, R31.1, R32.1, R33.2, R35.2
unnamed: IC4.P$5 (NGATE), Q1.P$4-G (G)
unnamed: H2.2, IC1.P$3 (SNS), IC1.P$4 (BAT), IC2.P$3 (SNS), IC2.P$4 (BAT), R18.2, R22.2
unnamed: C10.1, C11.+, D4.P$1-CATHODE, IC4.P$1 (IPRG), IC4.P$6 (VIN), L1.P$1 (1)
unnamed: IC4.P$3 (VFB), R1.1, R5.2
unnamed: C1.1, R4.1
unnamed: C2.1, IC4.P$2 (ITH), R4.2
unnamed: D1.P$2-ANODE, IC4.P$8 (SW), L1.P$2 (2), Q1.P$5-D (D), Q1.P$6-D (D), Q1.P$7-D (D), Q1.P$8-D (D), Q1.P$9-D (D), Q1.P$10-D (D), Q1.P$11-D (D)
unnamed: H1.1, Q6.P$5-D (D), Q6.P$6-D (D), Q6.P$7-D (D), Q6.P$8-D (D), Q6.P$9-D (D), Q6.P$10-D (D), Q6.P$11-D (D)
unnamed: D2.P$2-ANODE, IC3.P$8 (SW), L2.P$2 (2), Q2.P$5-D (D), Q2.P$6-D (D), Q2.P$7-D (D), Q2.P$8-D (D), Q2.P$9-D (D), Q2.P$10-D (D), Q2.P$11-D (D)
unnamed: IC3.P$5 (NGATE), Q2.P$4-G (G)
unnamed: C7.1, IC3.P$7 (RUN/SS)
unnamed: C19.1, C20.1, IC9.P$2 (VDD), IC9.P$5 (VDD), IC9.P$6 (VREF_IN), IC12.5 (VOUT)
unnamed: IC3.P$3 (VFB), R8.2, R9.1
unnamed: C5.1, R7.1
unnamed: C6.1, IC3.P$2 (ITH), R7.2
unnamed: H1.30, H1.31, H1.33, H2.31
unnamed: C9.1, C12.+, D3.P$1-CATHODE, IC3.P$6 (VIN), L2.P$1 (1)
unnamed: IC9.P$11 (VIN_8), R35.1, R36.2
unnamed: IC2.P$2 (RSET), R17.2
unnamed: D3.P$2-ANODE, Q8.P$5-D (D), Q8.P$6-D (D), Q8.P$7-D (D), Q8.P$8-D (D), Q8.P$9-D (D), Q8.P$10-D (D), Q8.P$11-D (D)
unnamed: IC2.P$1 (SD), IC2.P$8 (DEOC), R18.1, R19.2
unnamed: IC2.P$9 (REOC), R16.2
unnamed: IC1.P$2 (RSET), R21.2
unnamed: C4.+, D1.P$1-CATHODE, IC10.P$10 (RS+), R1.2, R37.2
unnamed: IC1.P$1 (SD), IC1.P$8 (DEOC), R22.1, R23.2
unnamed: IC1.P$9 (REOC), R20.2
unnamed: IC7.1 (OP), Q3.P$4-G (G)
unnamed: IC7.4 (-IP), R3.1, R10.2
unnamed: IC9.P$12 (VIN_6), R33.1, R34.2
unnamed: C13.2, IC5.8 (VIN+), R15.1
unnamed: D4.P$2-ANODE, Q4.P$5-D (D), Q4.P$6-D (D), Q4.P$7-D (D), Q4.P$8-D (D), Q4.P$9-D (D), Q4.P$10-D (D), Q4.P$11-D (D)
unnamed: C13.1, IC5.7 (VIN-), R14.1
unnamed: C18.1, H1.4, IC11.1 (VIN), IC11.3 (ENA), Q4.P$1-S (S), Q4.P$2-S (S), Q4.P$3-S (S), Q6.P$1-S (S), Q6.P$2-S (S), Q6.P$3-S (S), Q8.P$1-S (S), Q8.P$2-S (S), Q8.P$3-S (S), R6.2, R13.2, R14.2, R24.2, R39.2
unnamed: IC6.1 (OP), Q9.P$4-G (G)
unnamed: H1.35, H2.52, R13.1, R15.2
unnamed: C17.1, IC10.P$1 (VCC), IC11.5 (VOUT)
unnamed: IC9.P$17 (ALERT|BUSY), R12.2
unnamed: IC10.P$2 (OUT), R29.2, R30.2
unnamed: IC6.4 (-IP), R26.1, R27.2
unnamed: IC10.P$4 (CIN2), R29.1, R32.2
unnamed: IC10.P$3 (CIN1), R30.1, R31.2
unnamed: C3.1, IC4.P$7 (RUN/SS)
unnamed: IC10.P$7 (COT2), Q4.P$4-G (G), R39.1
Q6_3V3_H2-36: C14.1, H2.36, IC5.5 (VS), R38.2
Q6_GPIO_10_H1-50: H1.50, IC10.P$8 (COT1), R38.1
Q6_I2C_SCL_1_H2-20: H2.20, IC5.4 (SCL), IC9.P$19 (SCL)
Q6_I2C_SDA_1_H2-18: H2.18, IC5.3 (SDA), IC9.P$18 (SDA)
SOLAR_PANEL_1_3_H1-29: H1.29, IC2.P$5 (VIN1), IC2.P$6 (VIN2), R34.1
SOLAR_PANEL_2_4_H1-2: H1.2, IC1.P$5 (VIN1), IC1.P$6 (VIN2), R36.1

Notes on the sheet:
Q6_AIN_0
Q6_AIN_1
Q6_AOUT_0
Q6_AOUT_1
POW_RADIO_3.3V
POW_RADIO_GND
POW_RADIO_VBATT
Q6_RADIO_UART_TX
Q6_RADIO_UART_RX
Q6_SPI_SCLK
Q6_SPI_SDO_MOSI
Q6_SPI_SDI_MISO
Q6_I2C_SDA_1_H2-18
Q6_SPI_CS1
GND
ELEC_BAY_TEMP_1
Q6_SPI_CS0
BOTTOM_TEMP_SOLAR_PANEL-1
BOTTOM_TEMP_SOLAR_PANEL-2
BOTTOM_TEMP_SOLAR_PANEL-3
BOTTOM_TEMP_SOLAR_PANEL-4
MECH_DEPLOY_SWITCH_-V
MECH_DEPLOY_SWITCH_+V
TOP_TEMP_SOLAR_PANEL-4
TOP_TEMP_SOLAR_PANEL-3
TOP_TEMP_SOLAR_PANEL-2
TOP_TEMP_SOLAR_PANEL-1
POW_BATT_V_TO_LOAD_H1-35
POW_BATT_GND_H1-33
Q6_GPIO_14
Q6_GPIO_15
Q6_GPIO_13
Q6_GPIO_2
EXTERNAL_POWER_V+
EXTERNAL_POWER_GND
ANTENNA_DEPLOYMENT_+V
ANTENNA_DEPLOYMENT_GND
SOLAR_PANEL_2_4_H1-2
SOLAR_PANEL_1_3_H1-29
3V3_REG_OP_H1-16
3V3_REG_OP_H1-20
5V_REG_OP_H1-28
5V_REG_OP_H1-26
9V_REG_OP_H1-22
9V_REG_OP_H1-24
3V3_CTL_H1-40
ANT_CTL_H1-38
9V_CTL_H1-36
POW_BATT_VOUT
POW_RADIO_3.3VSYS
Q6_3V3_H2-36
Q6_3V3_H2-38
BATTERY_HEATER_+V_H1-4
BATTERY_HEATER_-V_H1-6
BATTERY_THRMSTOR1_+V_H1-8
BATTERY_THRMSTOR_-V
SLR_PNL_GND_H1-30
SLR_PNL_GND_H1-31
BATTERY_THRMSTOR2_+V_H1-12
Q6_GPIO_10
Q6_GPIO_10_H1-50
PC_Q6_RX_RS232
Q6_PC_TX_RS232
THERMALGND1
Q6_GPIO_6
Q6_GPIO_7
Q6_GPIO_8
Q6_GPIO_0
FREE
Q6_I2C_SCL_1_H2-20
POW_BATT_V_FROM_BCR_H2-2

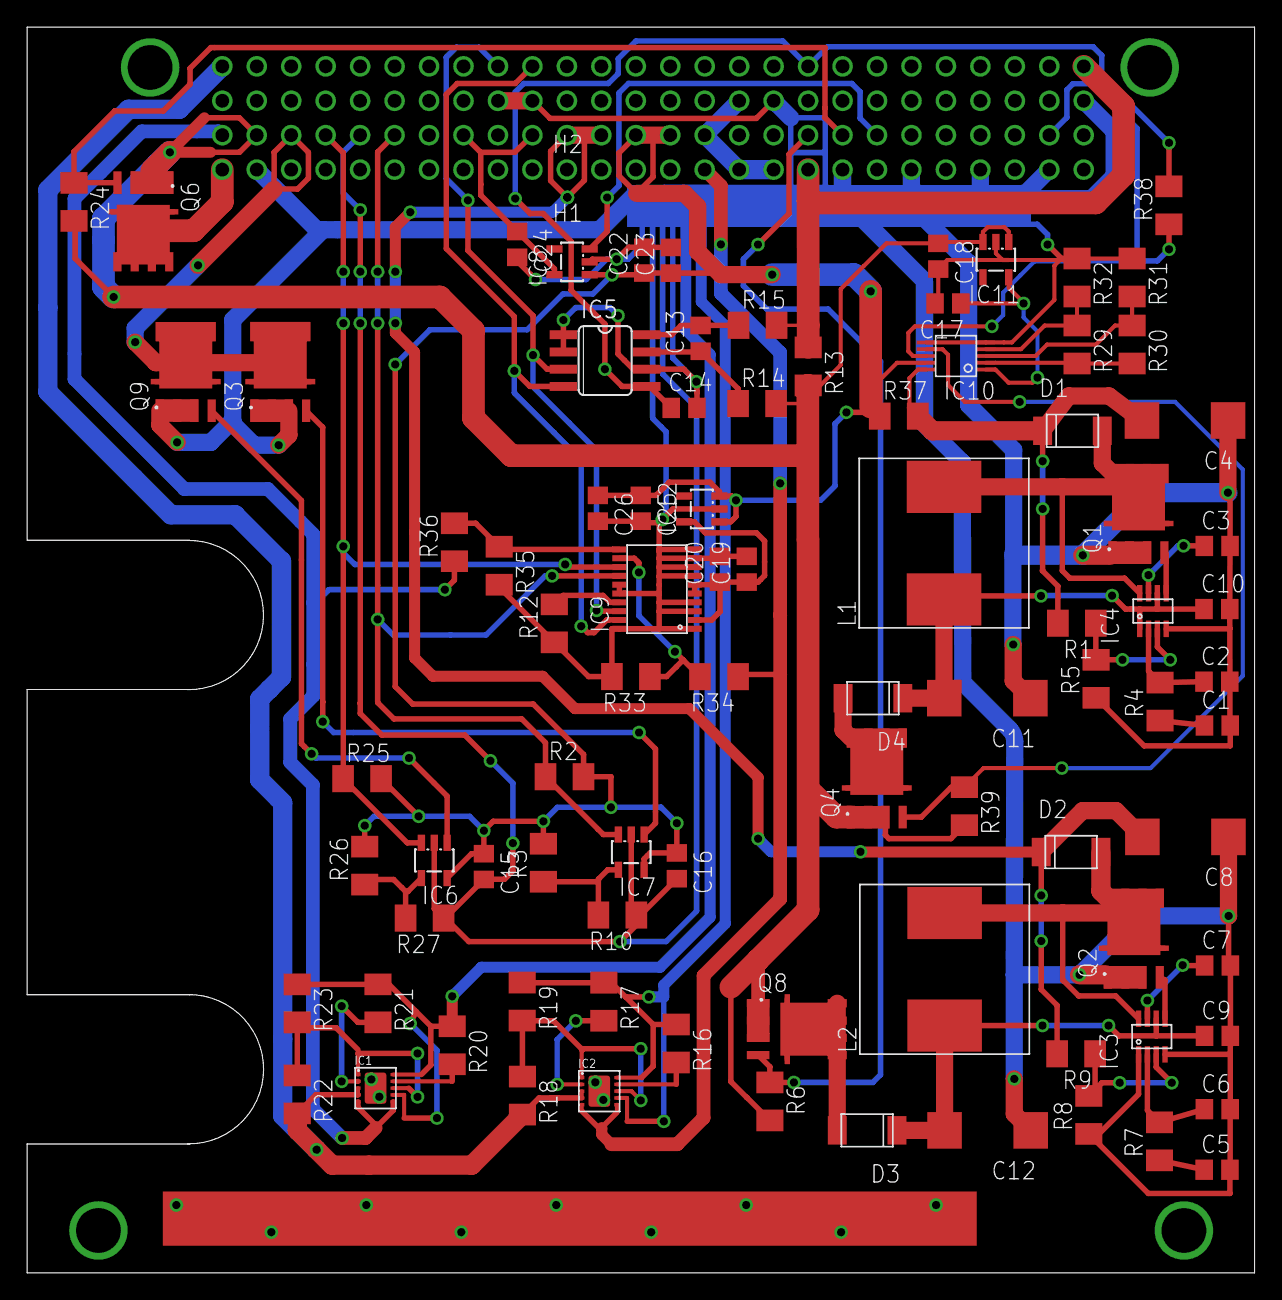
[picture p15: board eps-v1-1.brd from above]

Board: 4 copper layers, 90.5 x 91.8 mm, 90 parts (0 on the bottom side), 59 nets.
