spaceconcordia/Consat1Electrical/Payload External/payload-externalPCB-version2-modif2.brd

## EAGLE design Payload External/payload-externalPCB-version2-modif2.brd (2015-08-14)

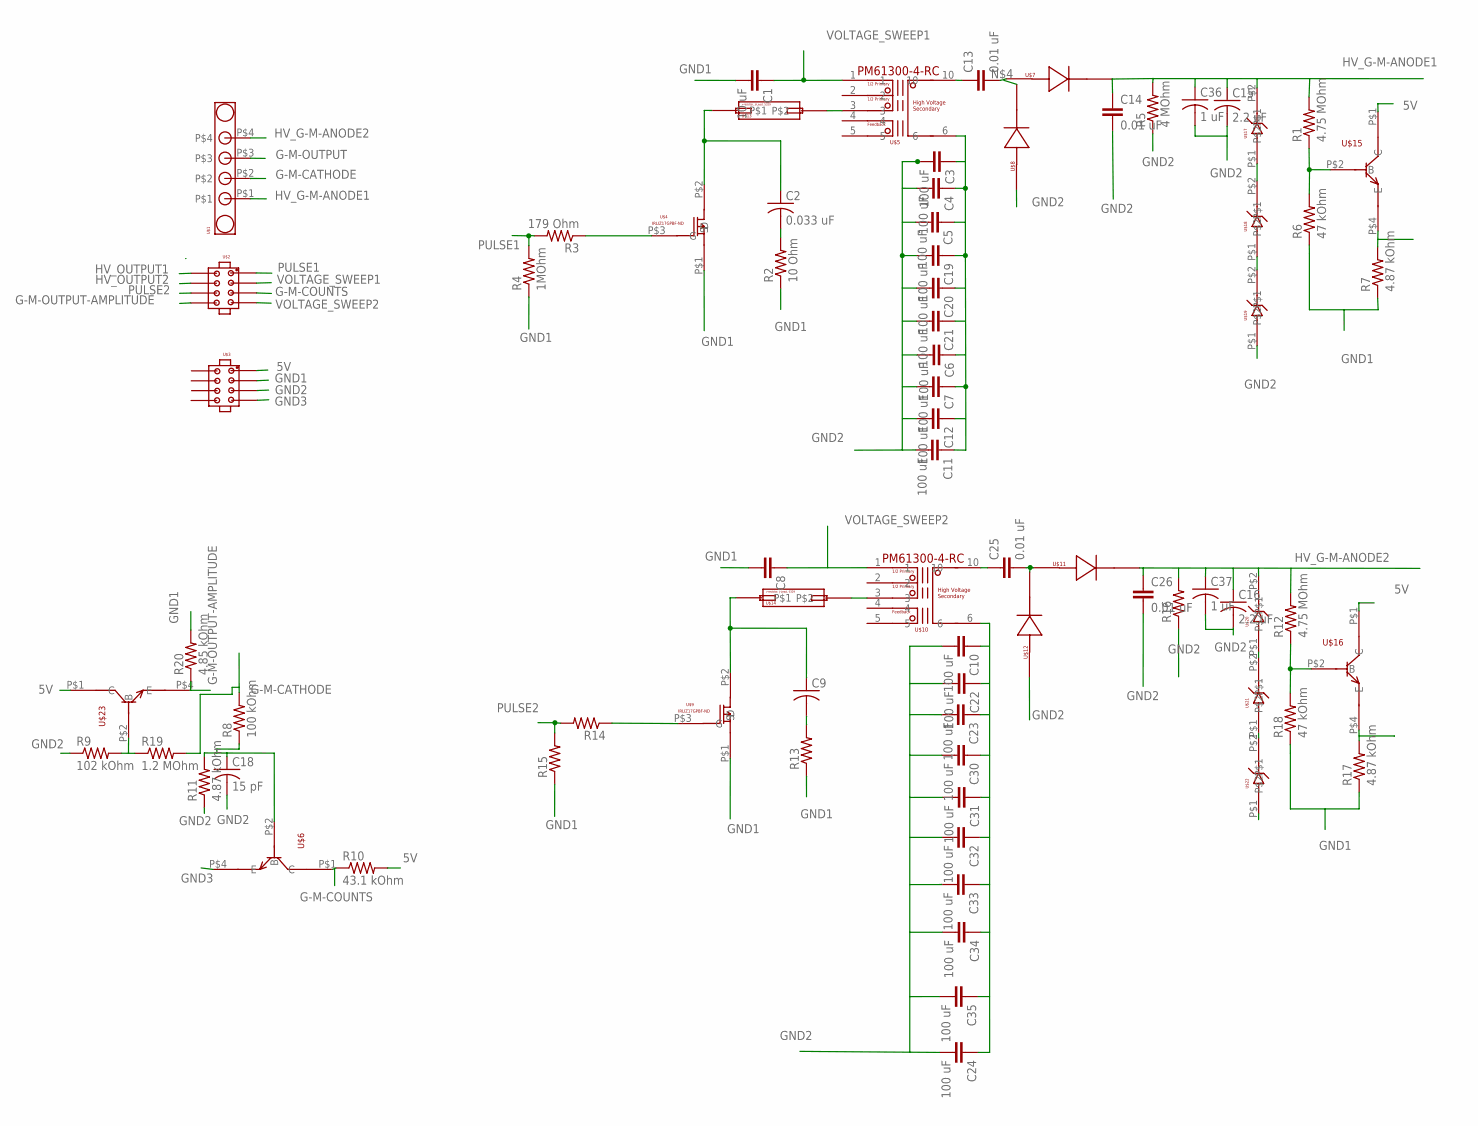
[picture p16: schematic payload-externalPCB-version2-modif2.sch]

Parts:
C1: 10 uF; C1210
C2: 0.033 uF; C0805
C3, C4, C5, C6, C7, C10, C11, C12, C19, C20, C21, C22, C23, C24, C30, C31, C32, C33, C34, C35: 100 uF; C1210
C8: C-EUC1210; C1210
C9: C-USC0805; C0805
C13, C14, C25, C26: 0.01 uF; C1206
C15, C16: 2.2 uF; C2220K
C18: 15 pF; C0805
C36, C37: 1 uF; C2220K
R1, R12: 4.75 MOhm; R1206
R2: 10 Ohm; R2010
R3: 179 Ohm; R2010
R4: 1MOhm; R2010
R5: 4 MOhm; R2010
R6, R18: 47 kOhm; R1210
R7, R17: 4.87 kOhm; R2010
R8: 100 kOhm; R2010
R9: 102 kOhm; R1206
R10: 43.1 kOhm; R2010
R11: 4.87 kOhm; R1210
R13, R14, R15, R16: R-US_R2010; R2010
R19: 1.2 MOhm; R1206
R20: 4.85 kOhm; R2010
U$1: M80-5000000M2-04-331-00-000
U$2, U$3: M80-8670805
U$4, U$9: IRLIZ14GPBF-ND-SCHEMATICS; TO-220FULLPAK-IRLIZ14GPBF-ND
U$5, U$10: PM61300-4-RC
U$6, U$15, U$16, U$23: PZT3904-SOT223-SCHEMATICS; SOT223-PZT3904
U$7, U$8, U$11, U$12: S1J-SCHEMATICS; DO-214AC-S1J
U$13, U$14: RESISTOR-J-LEAD-5W; PACKAGE-13573-J-LEAD
U$17, U$18, U$19, U$20, U$21, U$22: SMBJ5388B-ZENER-DIODE-200V; DO-214AA-SMBJ5388B-ZENER

Connections:
5V: R10.2, U$3.P$1, U$15.P$1 (C), U$16.P$1 (C), U$23.P$1 (C)
G-M-CATHODE: R8.2, R19.2, U$1.P$2
G-M-COUNTS: R10.1, U$2.P$3, U$6.P$1 (C)
G-M-OUTPUT: U$1.P$3
G-M-OUTPUT-AMPLITUDE: R20.1, U$2.P$8, U$23.P$4 (E)
GND1: C1.2, C8.2, R2.1, R4.1, R6.1, R7.1, R13.1, R15.1, R17.1, R18.1, R20.2, U$3.P$2, U$4.P$1 (S), U$9.P$1 (S)
GND2: C3.2, C4.2, C5.2, C6.2, C7.2, C10.2, C11.2, C12.2, C14.2, C15.2, C16.2, C18.2, C19.2, C20.2, C21.2, C22.2, C23.2, C24.2, C26.2, C30.2, C31.2, C32.2, C33.2, C34.2, C35.2, C36.2, C37.2, R5.1, R9.1, R11.1, R16.1, U$3.P$3, U$8.P$1 (A), U$12.P$1 (A), U$19.P$1, U$22.P$1
GND3: U$3.P$4, U$6.P$4 (E)
HV_G-M-ANODE1: C14.1, C15.1, C36.1, R1.2, R5.2, U$1.P$1, U$7.P$2 (C), U$17.P$2
HV_G-M-ANODE2: C16.1, C26.1, C37.1, R12.2, R16.2, U$1.P$4, U$11.P$2 (C), U$20.P$2
HV_OUTPUT1: R7.2, U$2.P$5, U$15.P$4 (E)
HV_OUTPUT2: R17.2, U$2.P$6, U$16.P$4 (E)
unnamed: R3.1, U$4.P$3 (G)
unnamed: U$17.P$1, U$18.P$2
unnamed: C13.1, U$5.10
unnamed: C13.2, U$7.P$1 (A), U$8.P$2 (C)
unnamed: R12.1, R18.2, U$16.P$2 (B)
unnamed: C3.1, C4.1, C5.1, C6.1, C7.1, C11.1, C12.1, C19.1, C20.1, C21.1, U$5.6
unnamed: U$5.3, U$13.P$2
unnamed: C2.2, R2.2
unnamed: C10.1, C22.1, C23.1, C24.1, C30.1, C31.1, C32.1, C33.1, C34.1, C35.1, U$10.6
unnamed: C2.1, U$4.P$2 (D), U$13.P$1
unnamed: R14.1, U$9.P$3 (G)
unnamed: C9.2, R13.2
unnamed: U$10.3, U$14.P$2
unnamed: C9.1, U$9.P$2 (D), U$14.P$1
unnamed: R1.1, R6.2, U$15.P$2 (B)
unnamed: C25.1, U$10.10
unnamed: C25.2, U$11.P$1 (A), U$12.P$2 (C)
unnamed: U$18.P$1, U$19.P$2
unnamed: U$20.P$1, U$21.P$2
unnamed: U$21.P$1, U$22.P$2
unnamed: C18.1, R8.1, R11.2, U$6.P$2 (B)
unnamed: R9.2, R19.1, U$23.P$2 (B)
PULSE1: R3.2, R4.2, U$2.P$1
PULSE2: R14.2, R15.2, U$2.P$7
VOLTAGE_SWEEP1: C1.1, U$2.P$2, U$5.1
VOLTAGE_SWEEP2: C8.1, U$2.P$4, U$10.1

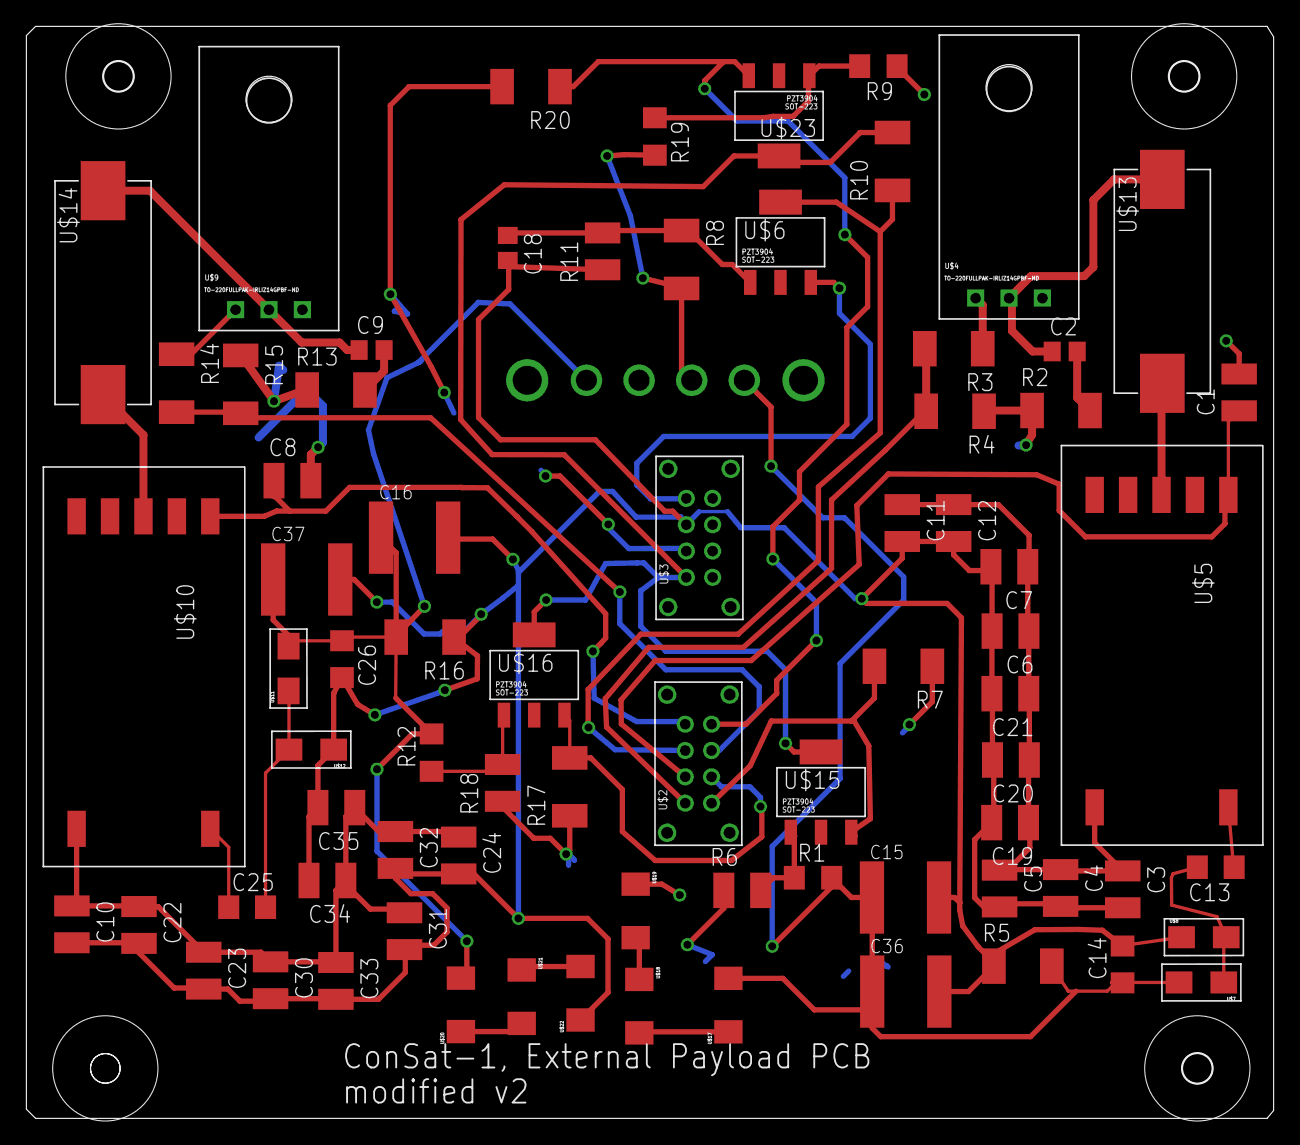
[picture p17: board payload-externalPCB-version2-modif2.brd from above]

Board: 4 copper layers, 94.8 x 83.0 mm, 76 parts (1 on the bottom side), 37 nets.
