spaceconcordia/Consat1Electrical/CDH/CDH-v3.7.brd

## EAGLE design CDH/CDH-v3.7.brd (2015-08-10)

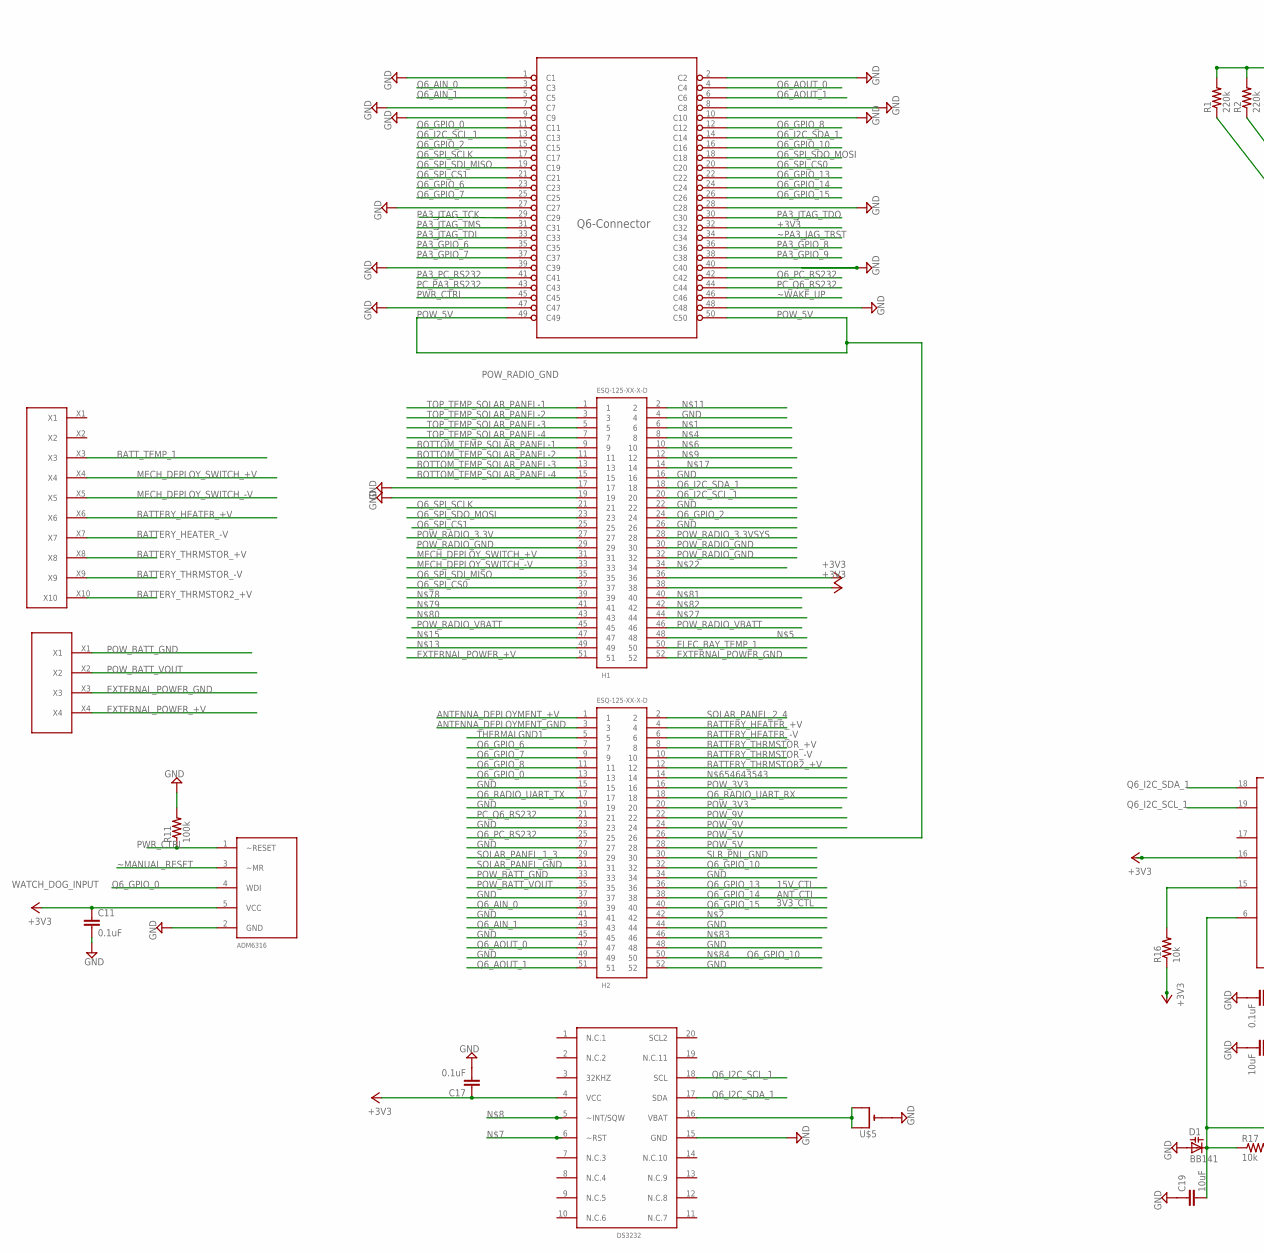
[picture p18: schematic CDH-v3.7.sch, part in row 1, column 1]

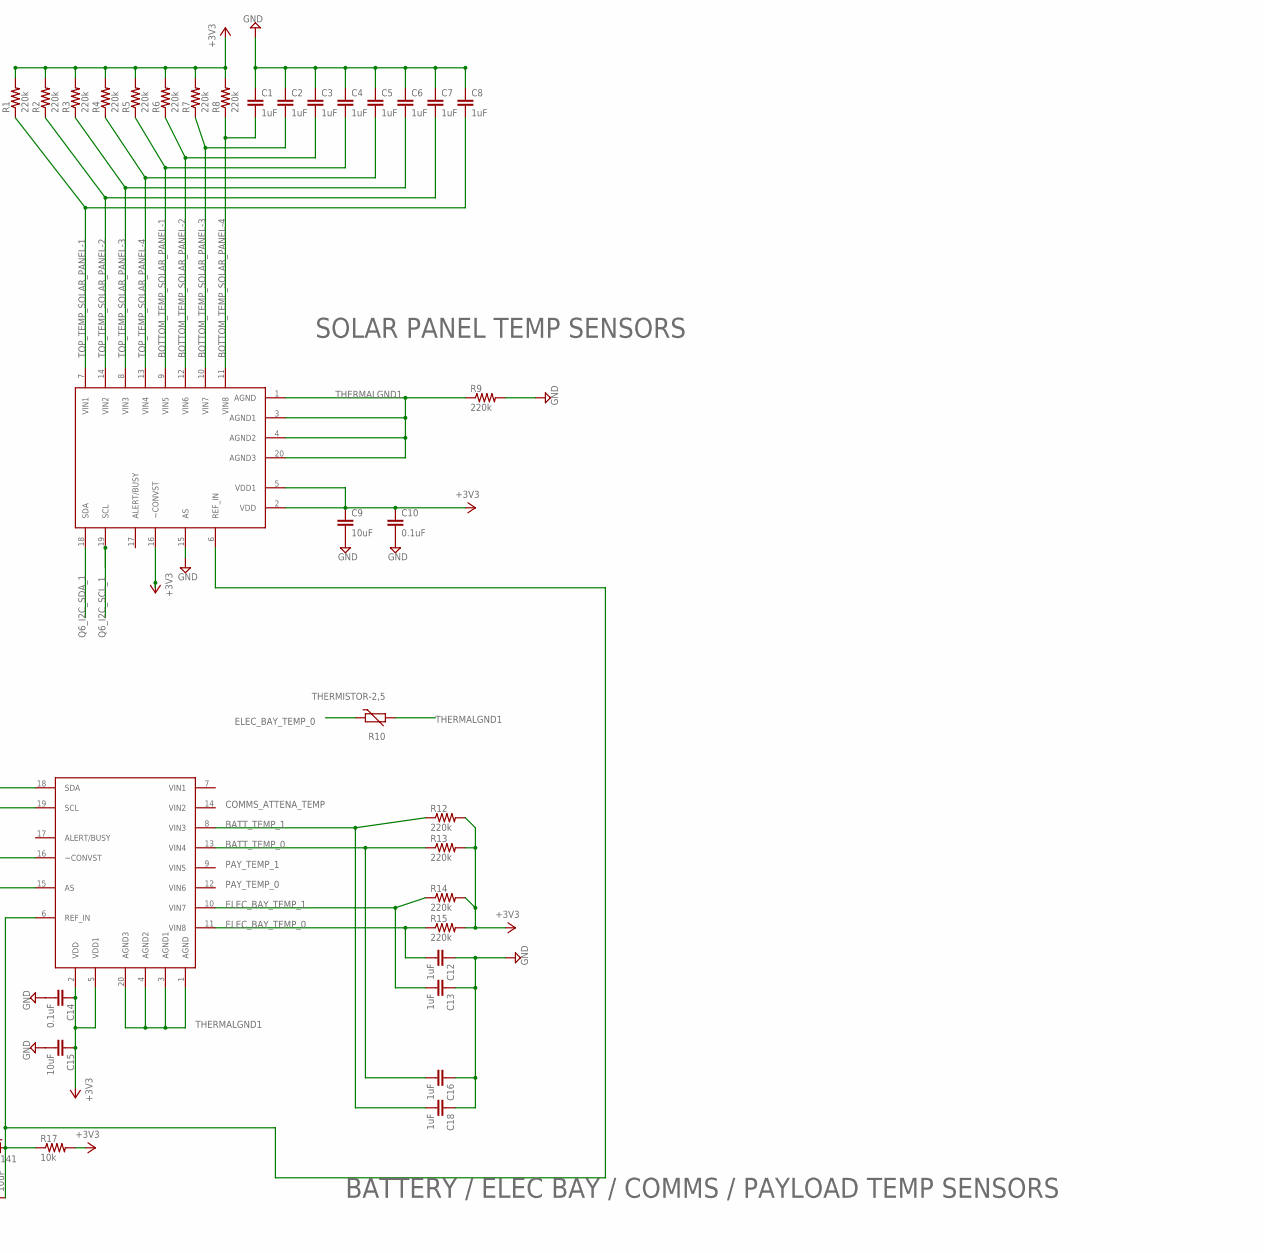
[picture p19: schematic CDH-v3.7.sch, part in row 1, column 2]

Parts:
ADC_TEMP_1, ADC_TEMP_2: AD7998-1; TSSOP20
C1, C2, C3, C4, C5, C6, C7, C8, C12, C13, C16, C18: 1uF; C2012
C9, C15, C19: 10uF; C2012
C10, C11, C14, C17: 0.1uF; C2012
D1: BB141; SOD523
H1, H2: ESQ-125-XX-X-D
R1, R2, R3, R4, R5, R6, R7, R8, R9, R12, R13, R14, R15: 220k; R2012
R10: THERMISTOR-2,5; RS-2,5
R11: 100k; R2012
R16, R17: 10k; R2012
U$1: SMFC; SFMC-107-01-XX-D
U$2: M80-5000000M1-10-331-000; M80-5000000M1
U$3: M80-5000000M1-10-331-00-000; M80-5000000M1-04-331-00-000
U$4: ADM6316/ADM6320; SOT23-5
U$5: CR1220SMT; CR1220-SMD
U$6: DS3232; SO20L

Connections:
+3V3: ADC_TEMP_1.2 (VDD), ADC_TEMP_1.5 (VDD1), ADC_TEMP_1.16 (~CONVST), ADC_TEMP_2.2 (VDD), ADC_TEMP_2.5 (VDD1), ADC_TEMP_2.16 (~CONVST), C9.1, C10.1, C11.1, C14.1, C15.1, C17.1, H1.36, H1.38, R1.2, R2.2, R3.2, R4.2, R5.2, R6.2, R7.2, R8.2, R12.2, R13.2, R14.2, R15.2, R16.1, R17.2, U$1.32 (C32), U$4.5 (VCC), U$6.4 (VCC)
ANTENNA_DEPLOYMENT_+V: H2.1
ANTENNA_DEPLOYMENT_GND: H2.3
BATTERY_HEATER_+V: H2.4, U$2.X6
BATTERY_HEATER_-V: H2.6, U$2.X7
BATTERY_THRMSTOR2_+V: H2.12, U$2.X10
BATTERY_THRMSTOR_+V: H2.8, U$2.X8
BATTERY_THRMSTOR_-V: H2.10, U$2.X9
BATT_TEMP_0: ADC_TEMP_2.13 (VIN4), C16.2, R13.1
BATT_TEMP_1: ADC_TEMP_2.8 (VIN3), C18.2, R12.1, U$2.X3
BOTTOM_TEMP_SOLAR_PANEL-1: ADC_TEMP_1.9 (VIN5), C4.2, H1.9, R5.1
BOTTOM_TEMP_SOLAR_PANEL-2: ADC_TEMP_1.12 (VIN6), C3.2, H1.11, R6.1
BOTTOM_TEMP_SOLAR_PANEL-3: ADC_TEMP_1.10 (VIN7), C2.2, H1.13, R7.1
BOTTOM_TEMP_SOLAR_PANEL-4: ADC_TEMP_1.11 (VIN8), C1.2, H1.15, R8.1
ELEC_BAY_TEMP_0: ADC_TEMP_2.11 (VIN8), C12.2, R10.1, R15.1
ELEC_BAY_TEMP_1: ADC_TEMP_2.10 (VIN7), C13.2, H1.50, R14.1
EXTERNAL_POWER_+V: H1.51, U$3.X4
EXTERNAL_POWER_GND: H1.52, U$3.X3
GND: ADC_TEMP_1.15 (AS), C1.1, C2.1, C3.1, C4.1, C5.1, C6.1, C7.1, C8.1, C9.2, C10.2, C11.2, C12.1, C13.1, C14.2, C15.2, C16.1, C17.2, C18.1, C19.1, D1.A, H1.4, H1.16, H1.17, H1.19, H1.22, H1.26, H2.15, H2.19, H2.23, H2.27, H2.34, H2.37, H2.41, H2.44, H2.45, H2.48, H2.49, H2.52, R9.2, R11.2, U$1.1 (C1), U$1.2 (C2), U$1.7 (C7), U$1.8 (C8), U$1.9 (C9), U$1.10 (C10), U$1.27 (C27), U$1.28 (C28), U$1.39 (C39), U$1.40 (C40), U$1.47 (C47), U$1.48 (C48), U$4.2 (GND), U$5.-, U$6.15 (GND)
MECH_DEPLOY_SWITCH_+V: H1.31, U$2.X4
MECH_DEPLOY_SWITCH_-V: H1.33, U$2.X5
unnamed: ADC_TEMP_2.15 (AS), R16.2
PA3_GPIO_6: U$1.35 (C35)
PA3_GPIO_7: U$1.37 (C37)
PA3_GPIO_8: U$1.36 (C36)
PA3_GPIO_9: U$1.38 (C38)
PA3_JTAG_TCK: U$1.29 (C29)
PA3_JTAG_TDI: U$1.33 (C33)
PA3_JTAG_TDO: U$1.30 (C30)
PA3_JTAG_TMS: U$1.31 (C31)
PA3_PC_RS232: U$1.41 (C41)
PC_PA3_RS232: U$1.43 (C43)
PC_Q6_RS232: H2.21, U$1.44 (C44)
POW_3V3: H2.16, H2.20
POW_5V: H2.26, H2.28, U$1.49 (C49), U$1.50 (C50)
POW_9V: H2.22, H2.24
POW_BATT_GND: H2.33, U$3.X1
POW_BATT_VOUT: H2.35, U$3.X2
POW_RADIO_3.3V: H1.27
POW_RADIO_3.3VSYS: H1.28
POW_RADIO_GND: H1.29, H1.30, H1.32
POW_RADIO_VBATT: H1.45, H1.46
PWR_CTRL: R11.1, U$1.45 (C45), U$4.1 (~RESET)
Q6_AIN_0: H2.39, U$1.3 (C3)
Q6_AIN_1: H2.43, U$1.5 (C5)
Q6_AOUT_0: H2.47, U$1.4 (C4)
Q6_AOUT_1: H2.51, U$1.6 (C6)
Q6_GPIO_0: H2.13, U$1.11 (C11), U$4.4 (WDI)
Q6_GPIO_2: H1.24, U$1.15 (C15)
Q6_GPIO_6: H2.7, U$1.23 (C23)
Q6_GPIO_7: H2.9, U$1.25 (C25)
Q6_GPIO_8: H2.11, U$1.12 (C12)
Q6_GPIO_10: H2.32, U$1.16 (C16)
Q6_GPIO_13: H2.36, U$1.22 (C22)
Q6_GPIO_14: H2.38, U$1.24 (C24)
Q6_GPIO_15: H2.40, U$1.26 (C26)
Q6_I2C_SCL_1: ADC_TEMP_1.19 (SCL), ADC_TEMP_2.19 (SCL), H1.20, U$1.13 (C13), U$6.18 (SCL)
Q6_I2C_SDA_1: ADC_TEMP_1.18 (SDA), ADC_TEMP_2.18 (SDA), H1.18, U$1.14 (C14), U$6.17 (SDA)
Q6_PC_RS232: H2.25, U$1.42 (C42)
Q6_RADIO_UART_RX: H2.18
Q6_RADIO_UART_TX: H2.17
Q6_SPI_CS0: H1.37, U$1.20 (C20)
Q6_SPI_CS1: H1.25, U$1.21 (C21)
Q6_SPI_SCLK: H1.21, U$1.17 (C17)
Q6_SPI_SDI_MISO: H1.35, U$1.19 (C19)
Q6_SPI_SDO_MOSI: H1.23, U$1.18 (C18)
REF_IN: ADC_TEMP_1.6 (REF_IN), ADC_TEMP_2.6 (REF_IN), C19.2, D1.C, R17.1
SLR_PNL_GND: H2.30
SOLAR_PANEL_1_3: H2.29
SOLAR_PANEL_2_4: H2.2
SOLAR_PANEL_GND: H2.31
THERMALGND1: ADC_TEMP_1.1 (AGND), ADC_TEMP_1.3 (AGND1), ADC_TEMP_1.4 (AGND2), ADC_TEMP_1.20 (AGND3), ADC_TEMP_2.1 (AGND), ADC_TEMP_2.3 (AGND1), ADC_TEMP_2.4 (AGND2), ADC_TEMP_2.20 (AGND3), H2.5, R9.1, R10.2
TOP_TEMP_SOLAR_PANEL-1: ADC_TEMP_1.7 (VIN1), C8.2, H1.1, R1.1
TOP_TEMP_SOLAR_PANEL-2: ADC_TEMP_1.14 (VIN2), C7.2, H1.3, R2.1
TOP_TEMP_SOLAR_PANEL-3: ADC_TEMP_1.8 (VIN3), C6.2, H1.5, R3.1
TOP_TEMP_SOLAR_PANEL-4: ADC_TEMP_1.13 (VIN4), C5.2, H1.7, R4.1
VBAT: U$5.+$1 (+), U$5.+$2 (+1), U$6.16 (VBAT)
~MANUAL_RESET: U$4.3 (~MR)
~PA3_JAG_TRST: U$1.34 (C34)
~WAKE_UP: U$1.46 (C46)

Notes on the sheet:
POW_RADIO_GND
Q6_AOUT_0
Q6_AOUT_1
SOLAR PANEL TEMP SENSORS
BATTERY / ELEC BAY / COMMS / PAYLOAD TEMP SENSORS
ELEC_BAY_TEMP_0
ELEC_BAY_TEMP_1
PAY_TEMP_0
PAY_TEMP_1
BATT_TEMP_0
BATT_TEMP_1
COMMS_ATTENA_TEMP
Q6-Connector
15V_CTL
ANT_CTL
SOLAR_PANEL_2_4
3V3_CTL
Q6_GPIO_10
WATCH_DOG_INPUT

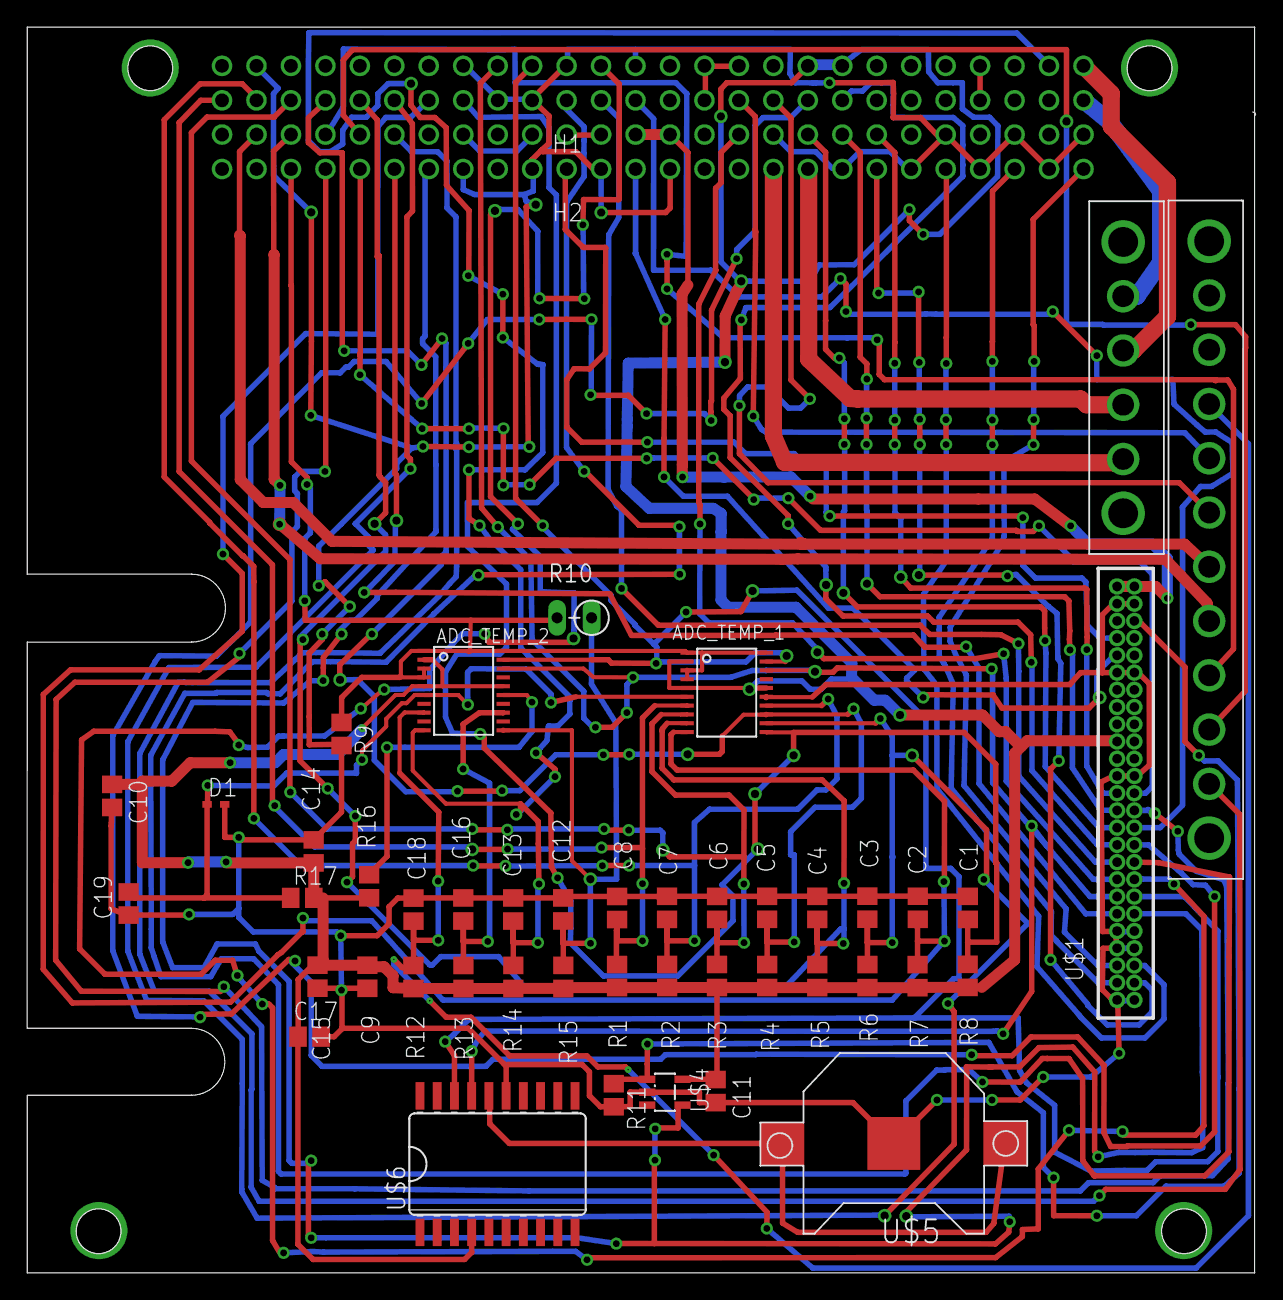
[picture p20: board CDH-v3.7.brd from above]

Board: 4 copper layers, 90.5 x 91.8 mm, 47 parts (0 on the bottom side), 57 nets.
