spaceconcordia/Consat1Electrical/ACS/ACS_PCB.brd

## EAGLE design ACS/ACS_PCB.brd (2015-08-10)

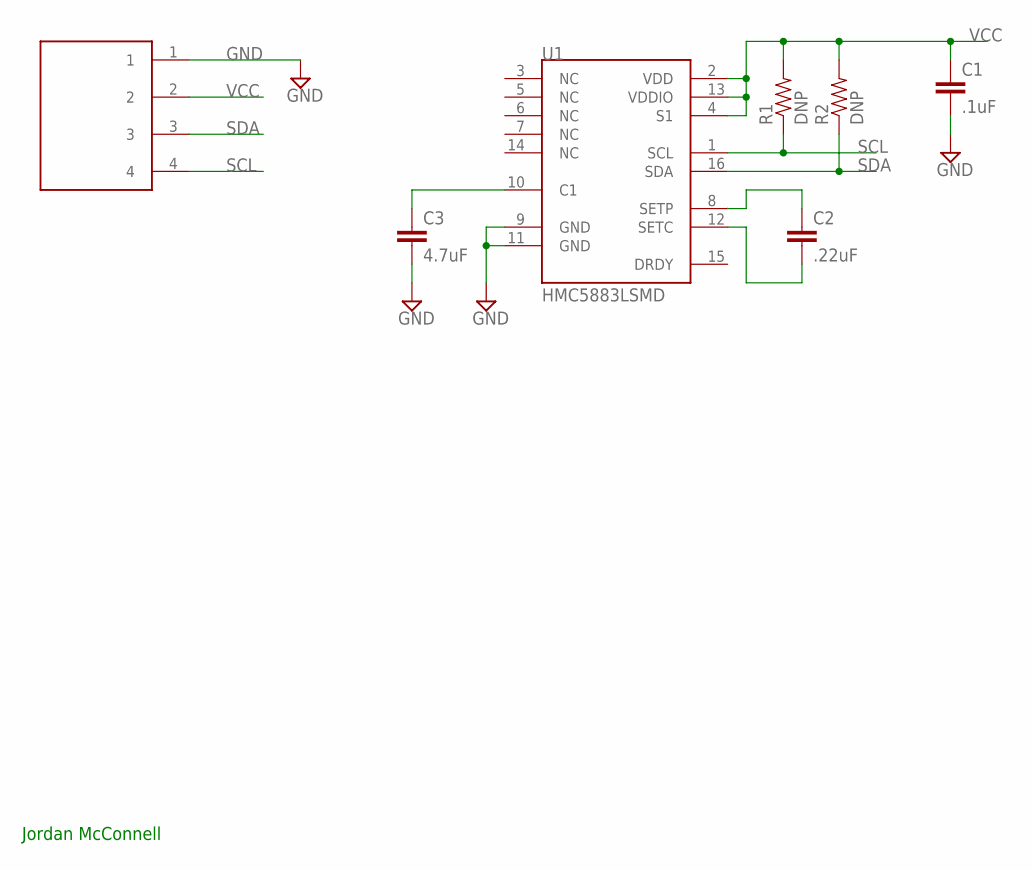
[picture p21: schematic ACS_PCB.sch]

Parts:
C1: .1uF; 0402-CAP
C2: .22uF; 0402-CAP
C3: 4.7uF; 0402-CAP
JP1: M80-879
R1, R2: DNP; 0402-RES
U1: HMC5883LSMD; 16LPCC

Connections:
GND: C1.2, C3.2, JP1.1, U1.9 (GND), U1.11 (GND)
unnamed: C3.1, U1.10 (C1)
unnamed: C2.1, U1.8 (SETP)
unnamed: C2.2, U1.12 (SETC)
SCL: JP1.4, R1.1, U1.1 (SCL)
SDA: JP1.3, R2.1, U1.16 (SDA)
VCC: C1.1, JP1.2, R1.2, R2.2, U1.2 (VDD), U1.4 (S1), U1.13 (VDDIO)

Notes on the sheet:
Jordan McConnell

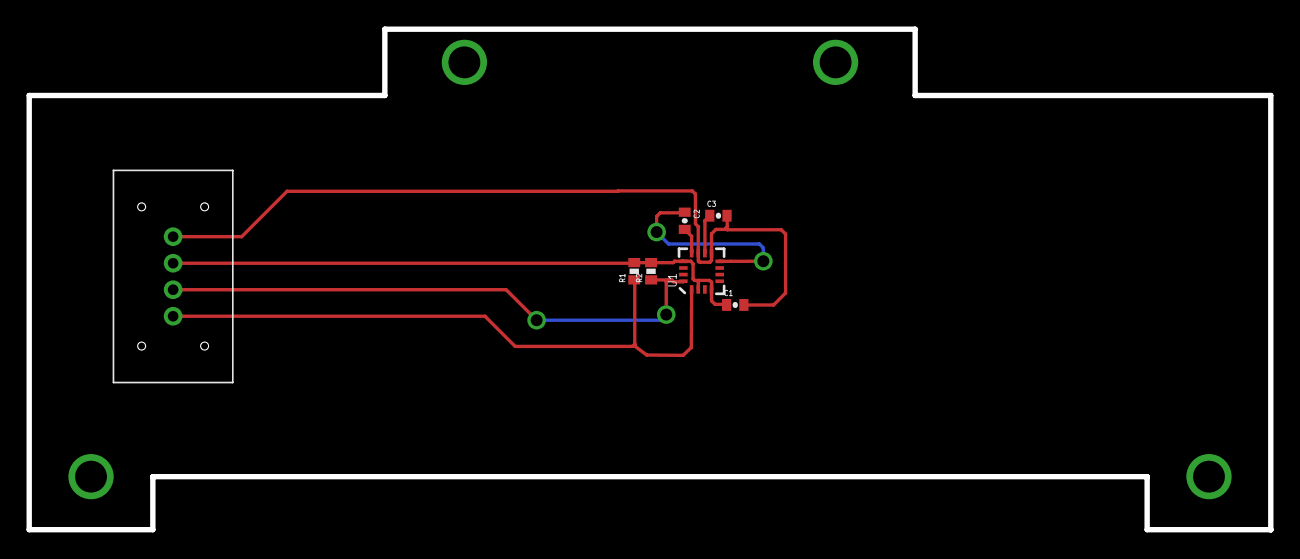
[picture p22: board ACS_PCB.brd from above]

Board: 2 copper layers, 93.7 x 37.8 mm, 7 parts (0 on the bottom side), 7 nets.
