spaceconcordia/Consat1Electrical/Diplexer/diplexer_v4rev0-layout.brd

## EAGLE design Diplexer/diplexer_v4rev0-layout.brd (2015-08-10)

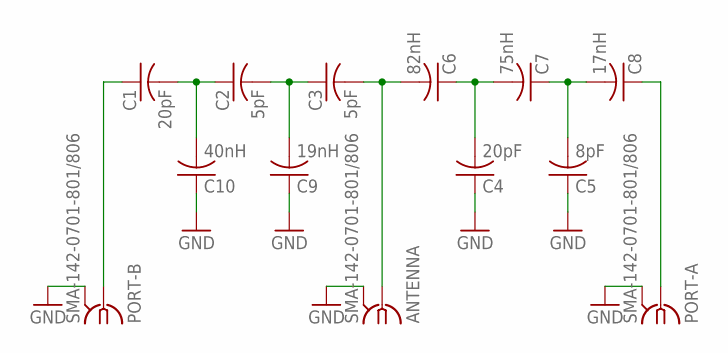
[picture p23: schematic diplexer_v4rev0-schematic.sch]

Parts:
ANTENNA: SMA-142-0701-801/806; J502-ND-142-0701-801/806
C1, C4: 20pF; C1608
C2, C3: 5pF; C2012
C5: 8pF; C2012
C6: 82nH; C1608
C7: 75nH; C1005
C8: 17nH; C1005
C9: 19nH; C1005
C10: 40nH; C1005
PORT-A: SMA-142-0701-801/806; J502-ND-142-0701-801/806
PORT-B: SMA-142-0701-801/806; J502-ND-142-0701-801/806

Connections:
GND: ANTENNA.G@1 (GND), ANTENNA.G@2 (GND), ANTENNA.G@3 (GND), ANTENNA.G@4 (GND), C4.1, C5.1, C9.1, C10.1, PORT-A.G@1 (GND), PORT-A.G@2 (GND), PORT-A.G@3 (GND), PORT-A.G@4 (GND), PORT-B.G@1 (GND), PORT-B.G@2 (GND), PORT-B.G@3 (GND), PORT-B.G@4 (GND)
unnamed: C8.1, PORT-A.1
unnamed: C5.2, C7.1, C8.2
unnamed: C4.2, C6.1, C7.2
unnamed: C1.1, PORT-B.1
unnamed: ANTENNA.1, C3.2, C6.2
unnamed: C2.2, C3.1, C9.2
unnamed: C1.2, C2.1, C10.2

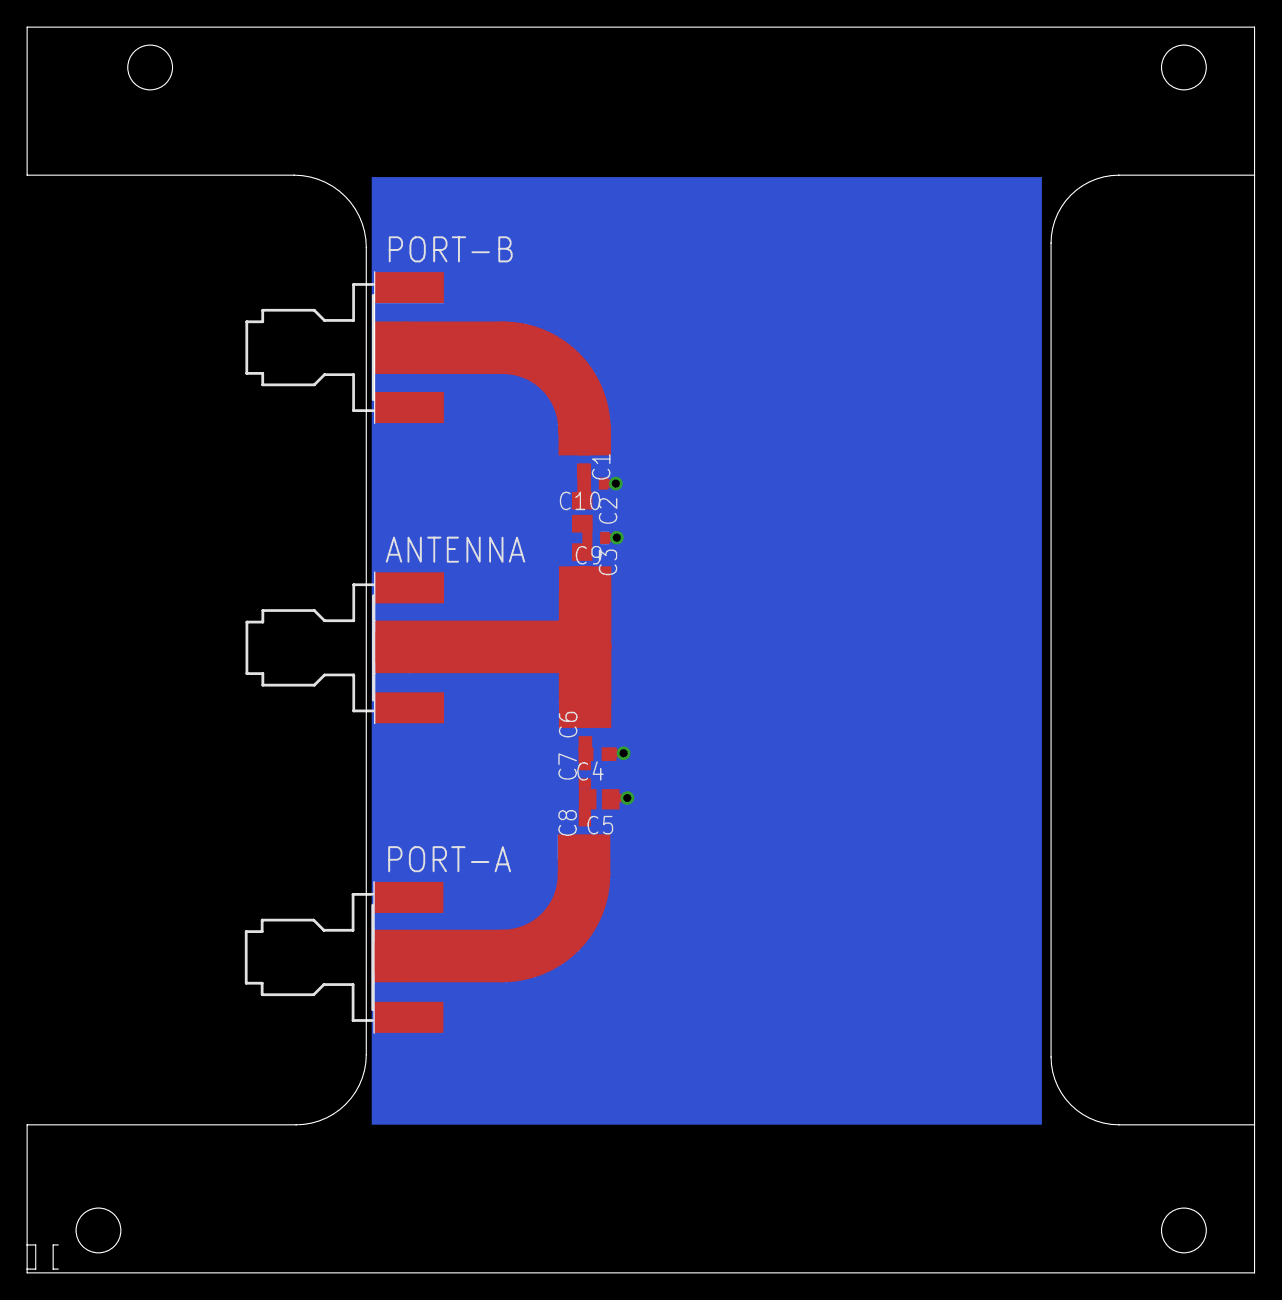
[picture p24: board diplexer_v4rev0-layout.brd from above]

Board: 2 copper layers, 90.5 x 91.8 mm, 13 parts (0 on the bottom side), 8 nets.
