spaceconcordia/Consat1Electrical/Solar Panels/panel - type I - front - complete measurements.brd

## EAGLE design Solar Panels/panel - type I - front - complete measurements.brd (2015-08-10)

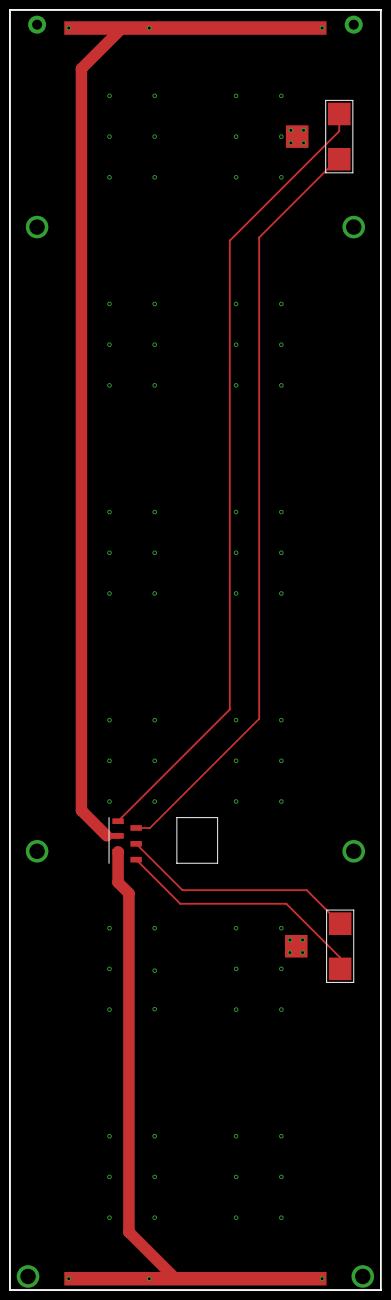
[picture p25: board panel - type I - front - complete measurements.brd from above]

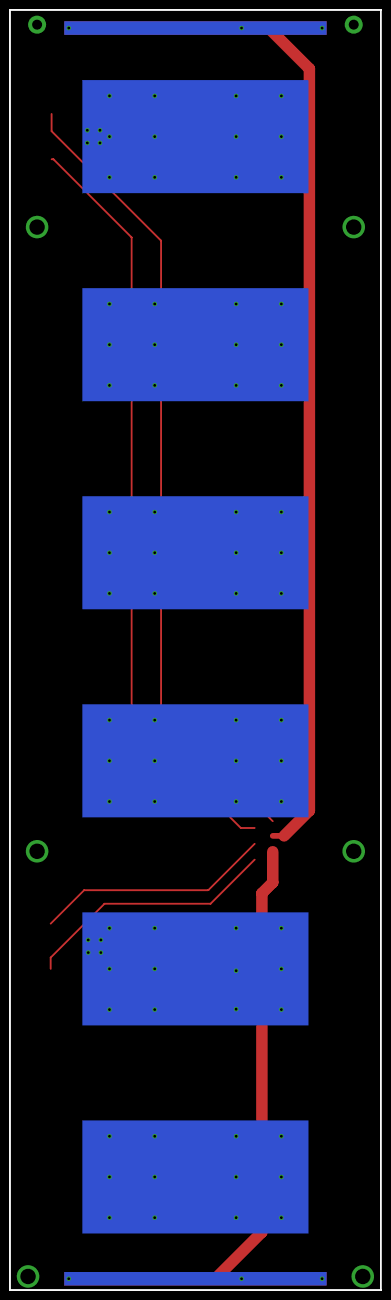
[picture p26: board panel - type I - front - complete measurements.brd from below]

Board: 4 copper layers, 82.0 x 283.0 mm, 13 parts (8 on the bottom side), 6 nets.

Parts:
E$1, E$2: GENERIC-2PORT
E$3: M80-8120605-SM
E$5, E$14: SOLARPNL_CIC_PAD
E$6, E$7: SMD_THRM_PAD
E$8, E$9, E$10, E$11, E$12, E$13: SOLARPNL_THRM_PAD

Connections:
S$1: E$2.P$2, E$3.P$6
S$2: E$2.P$1, E$3.P$2
S$3: E$1.P$1, E$3.P$4
S$4: E$1.P$2, E$3.P$7
S$5: E$3.P$1, E$14.P$3
S$6: E$3.P$3, E$5.P$3
