spaceconcordia/Consat1Electrical/(commit log)

2015-08-10 Initial commit, the drawings are for Consat1, Build #2, November 2013
    Changes to be committed:
    new file: .gitignore
    new file: ACS/ACS_PCB.GBL
    new file: ACS/ACS_PCB.GBO
    new file: ACS/ACS_PCB.GBS
    new file: ACS/ACS_PCB.GTL
    new file: ACS/ACS_PCB.GTO
    new file: ACS/ACS_PCB.GTP
    new file: ACS/ACS_PCB.GTS
    new file: ACS/ACS_PCB.TXT
    new file: ACS/ACS_PCB.brd
    new file: ACS/ACS_PCB.dri
    new file: ACS/ACS_PCB.gpi
    new file: ACS/ACS_PCB.pdf
    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
    [104 PIN HEADER.ods, 20131201 - Continuity Check.ods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]
2015-08-14 Removed payload exterior v1; This design did not meet the voltage requirements
    On branch cs1benchsat
    deleted: Payload External/Payload_exterior v1.0.brd
    deleted: Payload External/Payload_exterior v1.0.cmp
    deleted: Payload External/Payload_exterior v1.0.drd
    deleted: Payload External/Payload_exterior v1.0.dri
    deleted: Payload External/Payload_exterior v1.0.drl
    deleted: Payload External/Payload_exterior v1.0.gpi
    deleted: Payload External/Payload_exterior v1.0.pdf
    deleted: Payload External/Payload_exterior v1.0.plc
    deleted: Payload External/Payload_exterior v1.0.pro
    deleted: Payload External/Payload_exterior v1.0.sch
    deleted: P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
    [Payload_exterior v1.0.brd, Payload_exterior v1.0.sch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]
2015-08-14 Directory rename CDH-V3.7 -> CDH
    [CDH-v3.7.brd, CDH-v3.7.sch]
2015-08-14 Updates to CDH subsystem
    deleted: CDH-v3.7.pro
    deleted: CDH-v3.7_PCB_Final_Design.pdf
    renamed: CDH-v3.7.brd -> CDH-v4.1.brd
    new file: CDH-v4.1.pro
    renamed: CDH-v3.7.sch -> CDH-v4.1.sch
    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
    [CDH-v4.1.brd, CDH-v4.1.sch]
2015-08-14 Further updates to CDH Added design v2 of the payload external pcb
    deleted: CDH/CDH-v4.1.brd
    deleted: CDH/CDH-v4.1.pro
    new file: CDH/CDH-v4.11-A-DS1338-tcc-test-redesign.brd
    renamed: CDH/CDH-v4.1.sch -> CDH/CDH-v4.11-A-DS1338-tcc-test-redesign.sch
    new file: Payload External/payload-externalPCB-version2-modif2.brd
    new file: Payload External/payload-externalPCB-version2-modif2.sch
    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
    [CDH-v4.1.brd, CDH-v4.11-A-DS1338-tcc-test-redesign.brd, CDH-v4.11-A-DS1338-tcc-test-redesign.sch, payload-externalPCB-version2-modif2.brd, payload-externalPCB-version2-modif2.sch]
2015-08-14 Added working version of v2 payload external schematic Added Libraries dir
    new file: Libraries/space-concordia-power.lbr
    modified: Payload External/payload-externalPCB-version2-modif2.brd
    modified: Payload External/payload-externalPCB-version2-modif2.sch
    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
    [payload-externalPCB-version2-modif2.brd, payload-externalPCB-version2-modif2.sch]
2015-09-04 pulled in the updated wiring harness from cs1bld2 branch
    [20131201 - Continuity Check.ods, Consat1 Wiring Harness BOM.ods, wiring-harness-complete-v1.0.sch]
2015-09-04 pulled in updates in libraries, internal payload schematic, grounding arch and BOMs from cs1bld2 branch
    [ACS PCB bom.csv, Payload v2.1 bom.csv, Payload v2.1.sch, diplexer_v4rev0-bom.csv]
2015-09-04 brought in version 1.1 of the EPS
    [eps-v1-1-bom.ods, eps-v1-1.brd, eps-v1-1.sch]
2015-09-10 updated internal payload schematic to v3.6
    [Auxiliary-Payload v3.6.brd, Auxiliary-Payload v3.6.sch, Payload v2.1 bom.csv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]
2015-09-10 Update payload internal to version 4.2
    [Auxiliary-Payload v4.2.brd, Auxiliary-Payload v4.2.sch]
2015-09-17 Updated grounding diagram: Added external payload block Updated all payload blocks with more grounding connectors
2015-09-17 Updated notes on grounding diagram
2015-09-28 Updated some header descriptions and labels
    [104 PIN HEADER.ods, CDH-v4.11-A-DS1338-tcc-test-redesign.brd, CDH-v4.11-A-DS1338-tcc-test-redesign.sch]
2015-09-30 Added antenna and ACS to grounding diagram
2015-10-27 worked on the wiring harness: - fixed some signals between ext payload and int payload - added wire data.ods sheet
    ran 'snap to grid' on internal payload schematic
    [Auxiliary-Payload v4.2.sch, Wire Data.ods, wiring-harness-complete-v1.0.sch]
2015-11-15 Wiring Harness - review and update wire data spreadsheet with Pierre-Lucas - review and update schematic to track spreadsheet
    misc
    - updated gitignore to ignore libreoffice locks
    [Wire Data.ods, wiring-harness-complete-v1.0.sch]
